gdevic/A-Z80/docs/Spectrum-VGA-timings.xlsx

Sheet: Graphical
 |  | Sinclair ZX Spectrum on FPGA
 |  | VGA timings
 |  |  | Display area in 8x8 characters: |  |  | 32 | 24
 |  |  | Effective screen resolution: |  |  | 256 | 192 | doubled
 |  | 96 | 48 | 640 |  |  | 16
 |  | 96 | 48 | 64 | 512 | 64 | 16
2 | 2 |  |  |  | V-SYNC |  |  | 0
33 | 33 |  |  |  | BACK PORCH |  |  | 2
480 | 48 |  |  |  | Spectrum border |  |  | 35
 | 384 | H-SYNC | BACK PORCH |  | Spectrum display area (256x192) |  | FRONT PORCH | 83
 | 48 |  |  |  |  |  |  | 467
10 | 10 |  |  |  | FRONT PORCH |  |  | 515
 |  | 0 | 96 | 144 | 208 | 720 | 784 |  | 525
 |  |  |  |  |  |  |  | 800
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
