gdevic/A-Z80/docs/png/z80-address_pins.png

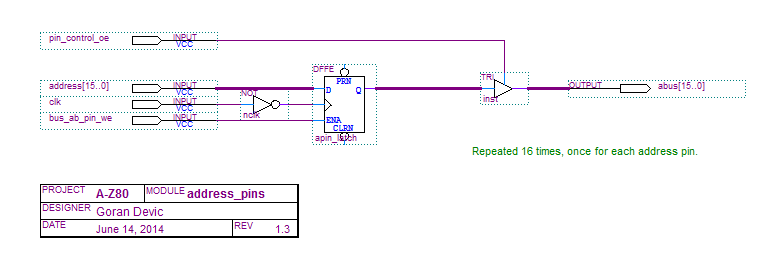
docs/png/z80-address_pins.png
