gdevic/A-Z80/docs/png/z80-alu.png

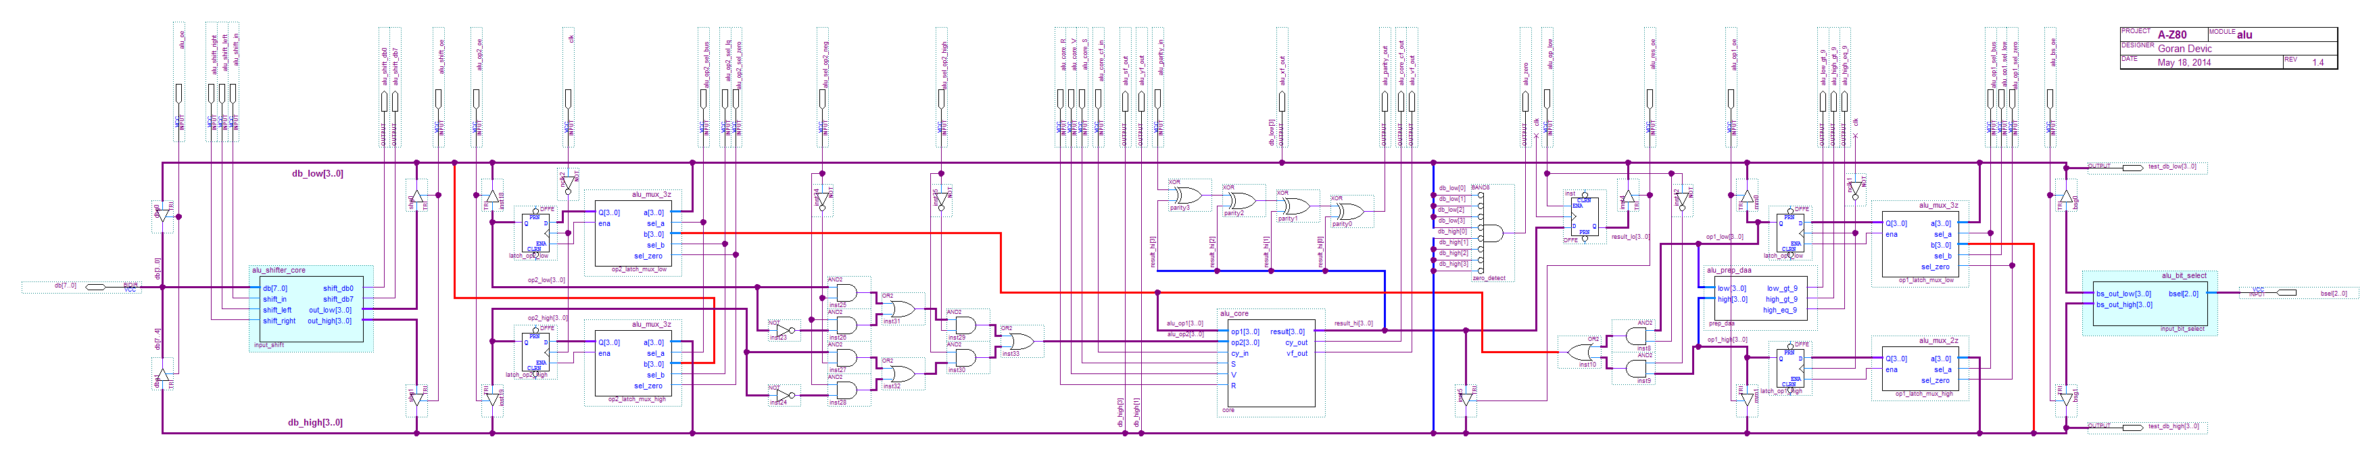
docs/png/z80-alu.png
