gdevic/A-Z80/docs/png/z80-alu_bit_select.png

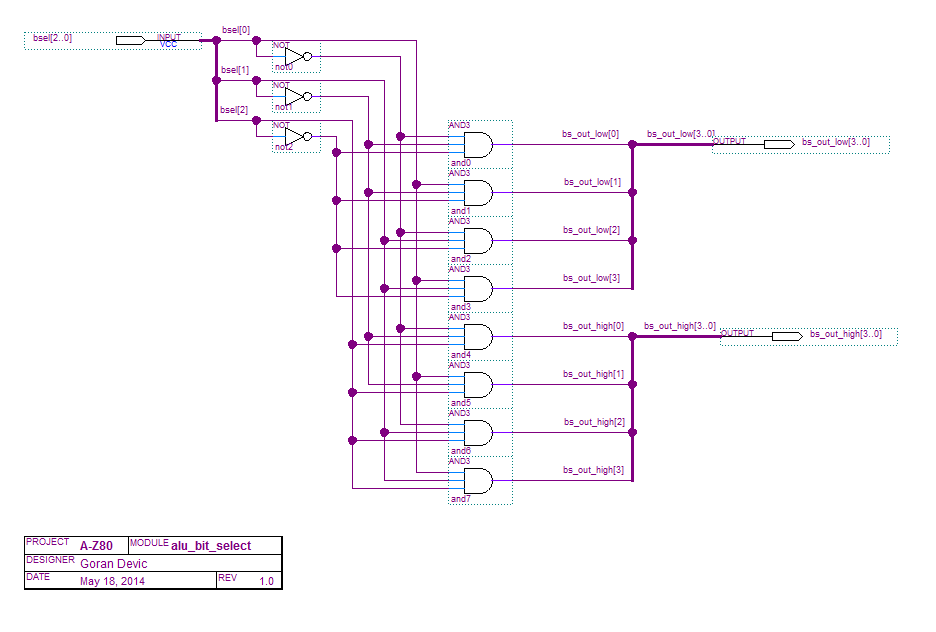
docs/png/z80-alu_bit_select.png
