gdevic/A-Z80/docs/png/z80-alu_control.png

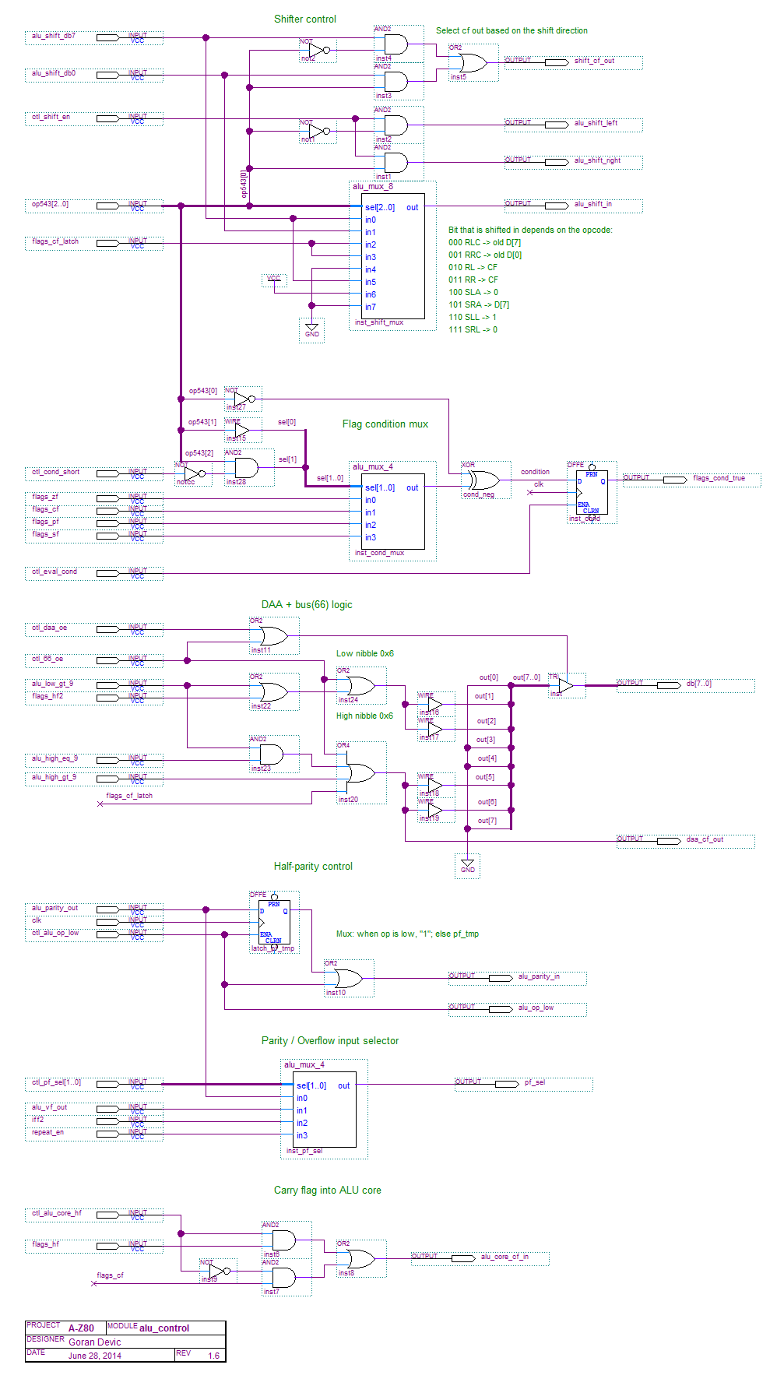
docs/png/z80-alu_control.png
