gdevic/A-Z80/docs/png/z80-alu_core.png

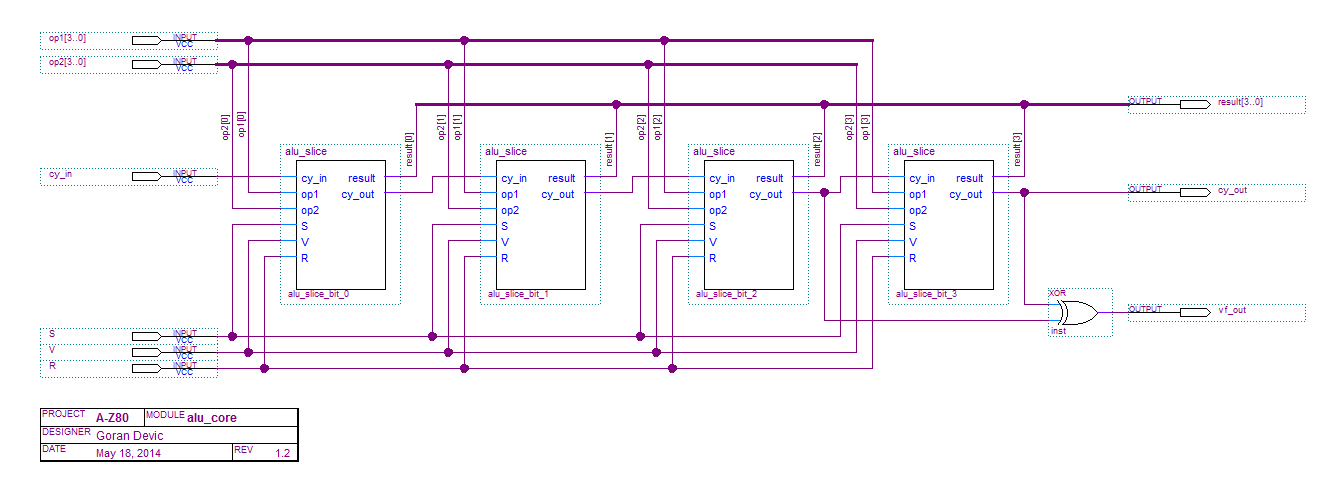
docs/png/z80-alu_core.png
