gdevic/A-Z80/docs/png/z80-alu_flags.png

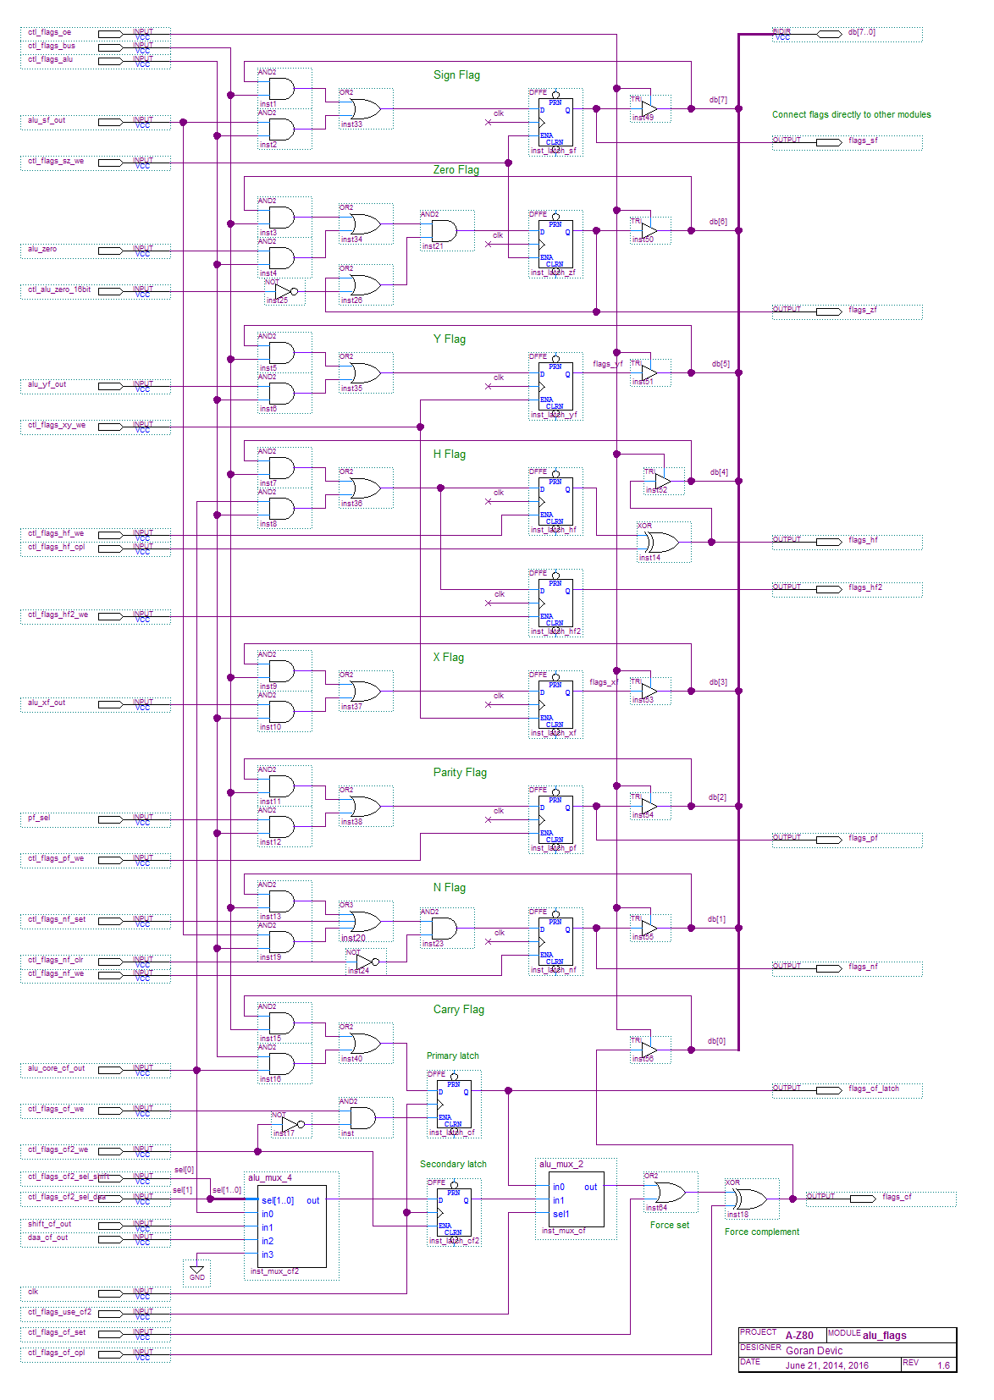
docs/png/z80-alu_flags.png
