gdevic/A-Z80/docs/png/z80-alu_mux_2z.png

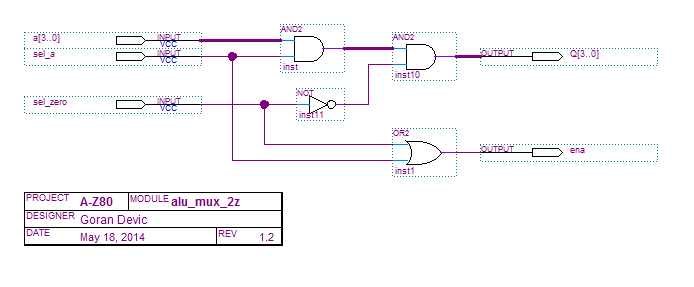
docs/png/z80-alu_mux_2z.png
