gdevic/A-Z80/docs/png/z80-alu_mux_3z.png

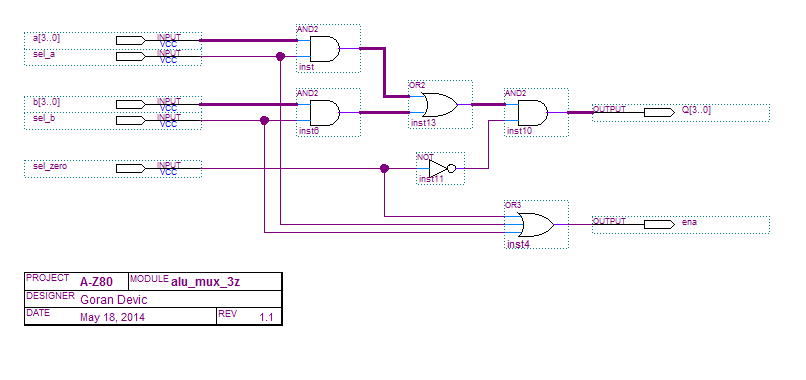
docs/png/z80-alu_mux_3z.png
