gdevic/A-Z80/docs/png/z80-alu_mux_8.png

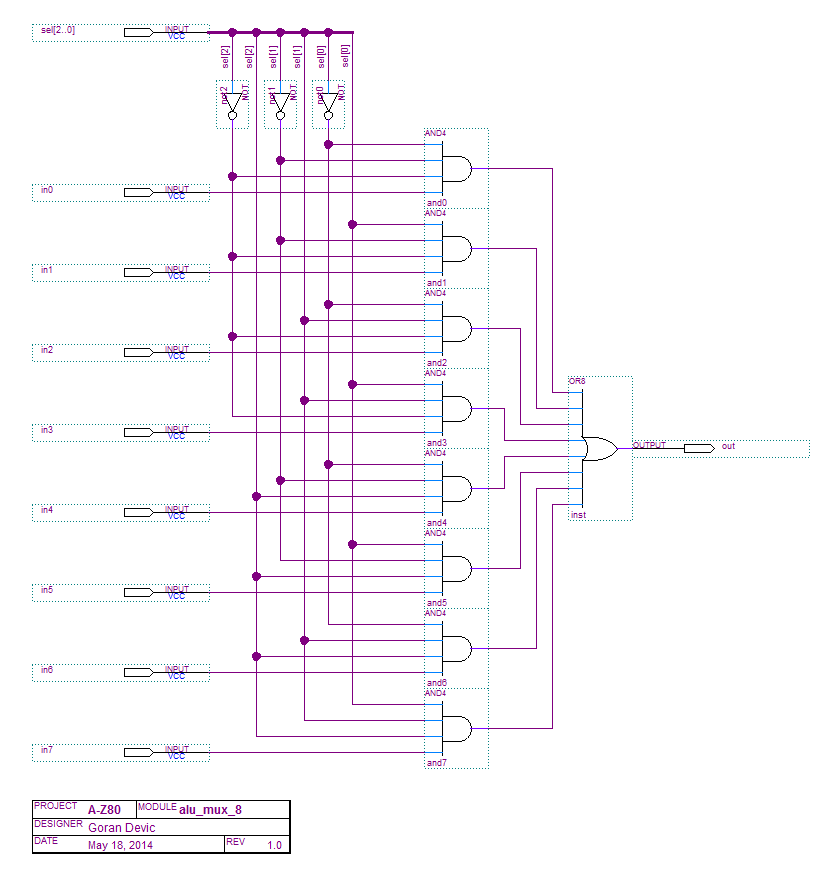
docs/png/z80-alu_mux_8.png
