gdevic/A-Z80/docs/png/z80-alu_prep_daa.png

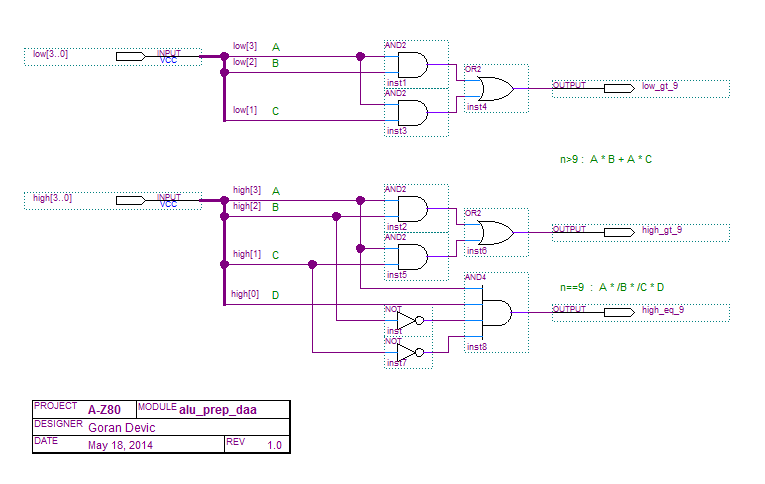
docs/png/z80-alu_prep_daa.png
