gdevic/A-Z80/docs/png/z80-alu_shifter_core.png

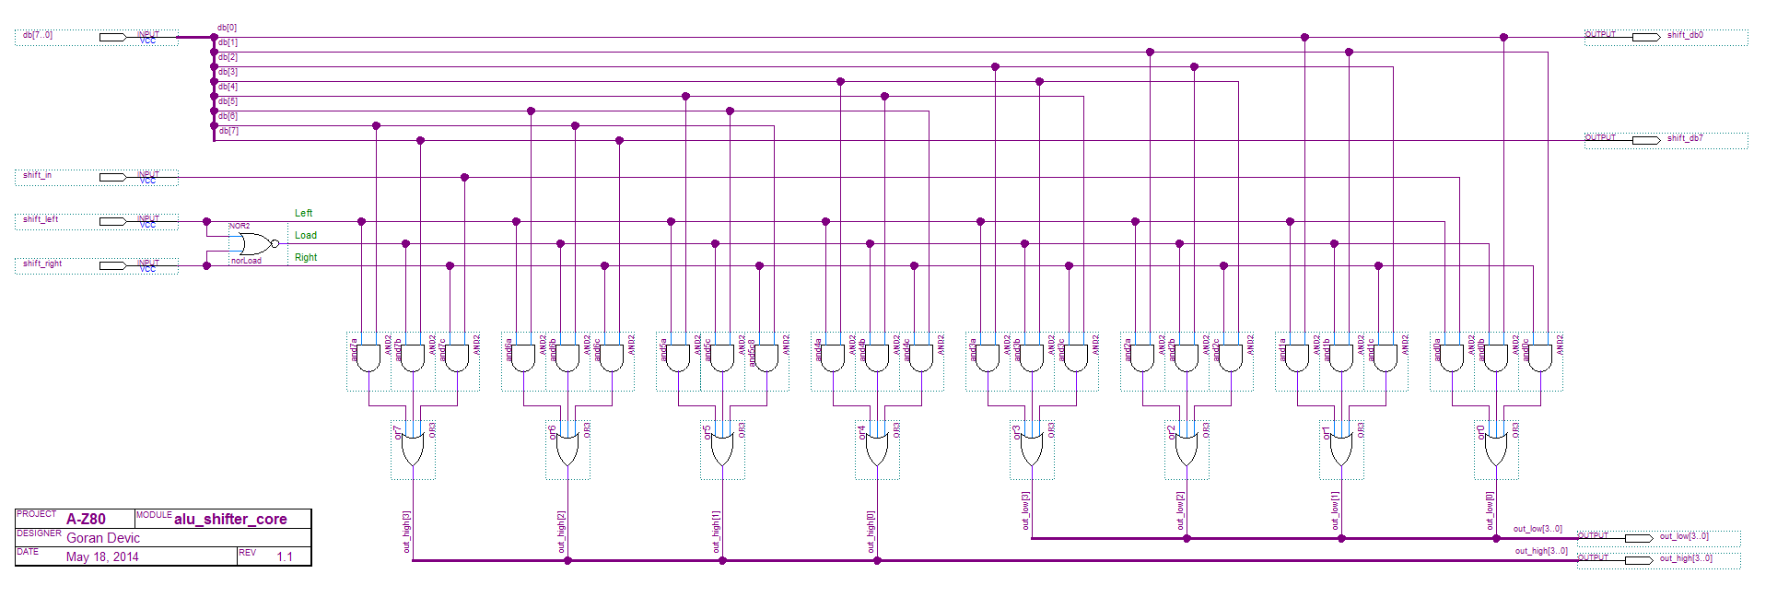
docs/png/z80-alu_shifter_core.png
