gdevic/A-Z80/docs/png/z80-alu_slice.png

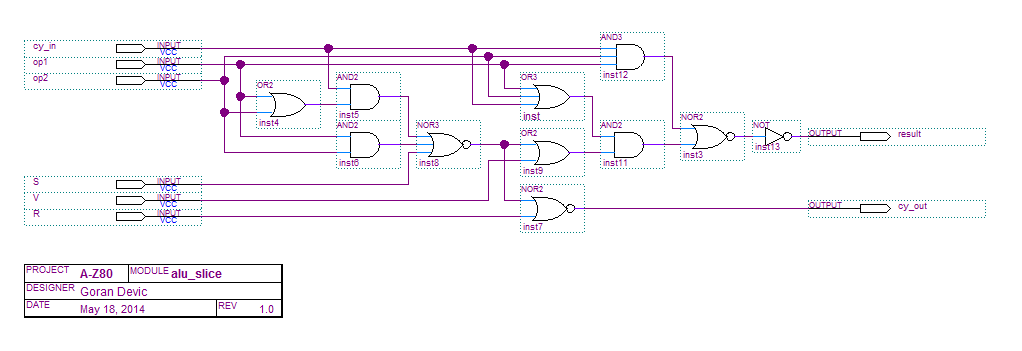
docs/png/z80-alu_slice.png
