gdevic/A-Z80/docs/png/z80-bus_control.png

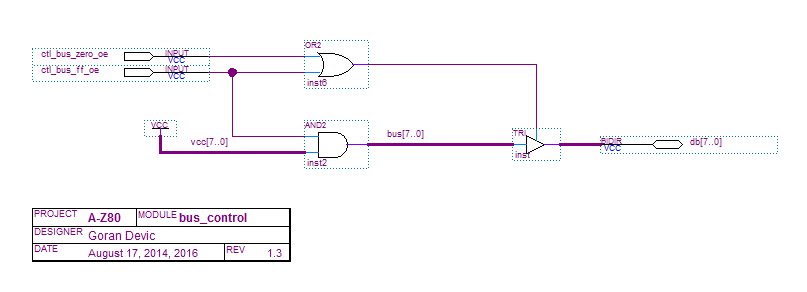
docs/png/z80-bus_control.png
