gdevic/A-Z80/docs/png/z80-clk_delay.png

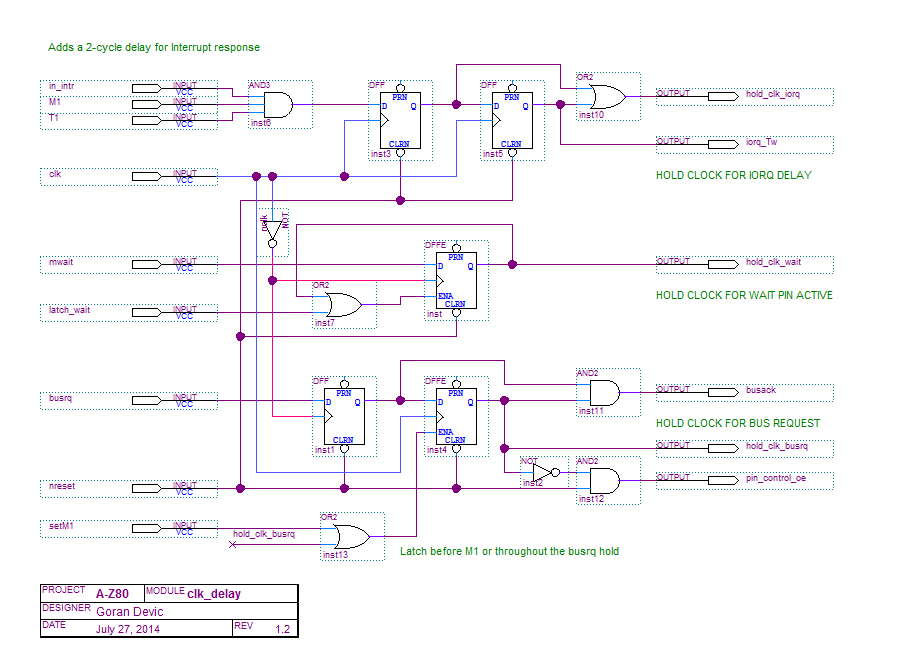
docs/png/z80-clk_delay.png
