gdevic/A-Z80/docs/png/z80-control_pins_n.png

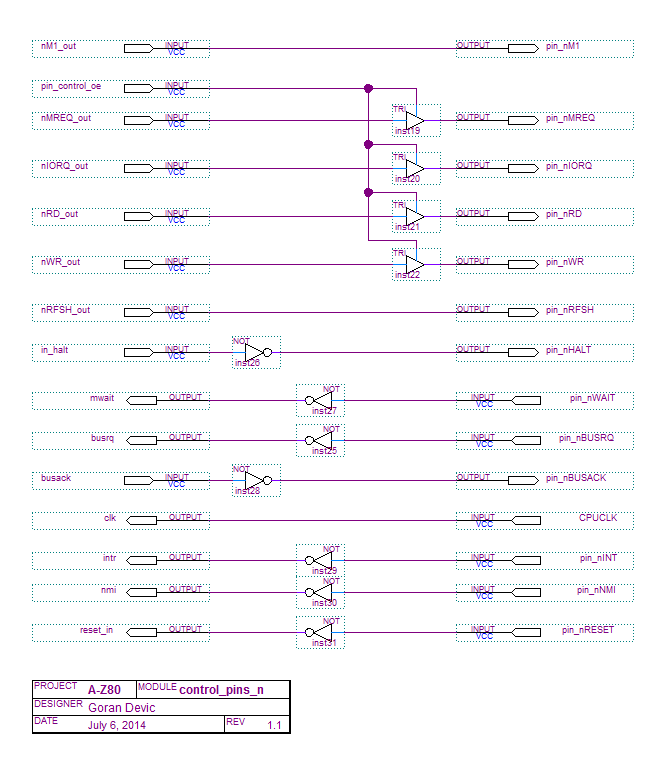
docs/png/z80-control_pins_n.png
