gdevic/A-Z80/docs/png/z80-data_pins.png

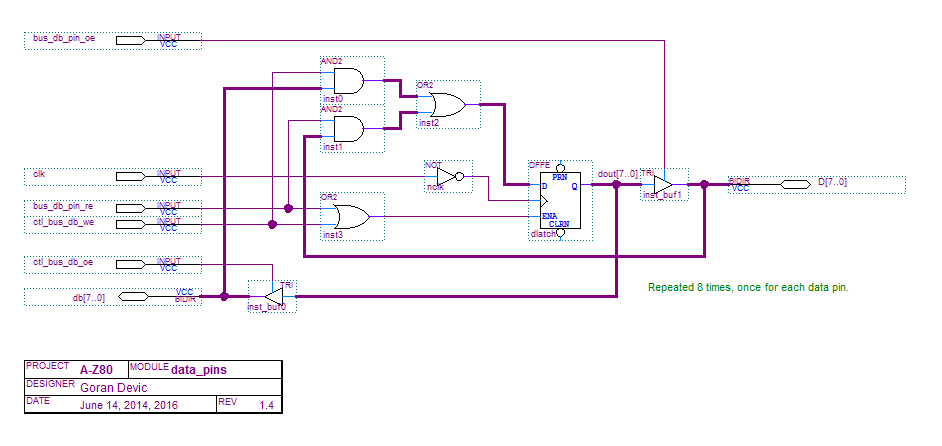
docs/png/z80-data_pins.png
