gdevic/A-Z80/docs/png/z80-data_switch.png

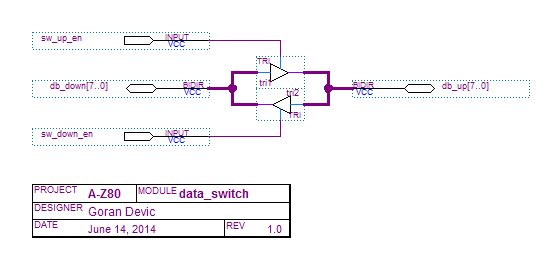
docs/png/z80-data_switch.png
