gdevic/A-Z80/docs/png/z80-data_switch_mask.png

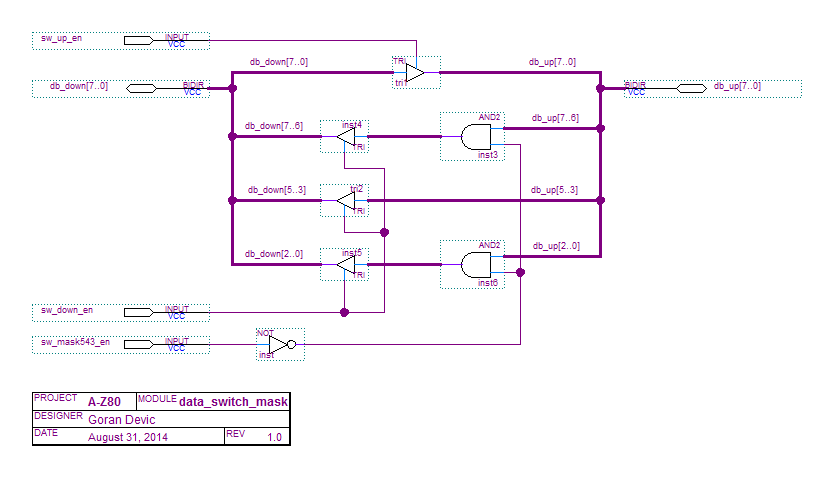
docs/png/z80-data_switch_mask.png
