gdevic/A-Z80/docs/png/z80-decode_state.png

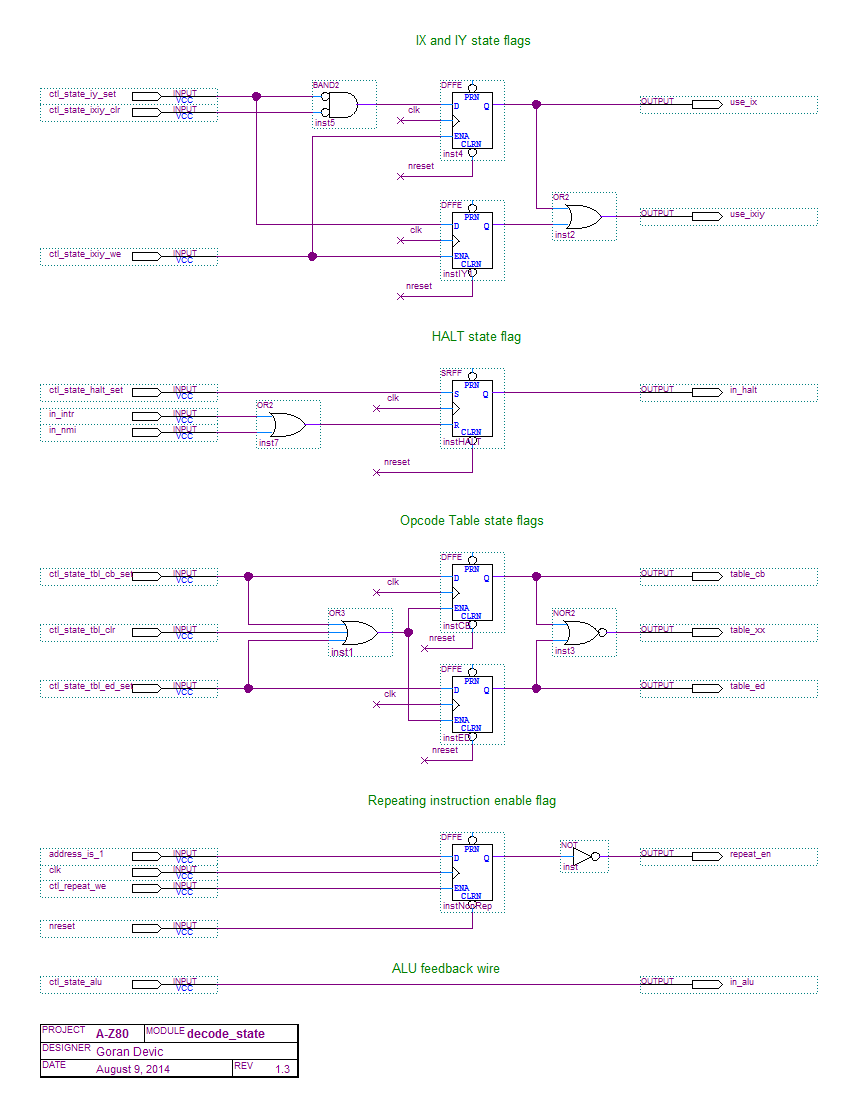
docs/png/z80-decode_state.png
