gdevic/A-Z80/docs/png/z80-inc_dec.png

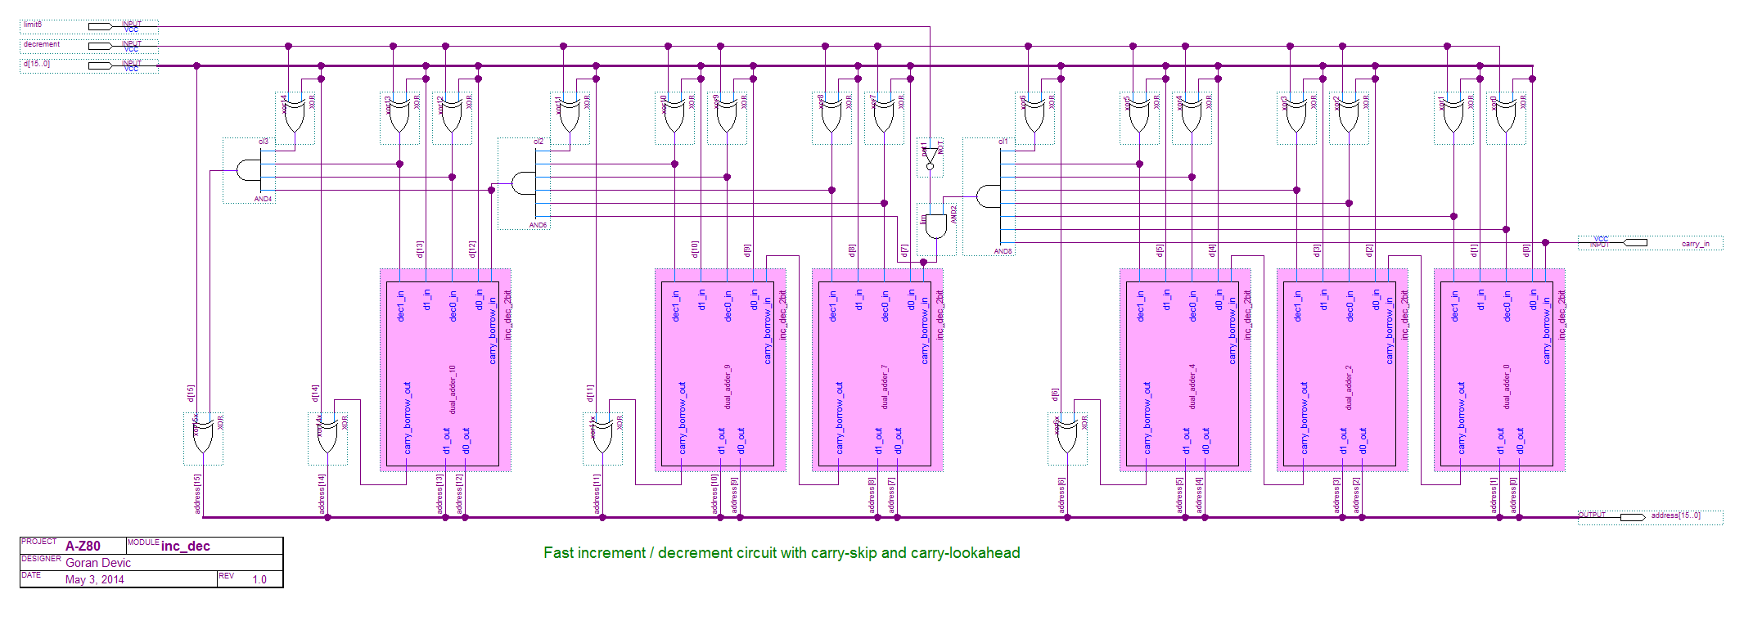
docs/png/z80-inc_dec.png
