gdevic/A-Z80/docs/png/z80-inc_dec_2bit.png

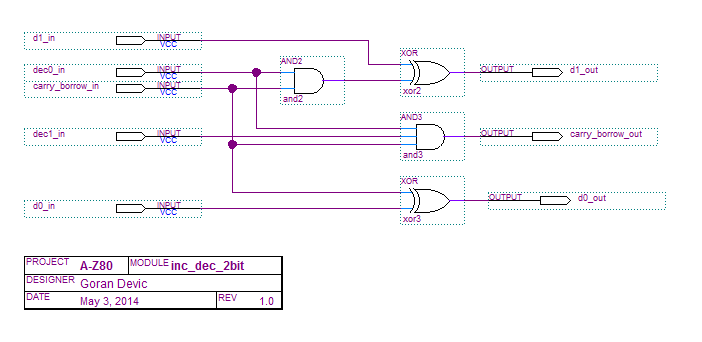
docs/png/z80-inc_dec_2bit.png
