gdevic/A-Z80/docs/png/z80-interrupts.png

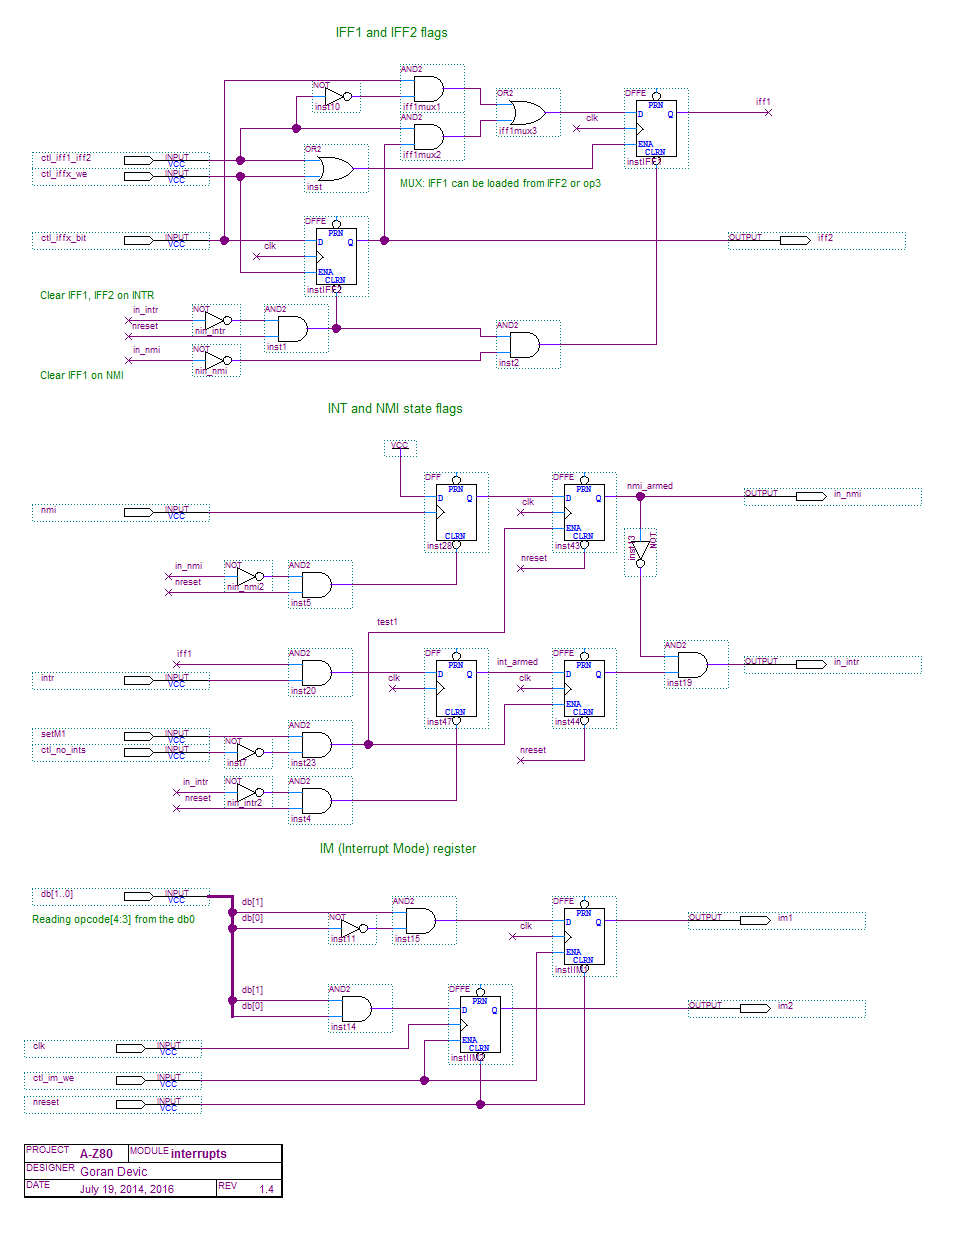
docs/png/z80-interrupts.png
