gdevic/A-Z80/docs/png/z80-ir.png

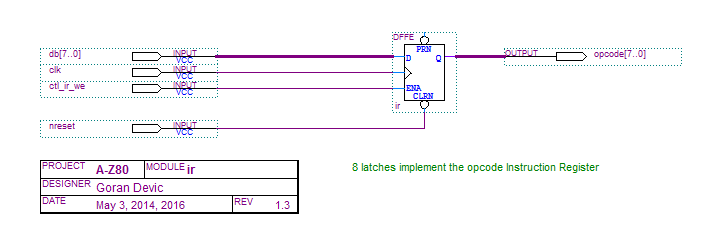
docs/png/z80-ir.png
