gdevic/A-Z80/docs/png/z80-memory_ifc.png

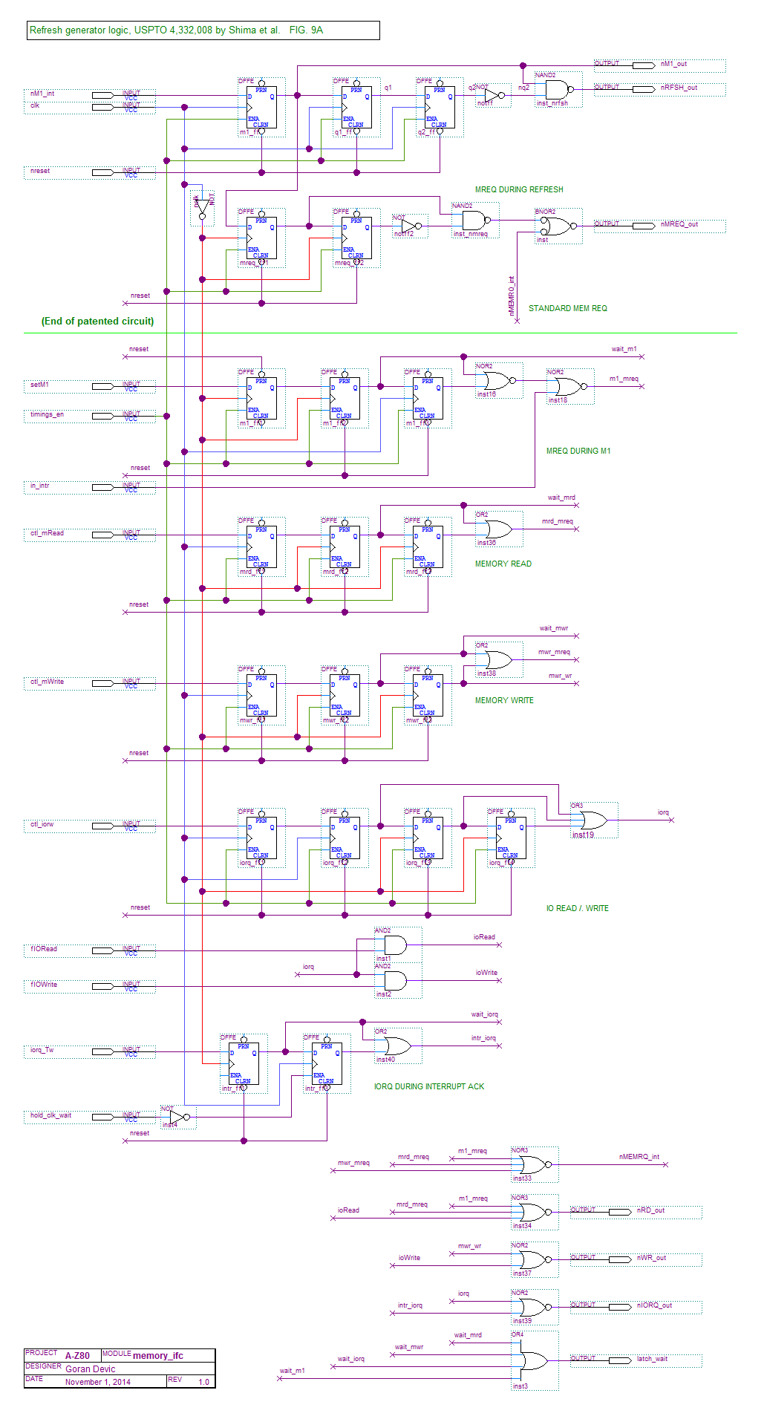
docs/png/z80-memory_ifc.png
