gdevic/A-Z80/docs/png/z80-pin_control.png

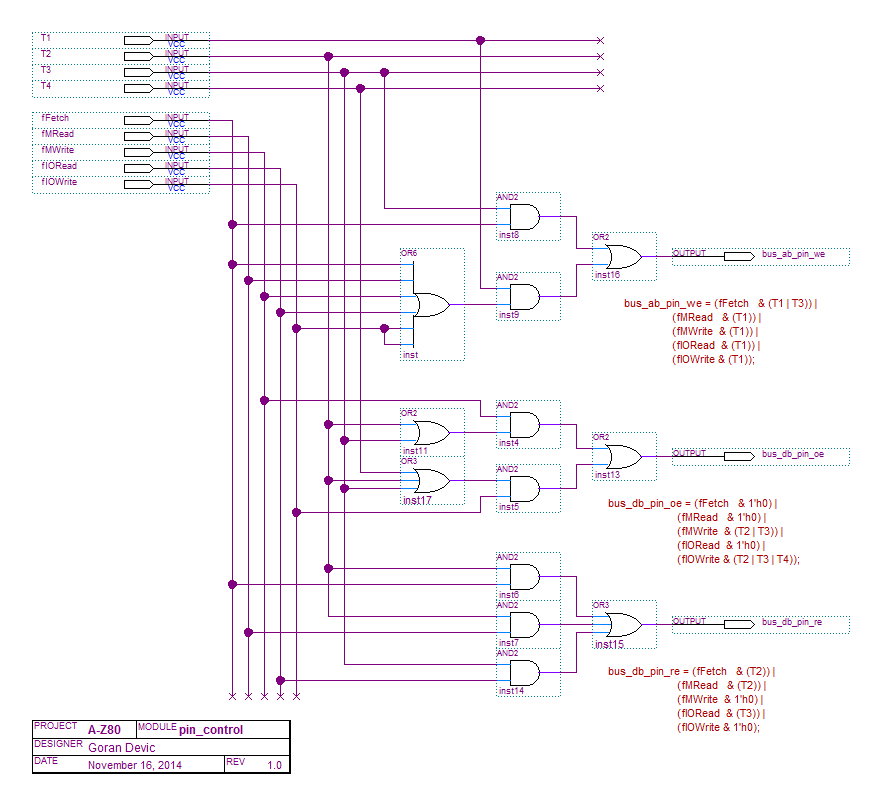
docs/png/z80-pin_control.png
