gdevic/A-Z80/docs/png/z80-reg_control.png

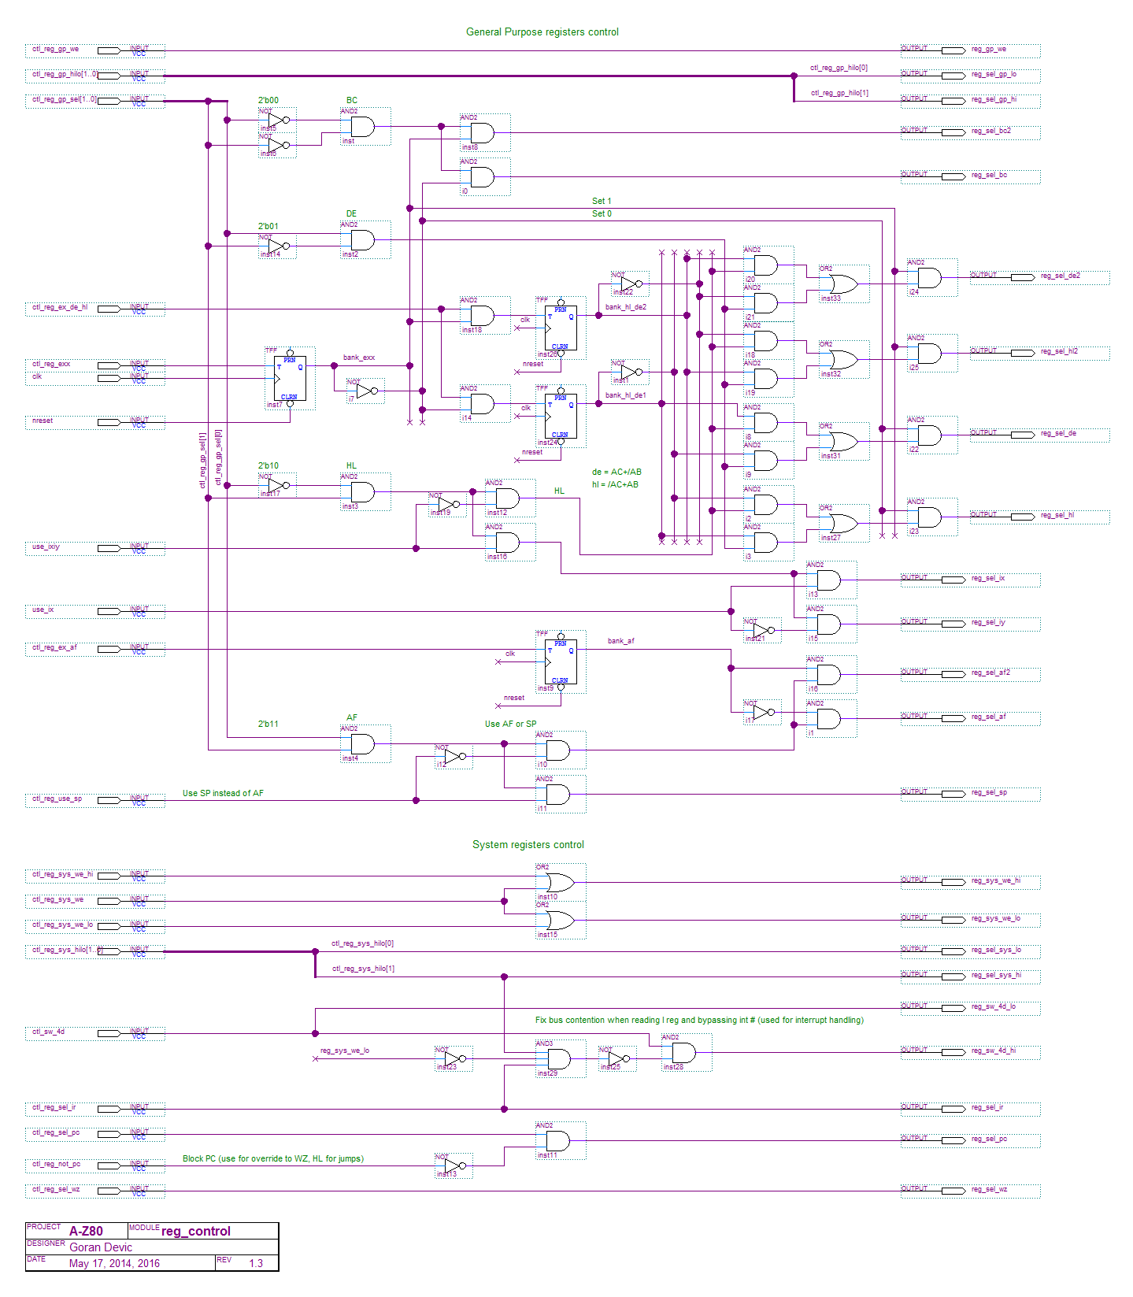
docs/png/z80-reg_control.png
