gdevic/A-Z80/docs/png/z80-reg_file.png

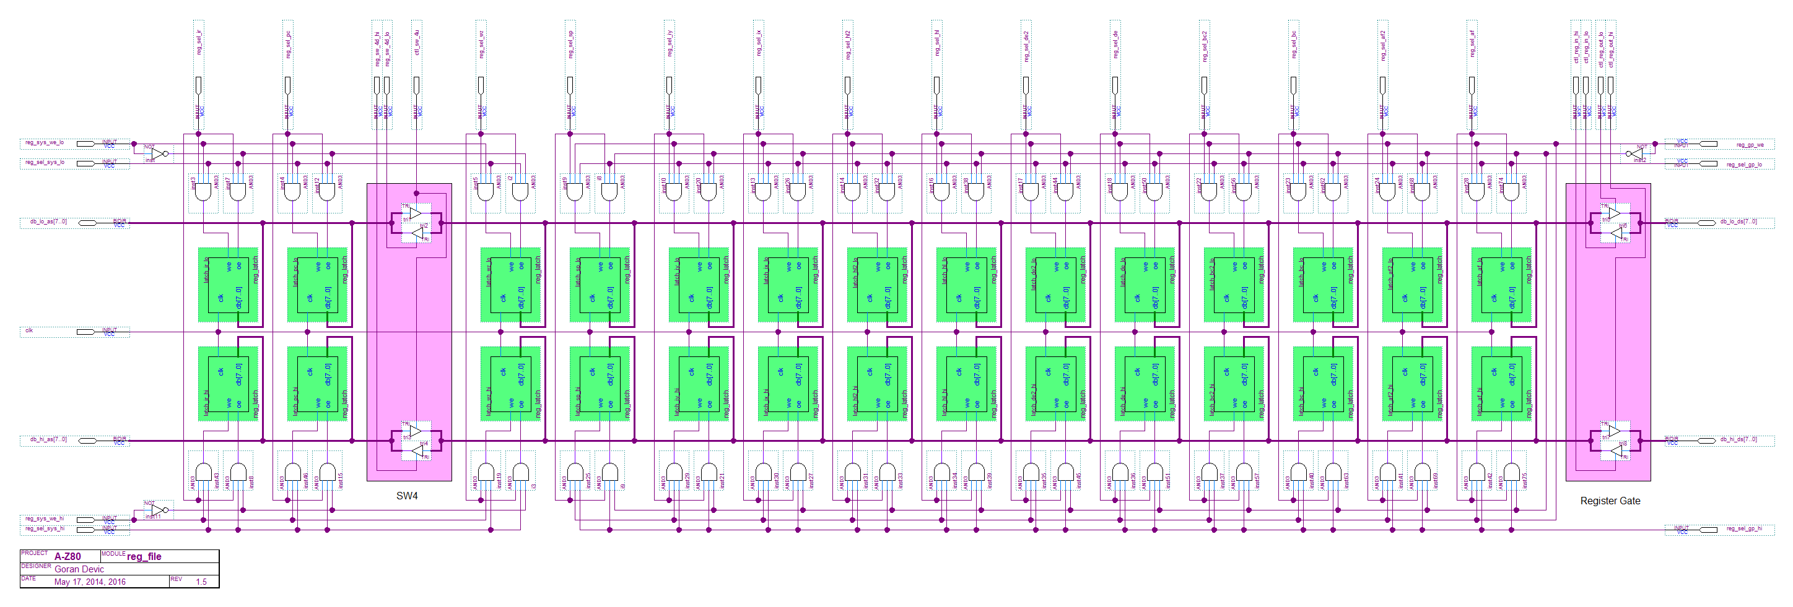
docs/png/z80-reg_file.png
