gdevic/A-Z80/docs/png/z80-reg_latch.png

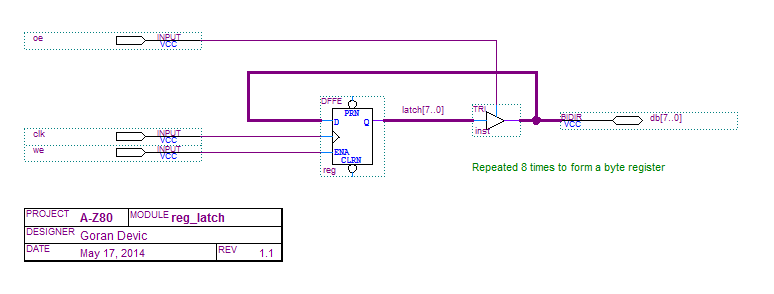
docs/png/z80-reg_latch.png
