gdevic/A-Z80/docs/png/z80-resets.png

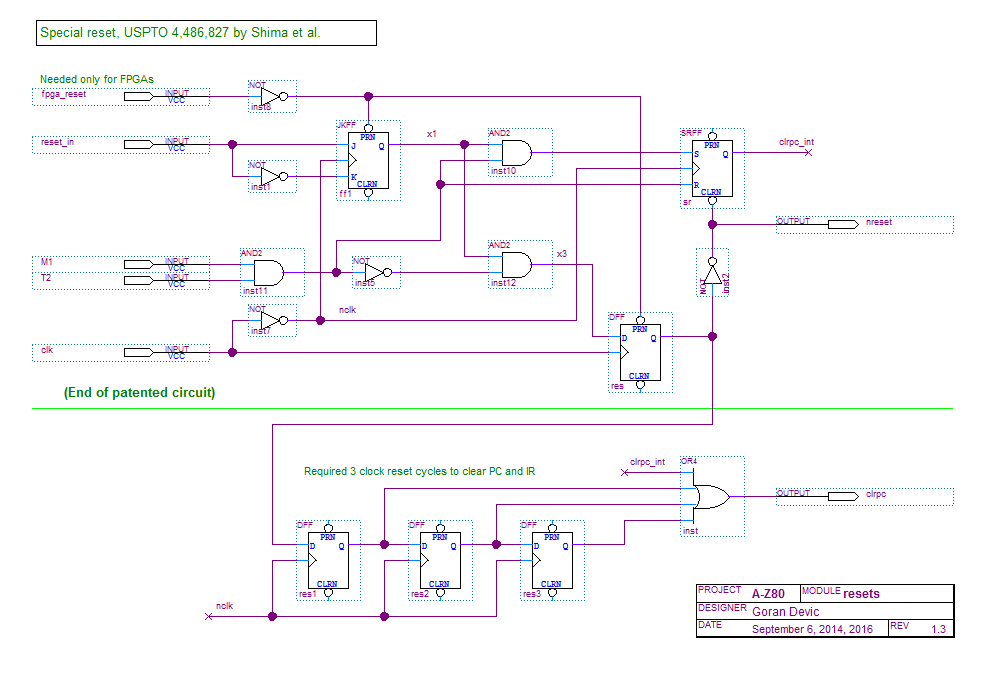
docs/png/z80-resets.png
