gdevic/A-Z80/docs/png/z80-sequencer.png

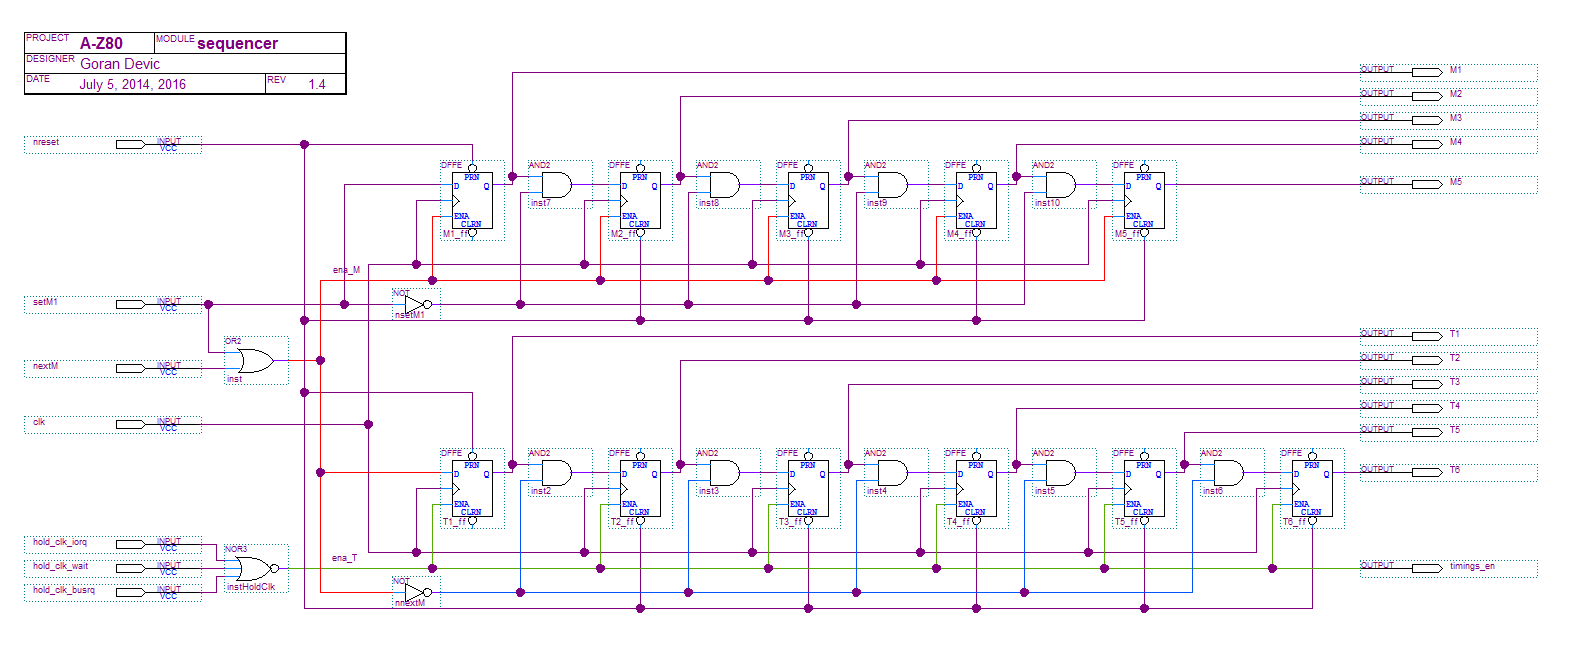
docs/png/z80-sequencer.png
