gdevic/A-Z80/(list of files, cad)

Other CAD files:
host/toplevel/logic_analyzer.stp
