gdevic/A-Z80/(threads)

Thread 1 (2018-03-28):

Some PDFs of the schematics are cropped

edevaldo, 2018-03-28:
The pdf of the schematic of the register file and at least another one are cropped. The pngs seems to be fine though.

edevaldo, 2018-03-29:
It was my mistake actually. For some reason my pdf viewer was not showing me the second page.

gdevic, 2018-03-29:
Some of the schematics (and the images that are checked in) are outdated!
Regards

      From: Edevaldo Pereira da Silva Junior <notifications@github.com>
 To: gdevic/A-Z80 <A-Z80@noreply.github.com>
Cc: Subscribed <subscribed@noreply.github.com>
 Sent: Thursday, March 29, 2018 9:45 AM
 Subject: Re: [gdevic/A-Z80] Some PDFs of the schematics are cropped (#1)

It was my mistake actually. For some reason my pdf viewer was not showing me the second page.—
You are receiving this because you are subscribed to this thread.
Reply to this email directly, view it on GitHub, or mute the thread.

Closed 2018-03-29.

Thread 2 (2022-01-21):

M1 asserted during bus acknowledge cycles

Noah1989, 2022-01-21:
It seems like the M1 signal is pulled low during bus acknowledge, which would break DMA to IO devices, since they could interpret the I/O request as an interrupt acknowledge. I have no original Z80 on hand right now, but I checked using Z80 explorer that M1 should indeed be high when BUSAK goes low.

Thread 3 (2023-10-03):

Data pin latching

kopavel, 2023-10-03:
By Z-80 specification Data pins are sampled (latch-ed) in the beginning of T3 for Op-Code fetching or in the middle of T3 for Memory/IO read.
By this project implementation it ALWAYS are fetched in the middle of T2.
It's way to early! In the middle of T2 WAIT bus are sampled, and if it's LOW - extra Tw are added between T2 and T3 until WAIT go HIGH.
That's why Data pins always sampled in T3 and never in T2.
Why that? It that is unspecified declination from specification in Z-80 chip or just error in that particular project?
