gdevic/A-Z80/docs/pdf/address_pins.pdf

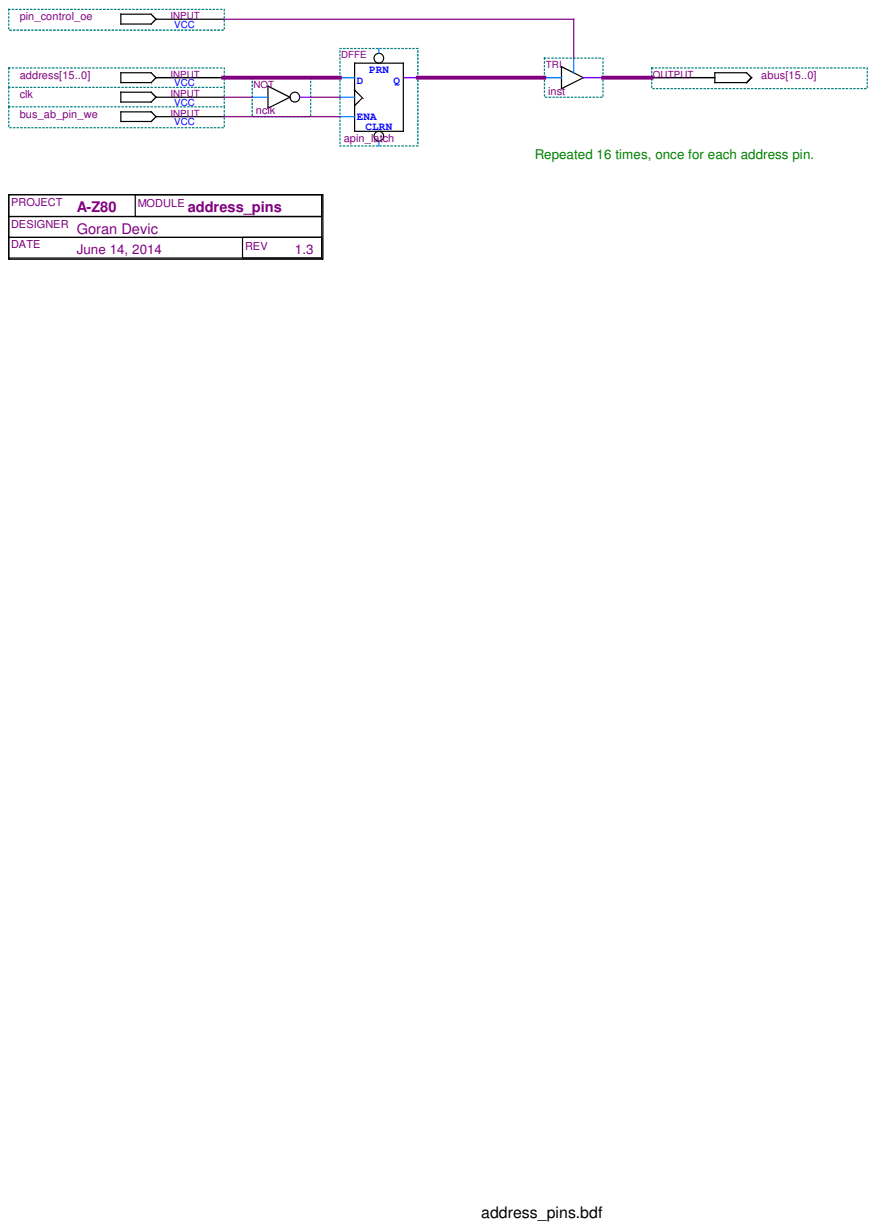
[picture p56: page 1]
address_pins.bdf; VCC; address[15..0]; INPUT; clk; VCC bus_ab_pin_we; pin_control_oe; OUTPUT; abus[15..0]; TRI; inst; PRN; CLRN; ENA; DFFE; apin_latch; NOT; nclk; PROJECT; MODULE address_pins; DATE; June 14, 2014; REV

Repeated 16 times, once for each address pin.

DESIGNER Goran Devic
