gdevic/A-Z80/docs/pdf/data_pins.pdf

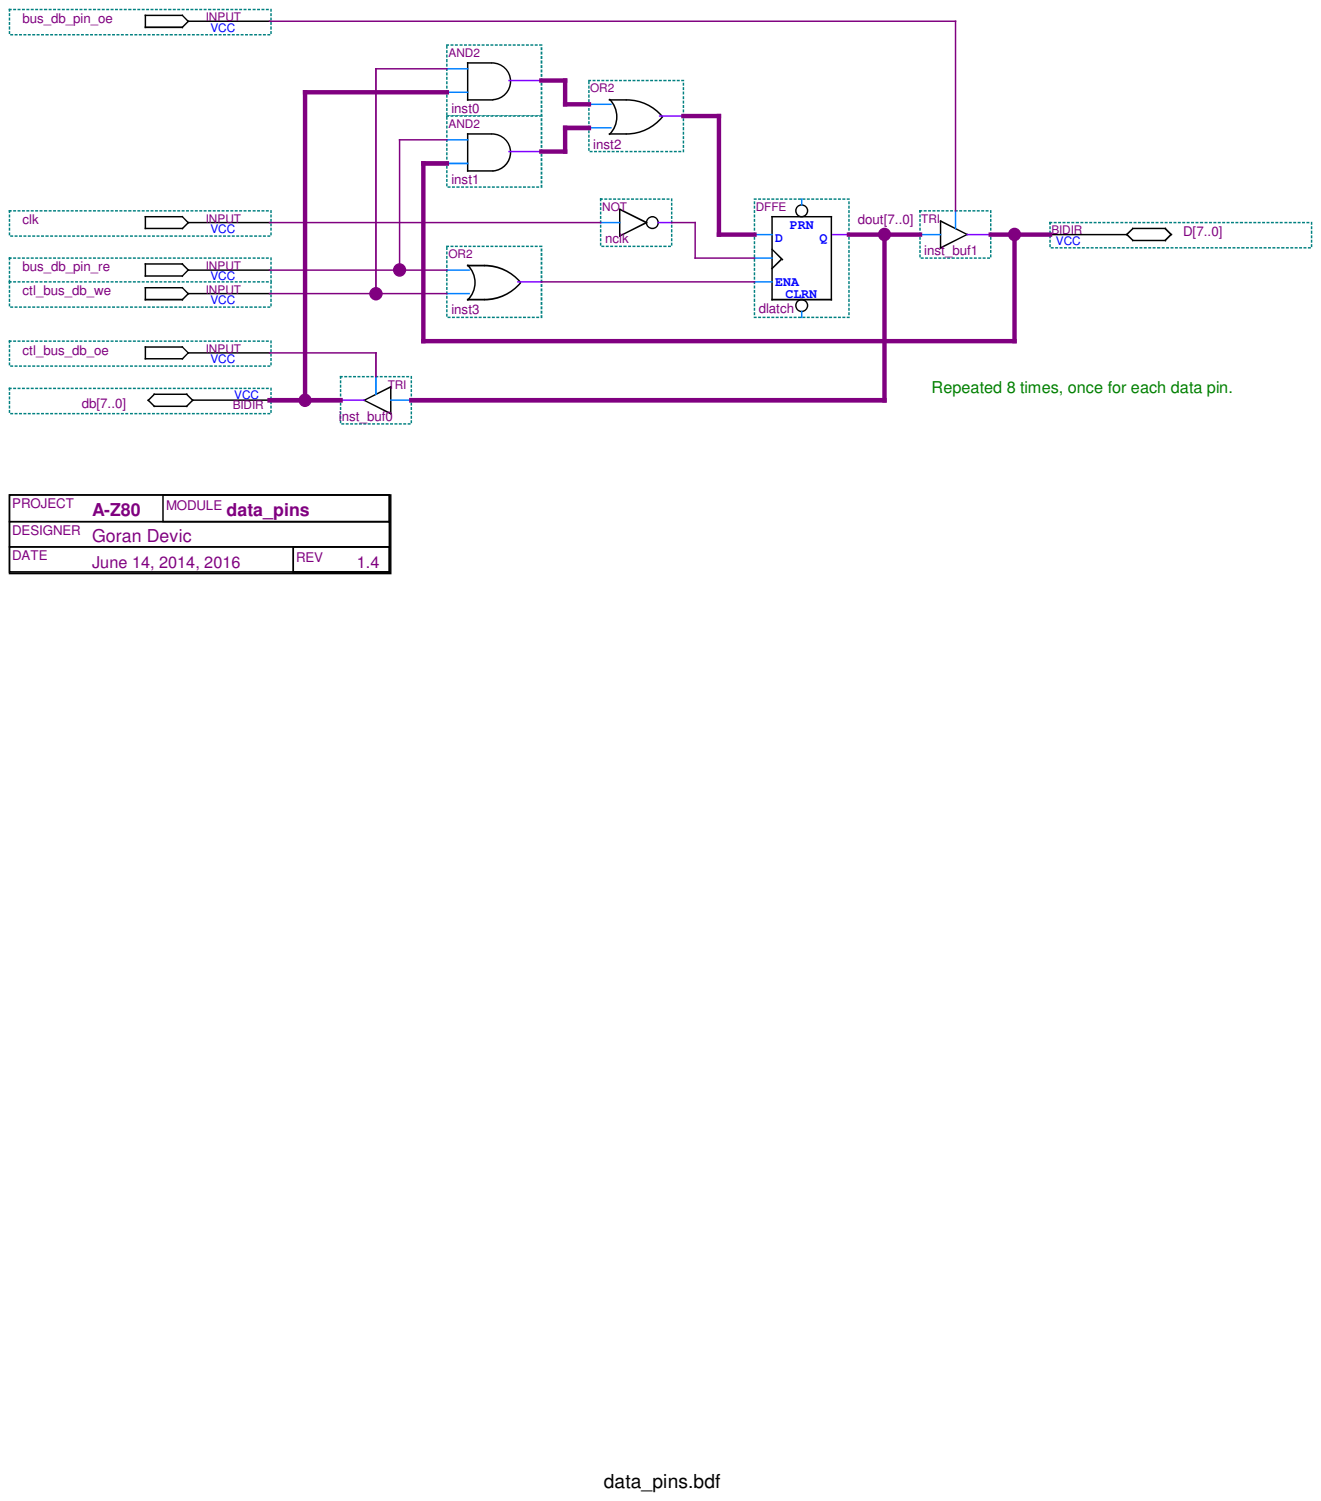
[picture p58: page 1]
data_pins.bdf; dout[7..0]; VCC; bus_db_pin_oe; INPUT; bus_db_pin_re; ctl_bus_db_we; clk; ctl_bus_db_oe; BIDIR; VCC db[7..0]; AND2; inst0 AND2; inst1; inst2; inst3; TRI; inst_buf0; inst_buf1; PRN; CLRN; ENA; DFFE; dlatch; NOT; nclk; DATE; June 14, 2014, 2016; MODULE data_pins PROJECT; REV

Repeated 8 times, once for each data pin.

DESIGNER Goran Devic
