gdevic/A-Z80/docs/pdf/a-z80-toplevel.pdf

## CONTROL UNIT

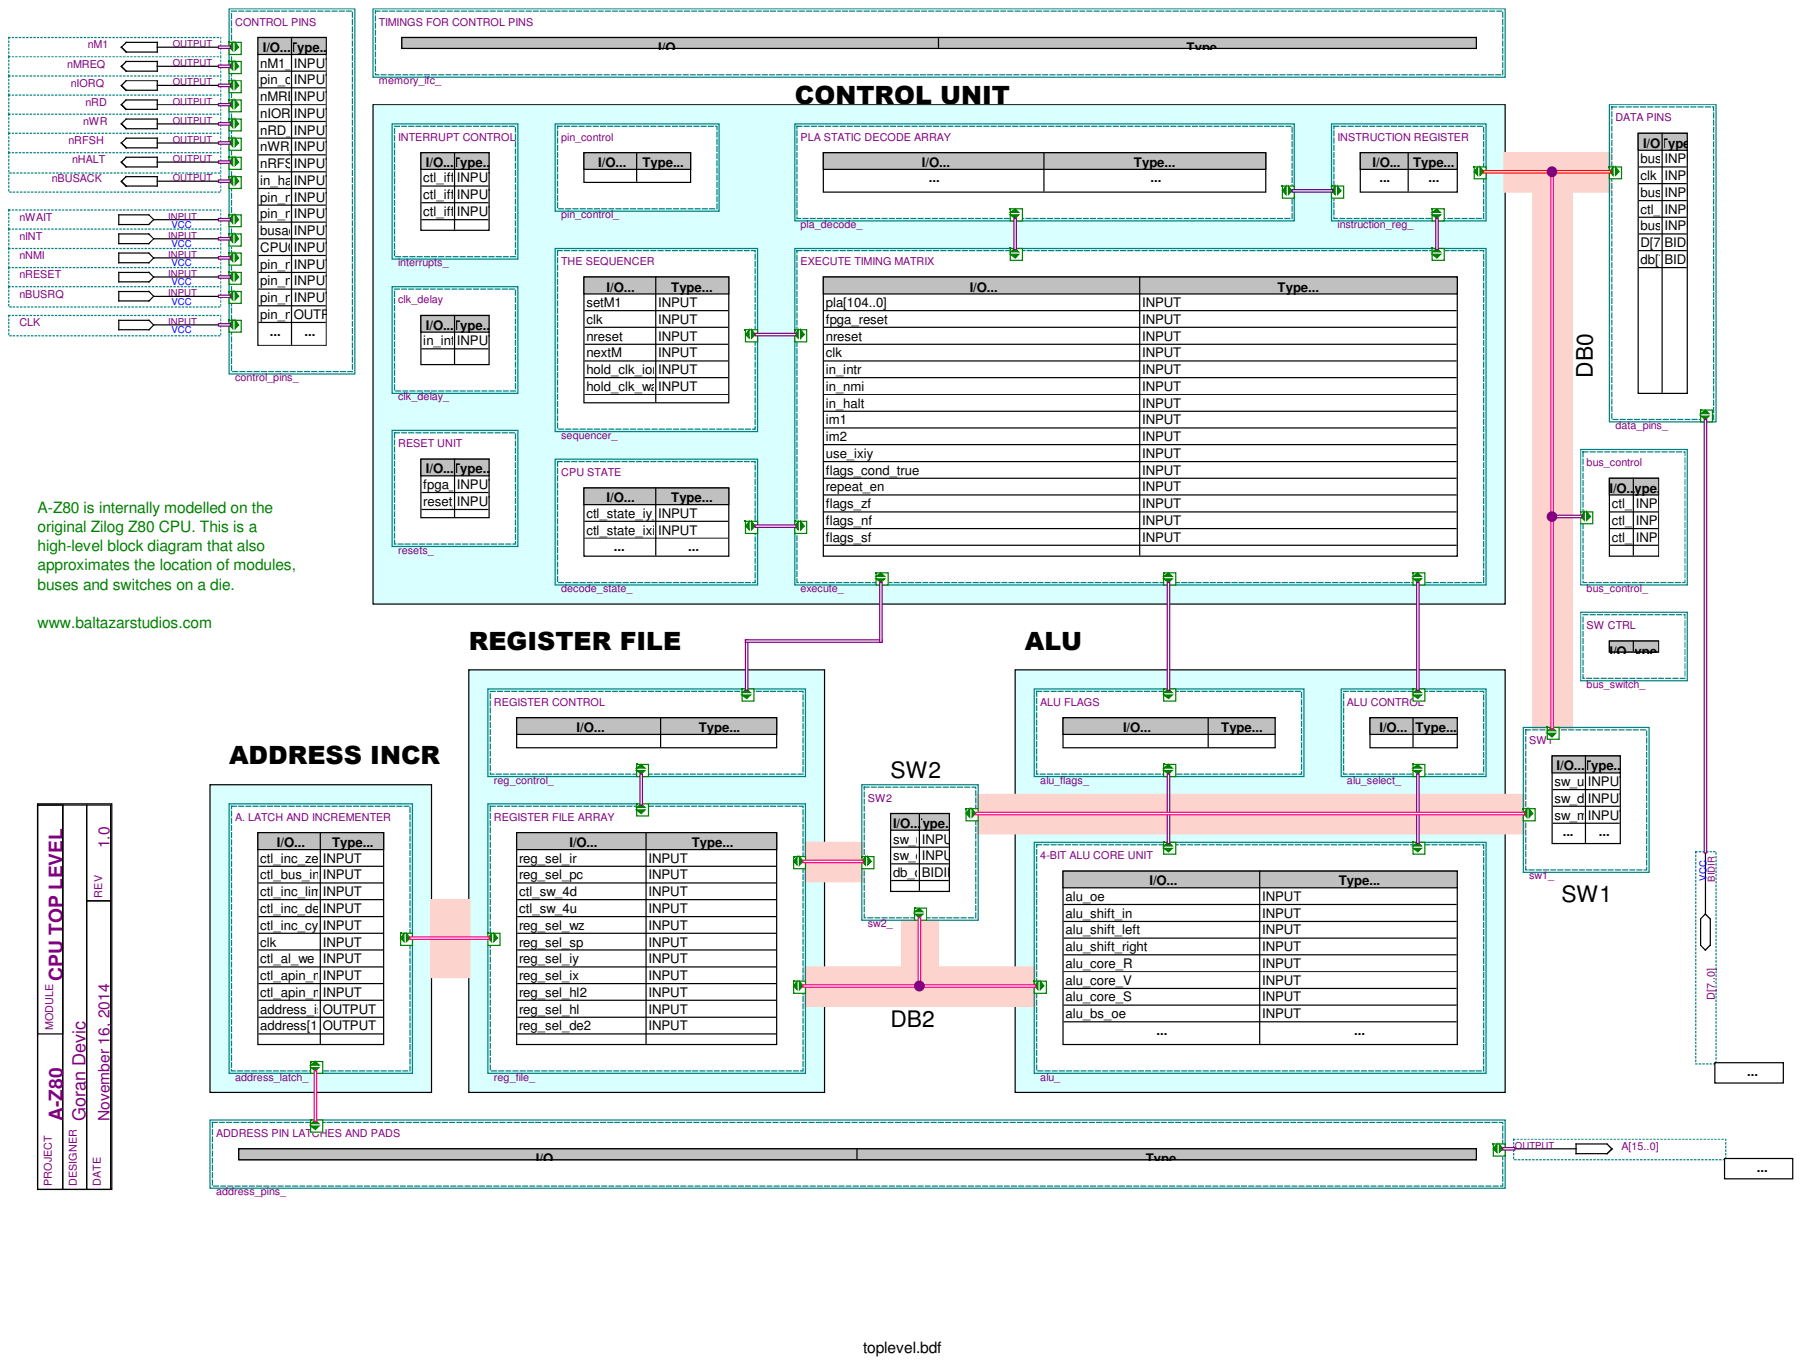
[picture p61: page 1]
toplevel.bdf; REGISTER FILE; ALU; ADDRESS INCR; VCC nWAIT; INPUT; VCC; nINT; nNMI; VCC nRESET; VCC nBUSRQ; VCC CLK; OUTPUT; nMREQ; nIORQ; nRD; nWR; nRFSH; nBUSACK; nHALT; pin_control; pin_control_; Type...; clk_delay; clk_delay_; in_intrINPUT; I/O...Type...; bus_control; bus_control_; ctl_bus_db_oe INPUT ctl_bus_zero_oe INPUT ctl_bus_ff_oe INPUT; I/O... Type...; sw_up_en INPUT sw_down_en INPUT sw_mask543_en INPUT; sw_up_en INPUT sw_down_en INPUT db_down[7..0] BIDIR; alu_; alu_oe; alu_shift_in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

TIMINGS FOR CONTROL PINS

I/O...Type...
nM1_out INPUT
pin_control_oe INPUT
nMREQ_out INPUT

PLA STATIC DECODE ARRAY

EXECUTE TIMING MATRIX

clk | INPUT
in_intr | INPUT
in_nmi | INPUT

A-Z80 is internally modelled on the
original Zilog Z80 CPU. This is a
high-level block diagram that also
approximates the location of modules,
buses and switches on a die.

www.baltazarstudios.com

A. LATCH AND INCREMENTER

REGISTER FILE ARRAY

MODULECPU TOP LEVEL

4-BIT ALU CORE UNIT

DESIGNER Goran Devic

ADDRESS PIN LATCHES AND PADS
