gdevic/A-Z80/docs/pdf/address_latch.pdf

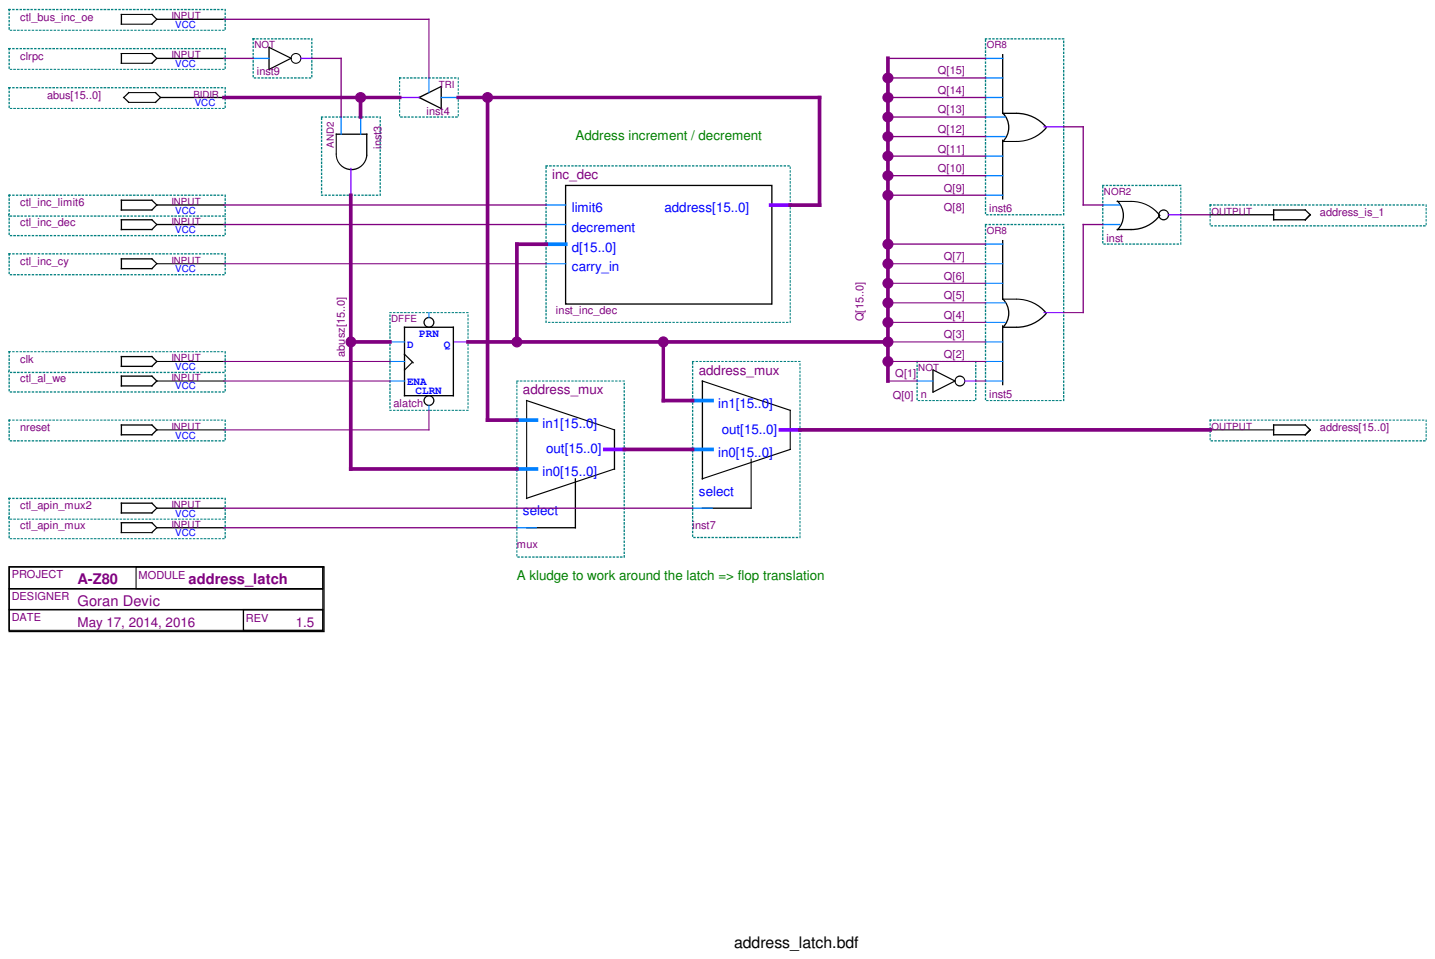
[picture p62: page 1]
address_latch.bdf; abusz[15..0]; VCC ctl_inc_cy; INPUT; VCC ctl_inc_dec; VCC ctl_al_we; VCC ctl_inc_limit6; VCC ctl_bus_inc_oe; VCC clk; VCC ctl_apin_mux; VCC ctl_apin_mux2; VCC clrpc; VCC nreset; OUTPUT; address[15..0]; address_is_1; VCC abus[15..0]; BIDIR; TRI; inst4; limit6 decrement d[15..0] carry_in; inc_dec; inst_inc_dec; PRN; CLRN; ENA; DFFE; alatch; inst5; inst6; NOT; NOR2; inst; select; out[15..0]; address_mux; mux; inst7; AND2; inst3; inst9; DATE; May 17, 2014, 2016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

Address increment / decrement

DESIGNER Goran Devic

A kludge to work around the latch => flop translation
