gdevic/A-Z80/docs/pdf/address_mux.pdf

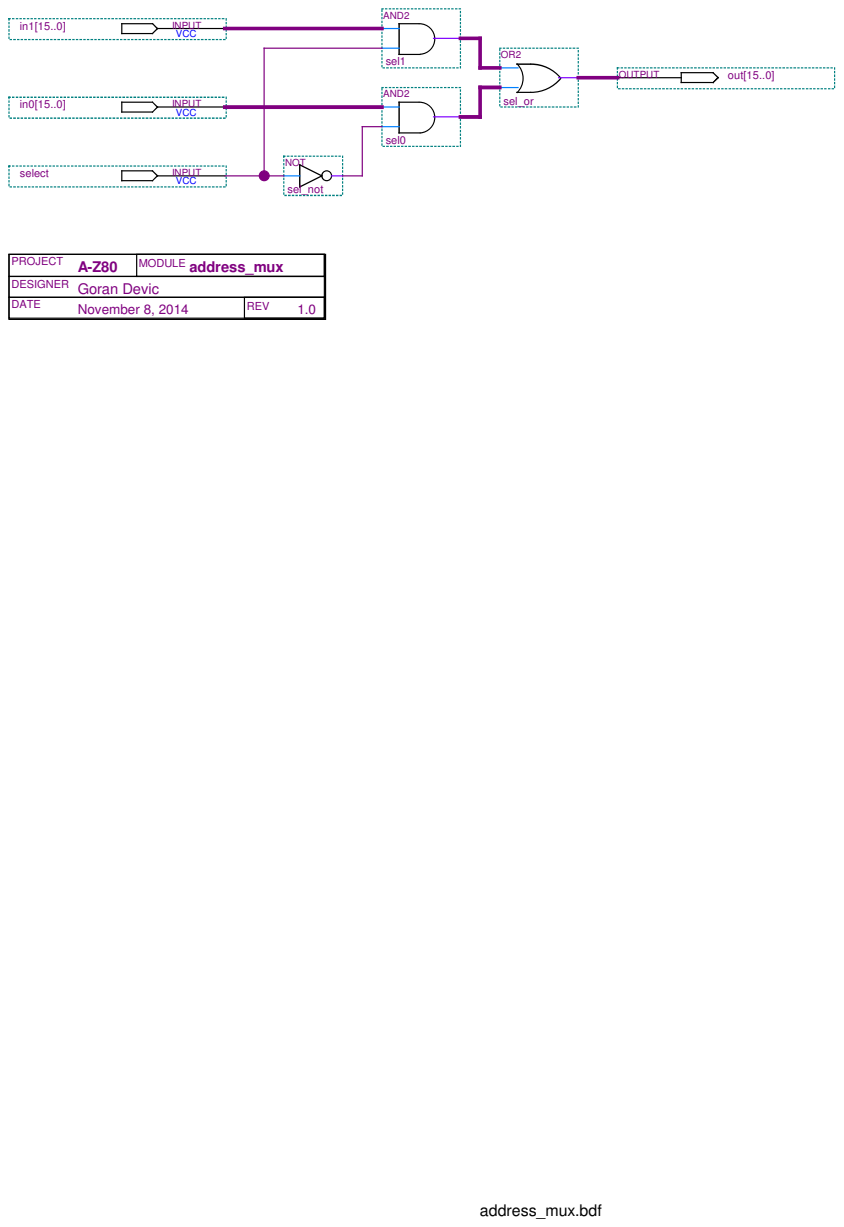
[picture p63: page 1]
address_mux.bdf; VCC; select; INPUT; OUTPUT; out[15..0]; AND2; sel1; sel0; sel_or; NOT; sel_not; PROJECT; MODULE address_mux; DATE; November 8, 2014; REV

DESIGNER Goran Devic
