gdevic/A-Z80/docs/pdf/alu.pdf

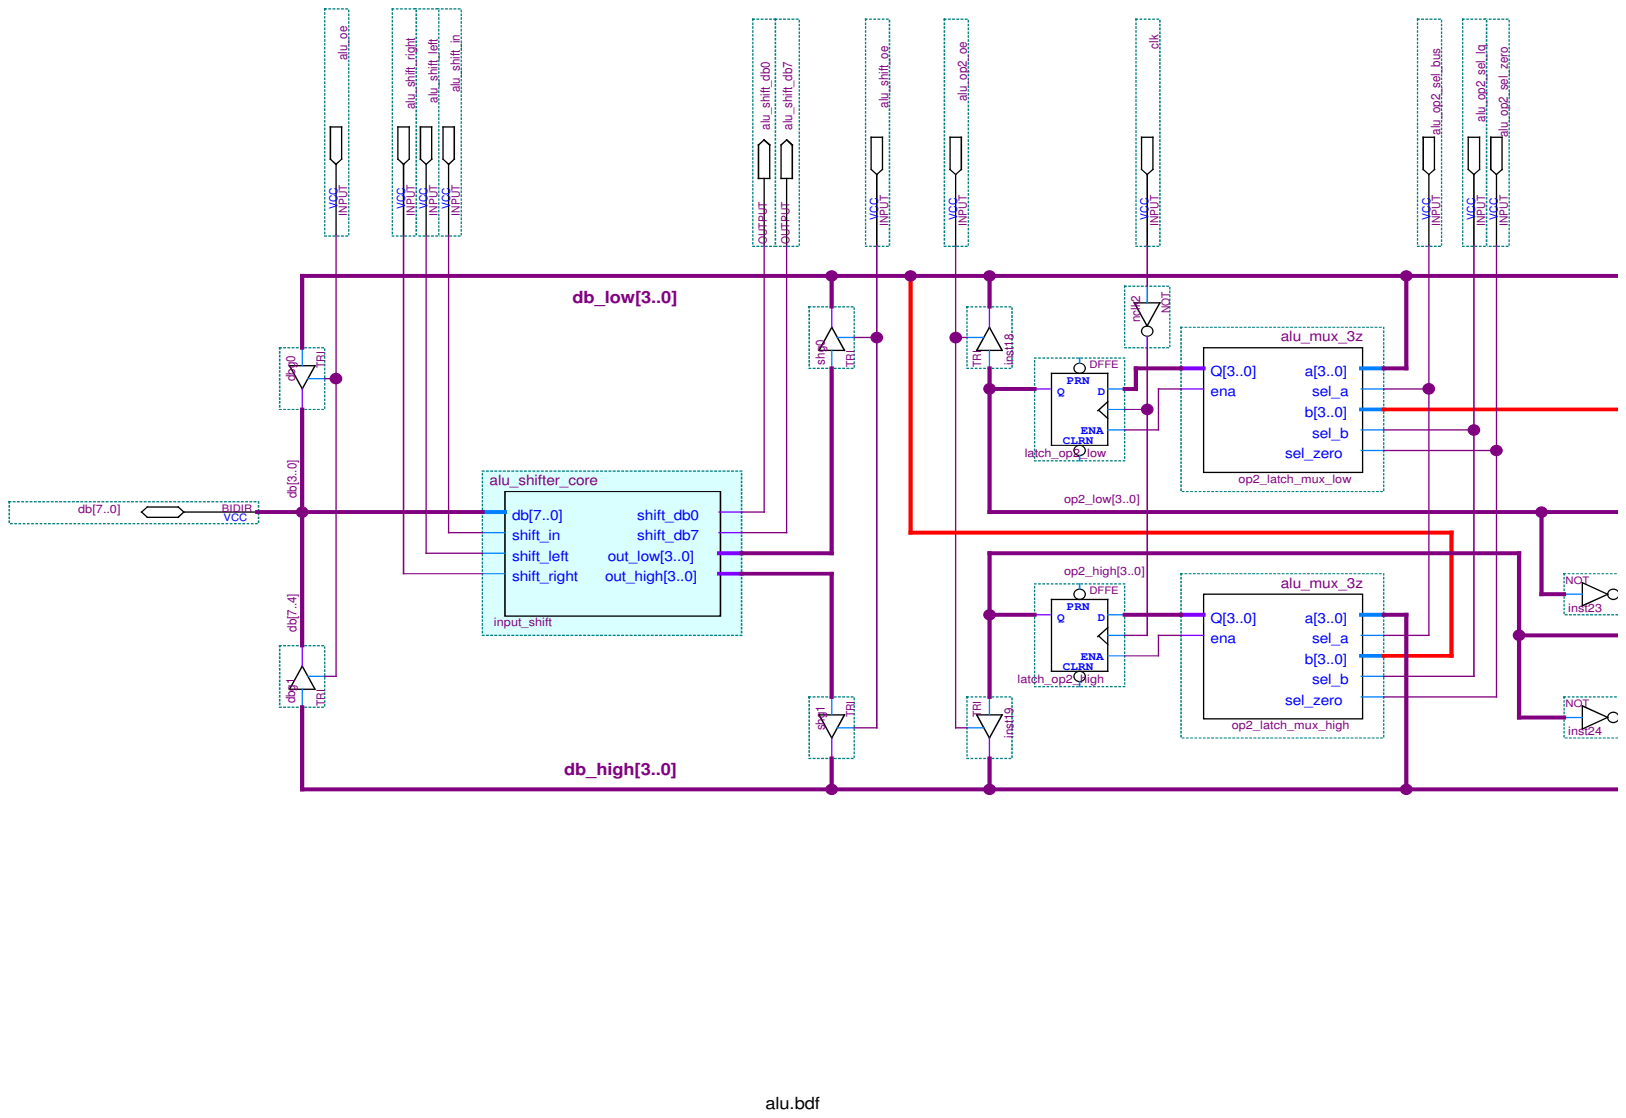
[picture p64: page 1]
alu.bdf; db_low[3..0]; db_high[3..0]; op2_high[3..0]; op2_low[3..0]; VCC; alu_oe INPUT; alu_shift_oe INPUT; alu_op2_oe INPUT; alu_op2_sel_zero INPUT; alu_op2_sel_bus INPUT; alu_op2_sel_lq INPUT; alu_shift_in INPUT; alu_shift_left INPUT; alu_shift_right INPUT; clk INPUT; alu_shift_db0 OUTPUT; alu_shift_db7 OUTPUT; VCC db[7..0]; BIDIR; NOT; inst23; inst24; TRI; inst18; inst19; shg0; TRI TRI; shg1; dbg0 dbg1; shift_in; shift_left; shift_right; shift_db0; shift_db7; out_low[3..0]; out_high[3..0]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

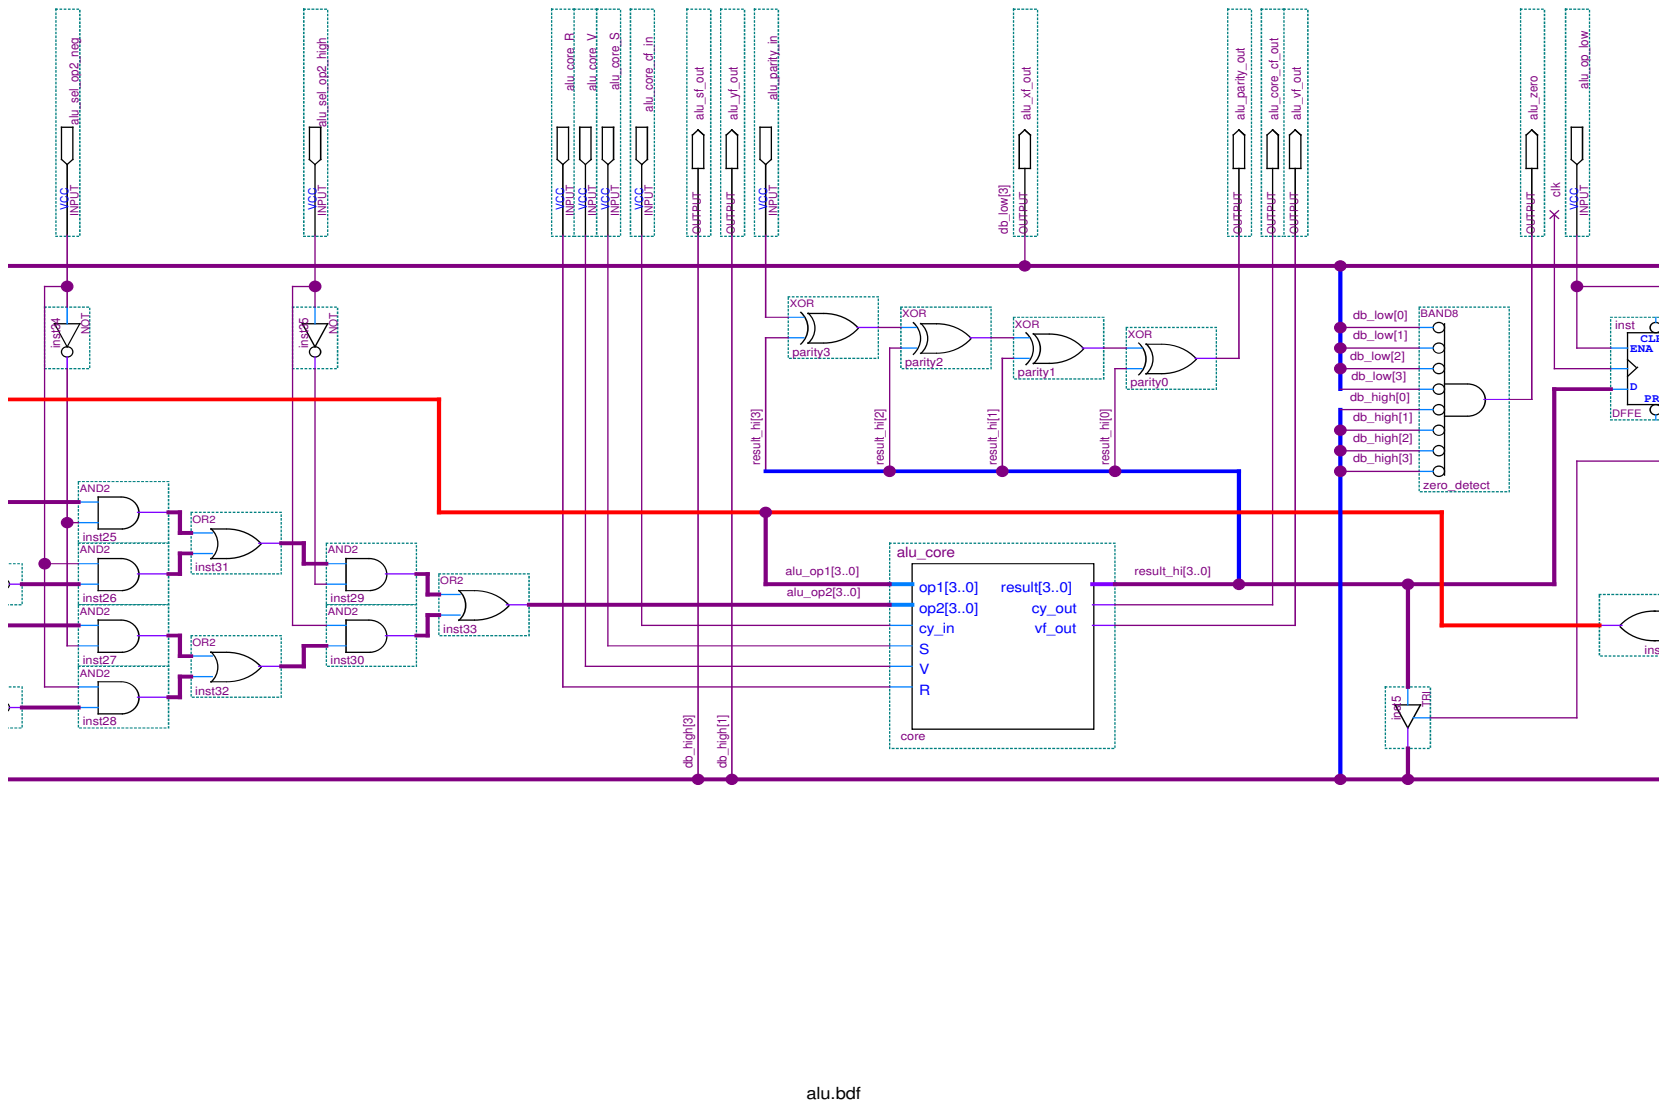
[picture p65: page 2]
db_high[3]; db_high[1]; result_hi[3]; result_hi[2]; result_hi[1]; result_hi[0]; db_low[3]; alu_op1[3..0]; result_hi[3..0]; alu_op2[3..0]; db_low[2]; db_low[1]; db_high[0]; db_high[2]; db_low[0]; clk; VCC; alu_core_R INPUT; alu_core_V INPUT; alu_core_S INPUT; alu_parity_in INPUT; alu_core_cf_in INPUT; alu_op_low INPUT; alu_sel_op2_neg INPUT; alu_sel_op2_high INPUT; alu_zero OUTPUT; alu_parity_out OUTPUT; alu_core_cf_out OUTPUT; alu_sf_out OUTPUT; alu_yf_out OUTPUT; alu_xf_out OUTPUT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

# DESIGNER Goran Devic

DATE | May 18, 2014 | REV | 1.4

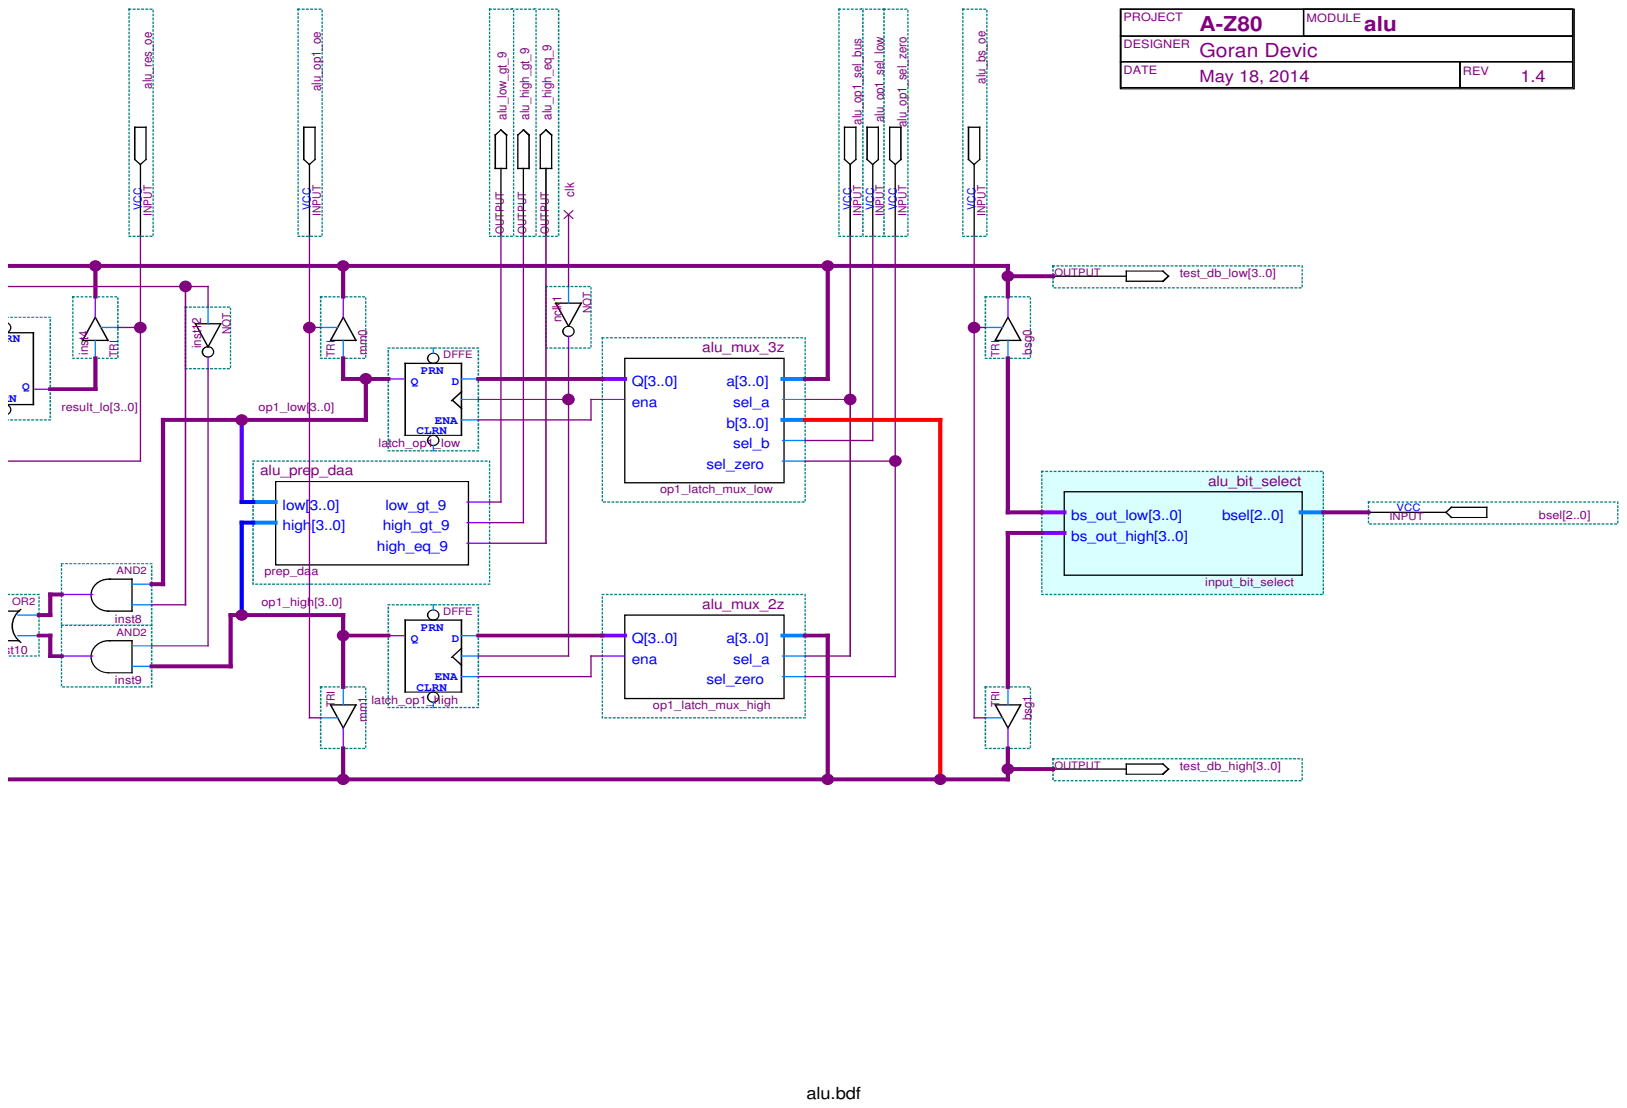
[picture p66: page 3]
clk; op1_low[3..0]; op1_high[3..0]; result_lo[3..0]; VCC; INPUT; bsel[2..0]; alu_bs_oe INPUT; alu_op1_oe INPUT; alu_res_oe INPUT; alu_op1_sel_low INPUT; alu_op1_sel_zero INPUT; alu_op1_sel_bus INPUT; alu_high_eq_9 OUTPUT; alu_high_gt_9 OUTPUT; alu_low_gt_9 OUTPUT; OUTPUT; test_db_low[3..0]; test_db_high[3..0]; AND2; inst8 AND2; inst9; NOT; inst12; TRI; bsg0; bsg1; low[3..0]; high[3..0]; low_gt_9; high_gt_9; high_eq_9; alu_prep_daa; prep_daa; inst4; bs_out_low[3..0]; bs_out_high[3..0]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
