gdevic/A-Z80/docs/pdf/alu_bit_select.pdf

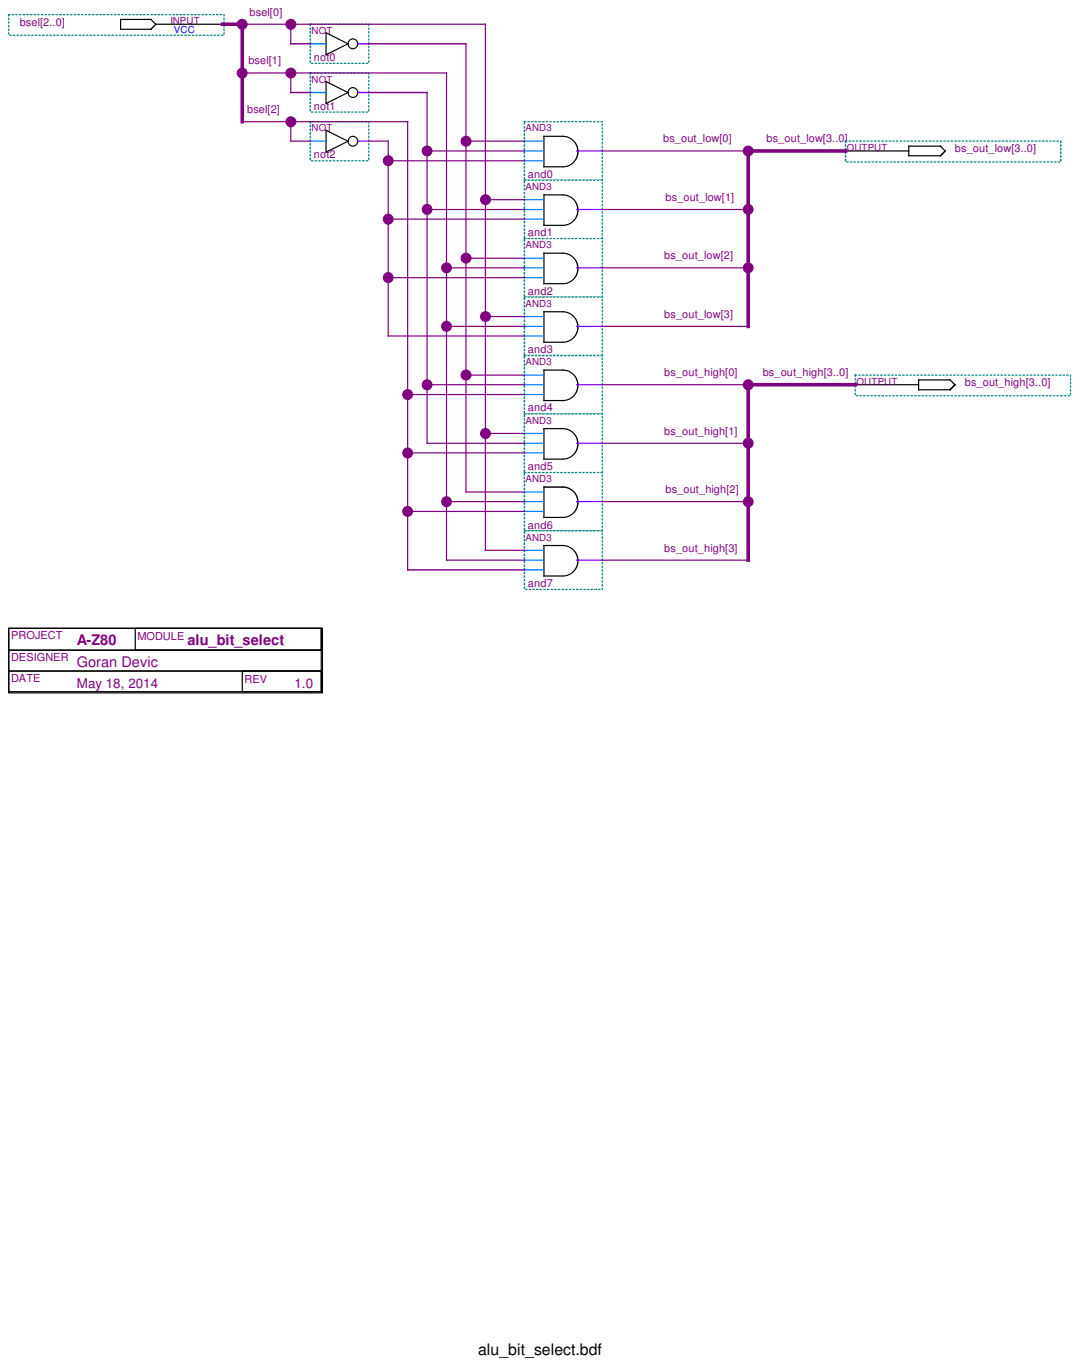
[picture p67: page 1]
alu_bit_select.bdf; bs_out_low[3..0]; bs_out_high[3..0]; bs_out_low[0]; bs_out_low[1]; bs_out_low[2]; bs_out_low[3]; bs_out_high[0]; bs_out_high[1]; bs_out_high[2]; bs_out_high[3]; bsel[0]; bsel[1]; bsel[2]; VCC bsel[2..0]; INPUT; OUTPUT; AND3; and0 AND3; and1 AND3; and2 AND3; and3 AND3; and4 AND3; and5 AND3; and6 AND3; and7; NOT; not0; not1; not2; PROJECT; MODULE alu_bit_select; DATE; May 18, 2014; REV

DESIGNER Goran Devic
