gdevic/A-Z80/docs/pdf/alu_control.pdf

### Bit that is shifted in depends on the opcode: 000 RLC -> old D[7]

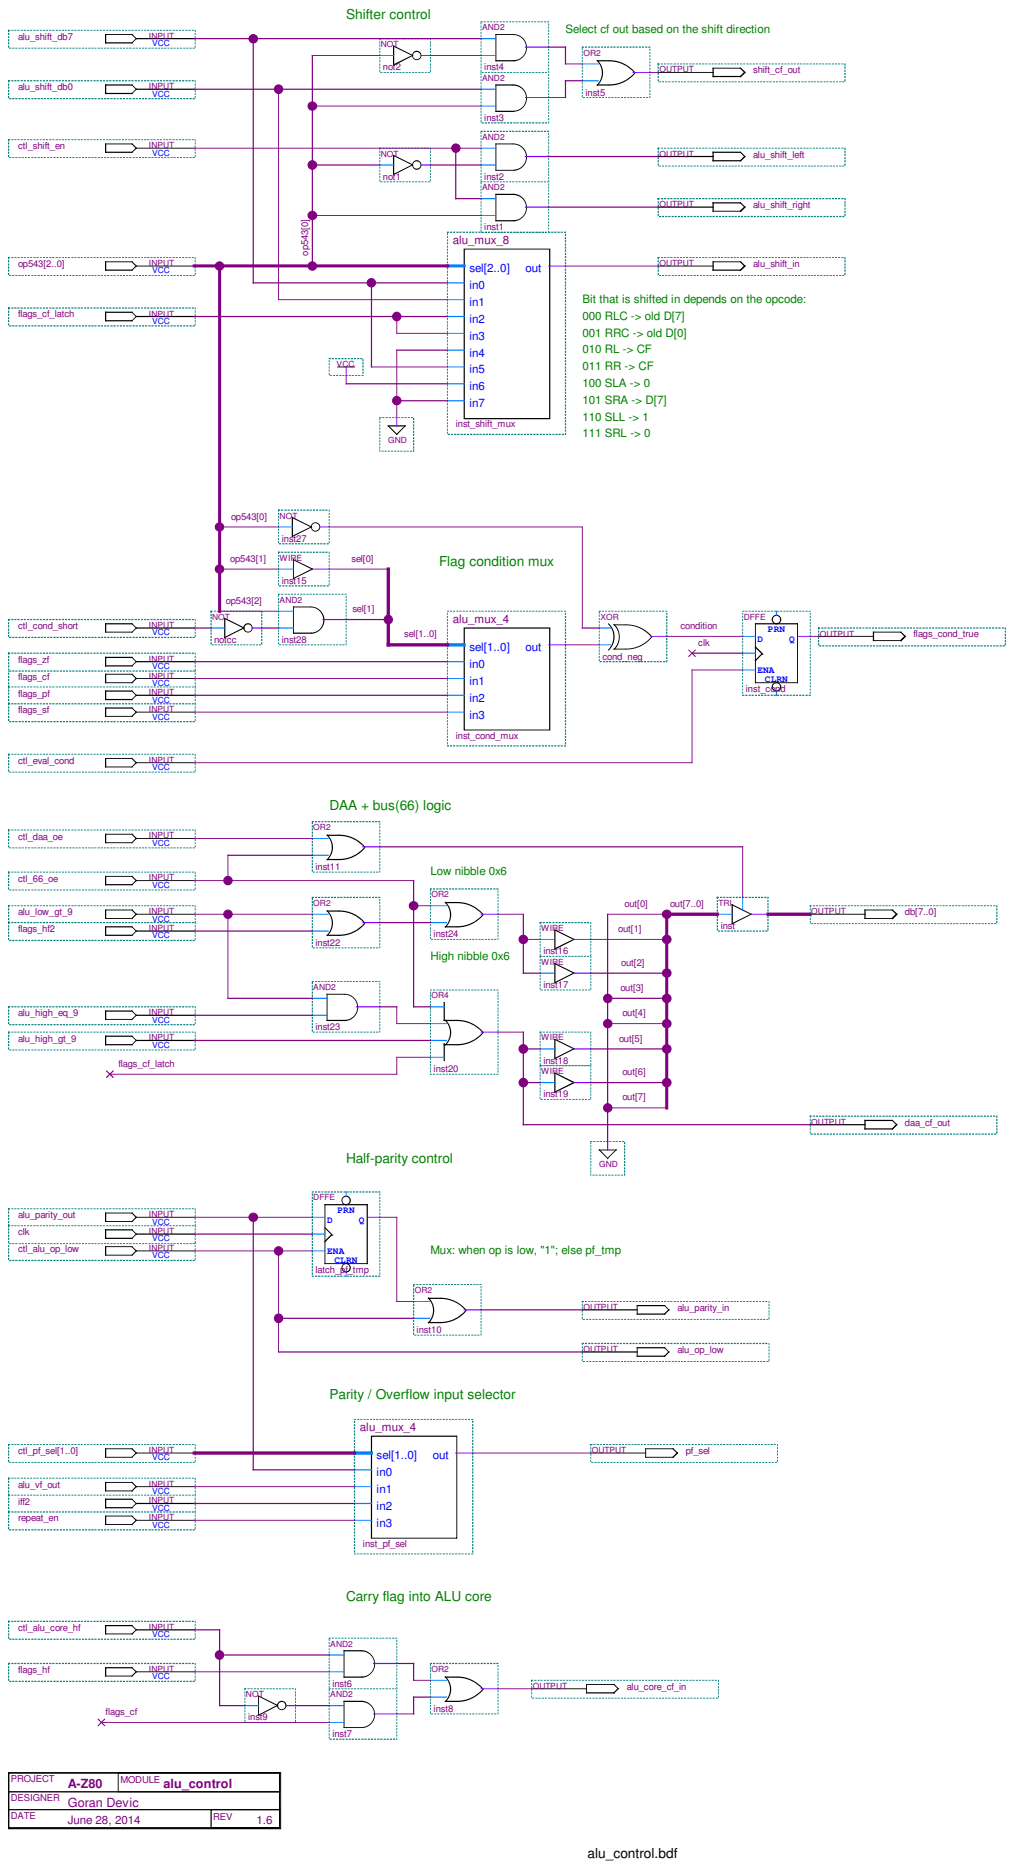
[picture p68: page 1]
alu_control.bdf; out[3]; out[7]; out[0]; out[7..0]; out[4]; out[1]; out[2]; out[5]; out[6]; flags_cf; flags_cf_latch; sel[0]; sel[1]; sel[1..0]; condition; clk; 001 RRC -> old D[0] 010 RL -> CF 011 RR -> CF 100 SLA -> 0 101 SRA -> D[7] 110 SLL -> 1 111 SRL -> 0; Low nibble 0x6; High nibble 0x6; Shifter control; VCC; INPUT; alu_shift_db0; alu_shift_db7; ctl_shift_en; alu_low_gt_9; VCC alu_high_gt_9; alu_high_eq_9; ctl_daa_oe; ctl_alu_op_low; alu_parity_out; flags_zf; VCC flags_pf; flags_sf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

Select cf out based on the shift direction

Flag condition mux

DAA + bus(66) logic

Half-parity control

Mux: when op is low, "1"; else pf_tmp

Parity / Overflow input selector

Carry flag into ALU core

DESIGNER Goran Devic
