gdevic/A-Z80/docs/pdf/alu_core.pdf

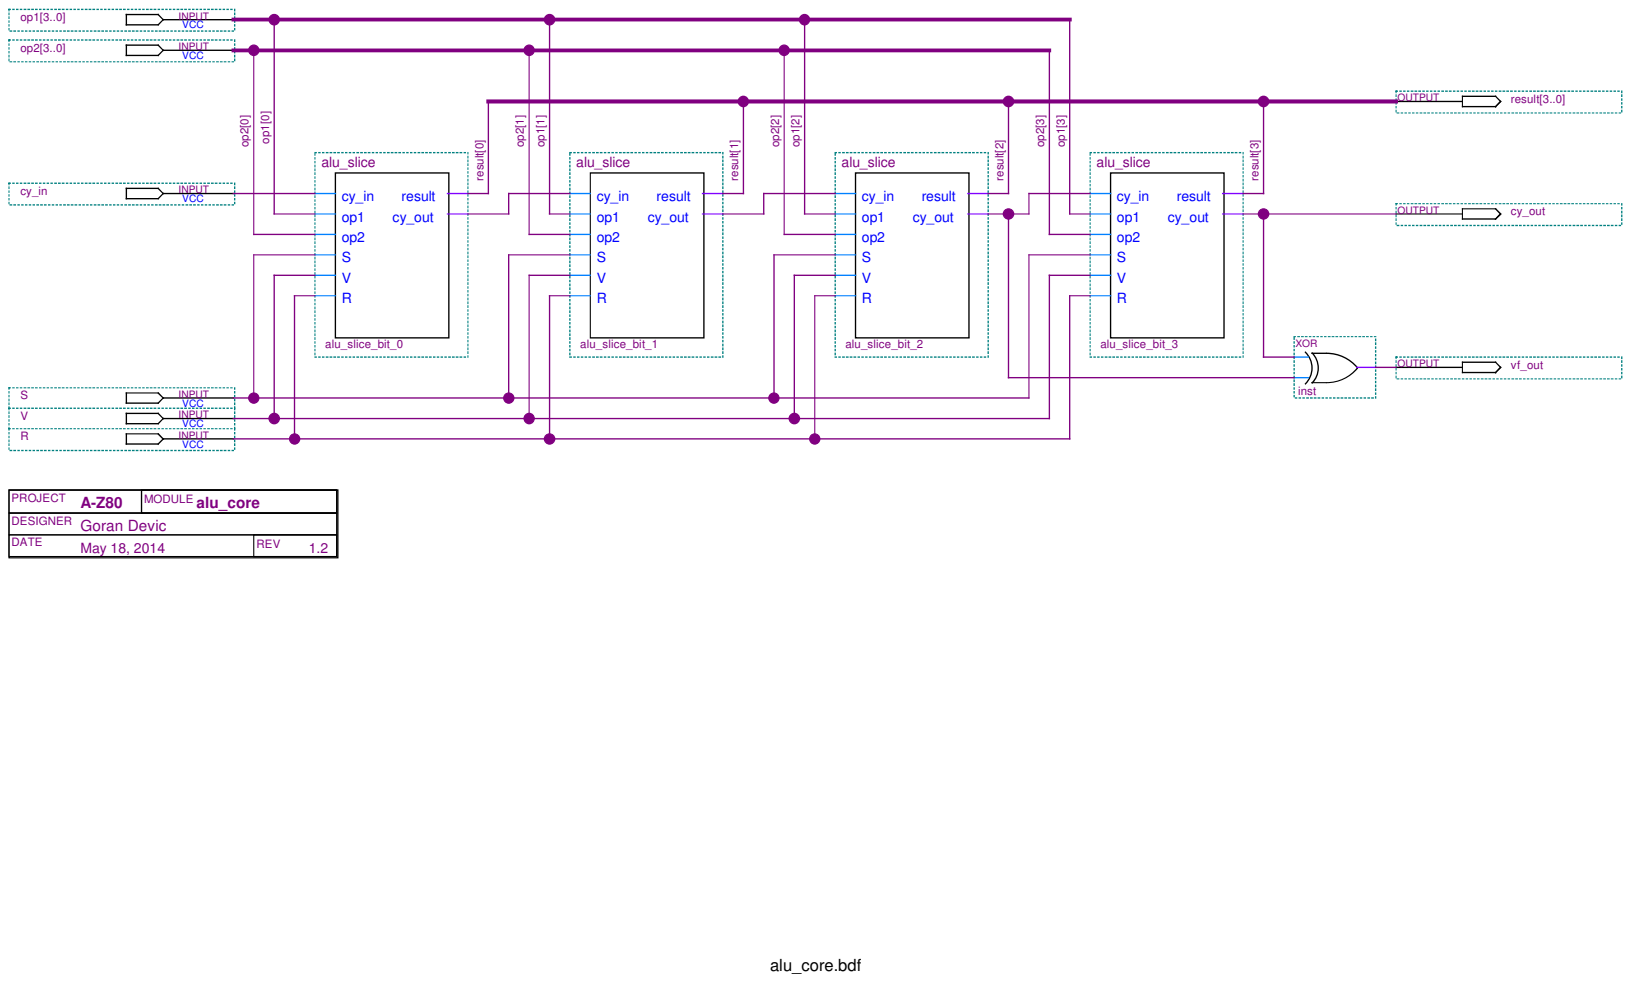
[picture p69: page 1]
alu_core.bdf; result[0]; result[1]; result[2]; result[3]; VCC cy_in; INPUT; VCC op1[3..0]; VCC op2[3..0]; VCC S; VCC; OUTPUT; cy_out; result[3..0]; vf_out; result cy_out; alu_slice; alu_slice_bit_3; alu_slice_bit_2; alu_slice_bit_1; alu_slice_bit_0; XOR; inst; PROJECT; MODULE alu_core; DATE; May 18, 2014; REV

DESIGNER Goran Devic
