gdevic/A-Z80/docs/pdf/alu_mux_2.pdf

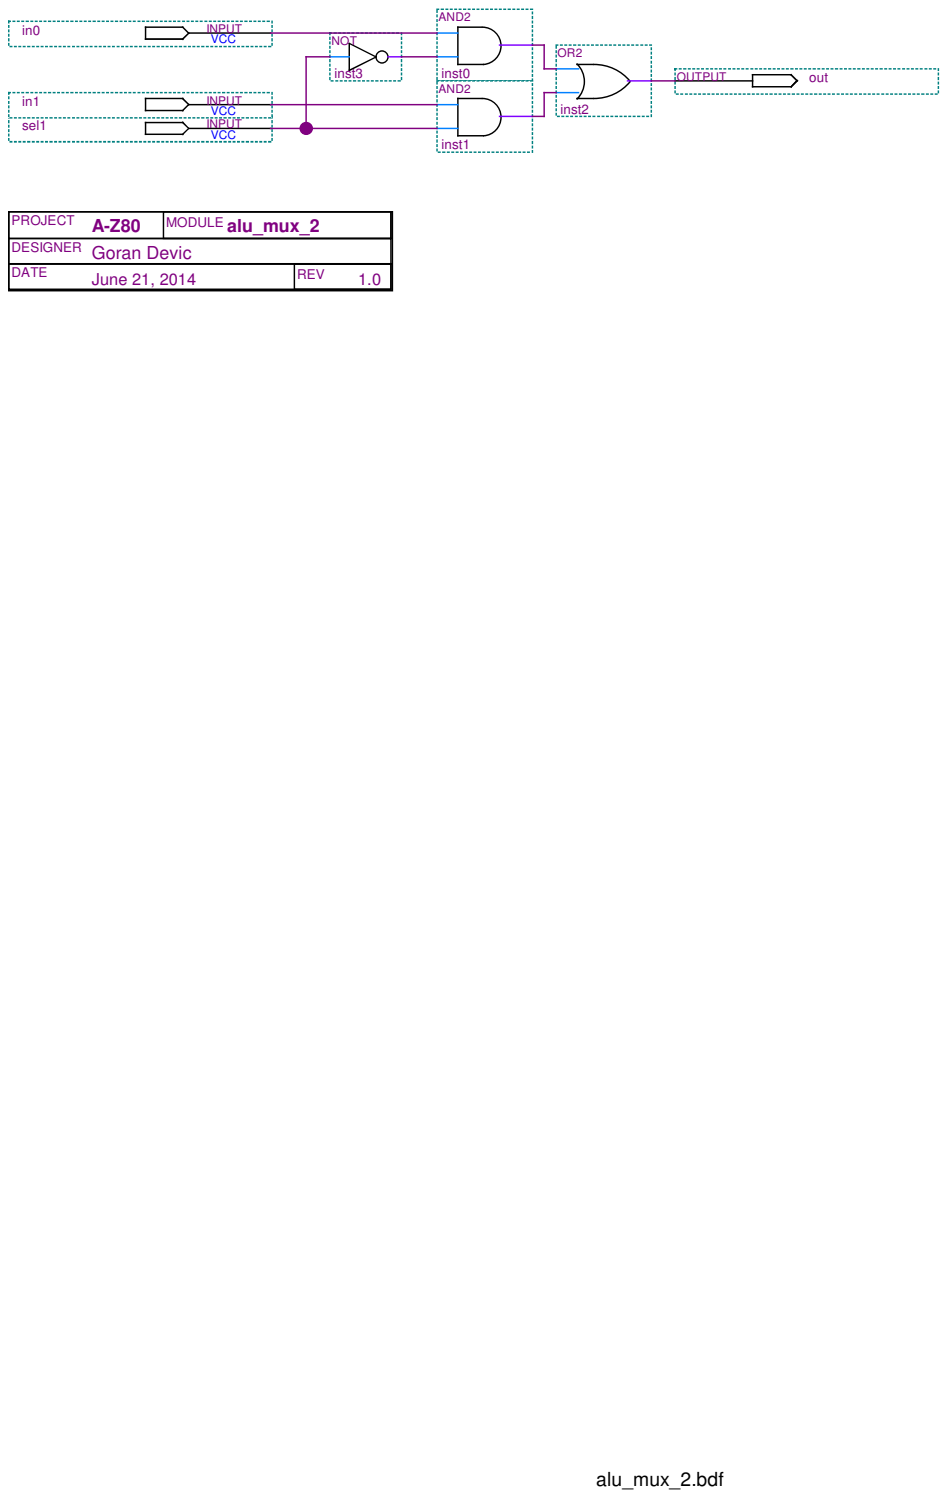
[picture p71: page 1]
alu_mux_2.bdf; VCC; sel1; INPUT; VCC in0; OUTPUT; out; NOT; inst3; AND2; inst0 AND2; inst1; inst2; DATE; June 21, 2014; MODULE alu_mux_2 PROJECT; REV

DESIGNER Goran Devic
