gdevic/A-Z80/docs/pdf/alu_mux_2z.pdf

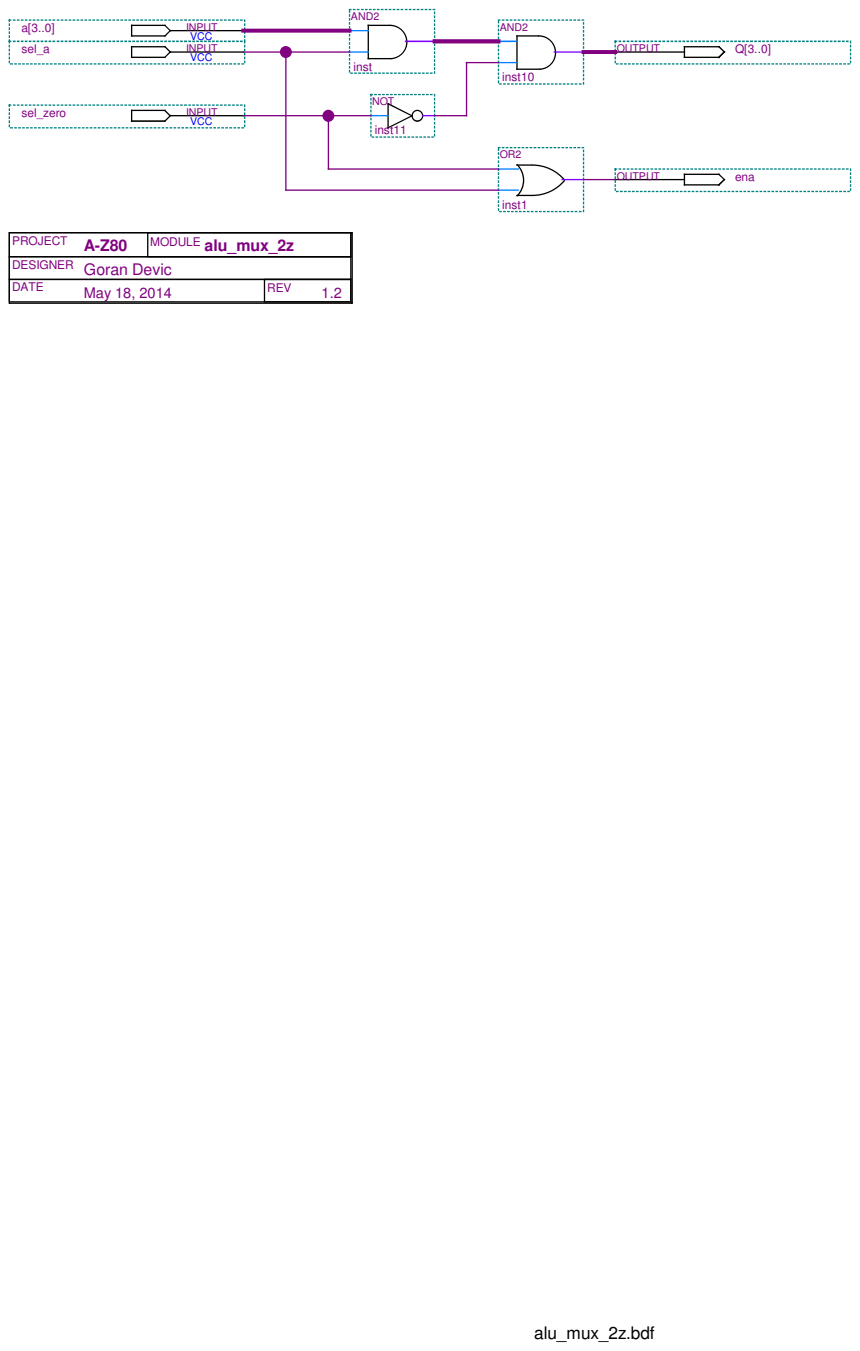
[picture p72: page 1]
alu_mux_2z.bdf; VCC; INPUT; sel_a; sel_zero; OUTPUT; ena; AND2; inst; inst10; NOT; inst11; inst1; PROJECT; MODULE alu_mux_2z; DATE; May 18, 2014; REV

DESIGNER Goran Devic
