gdevic/A-Z80/docs/pdf/alu_mux_3z.pdf

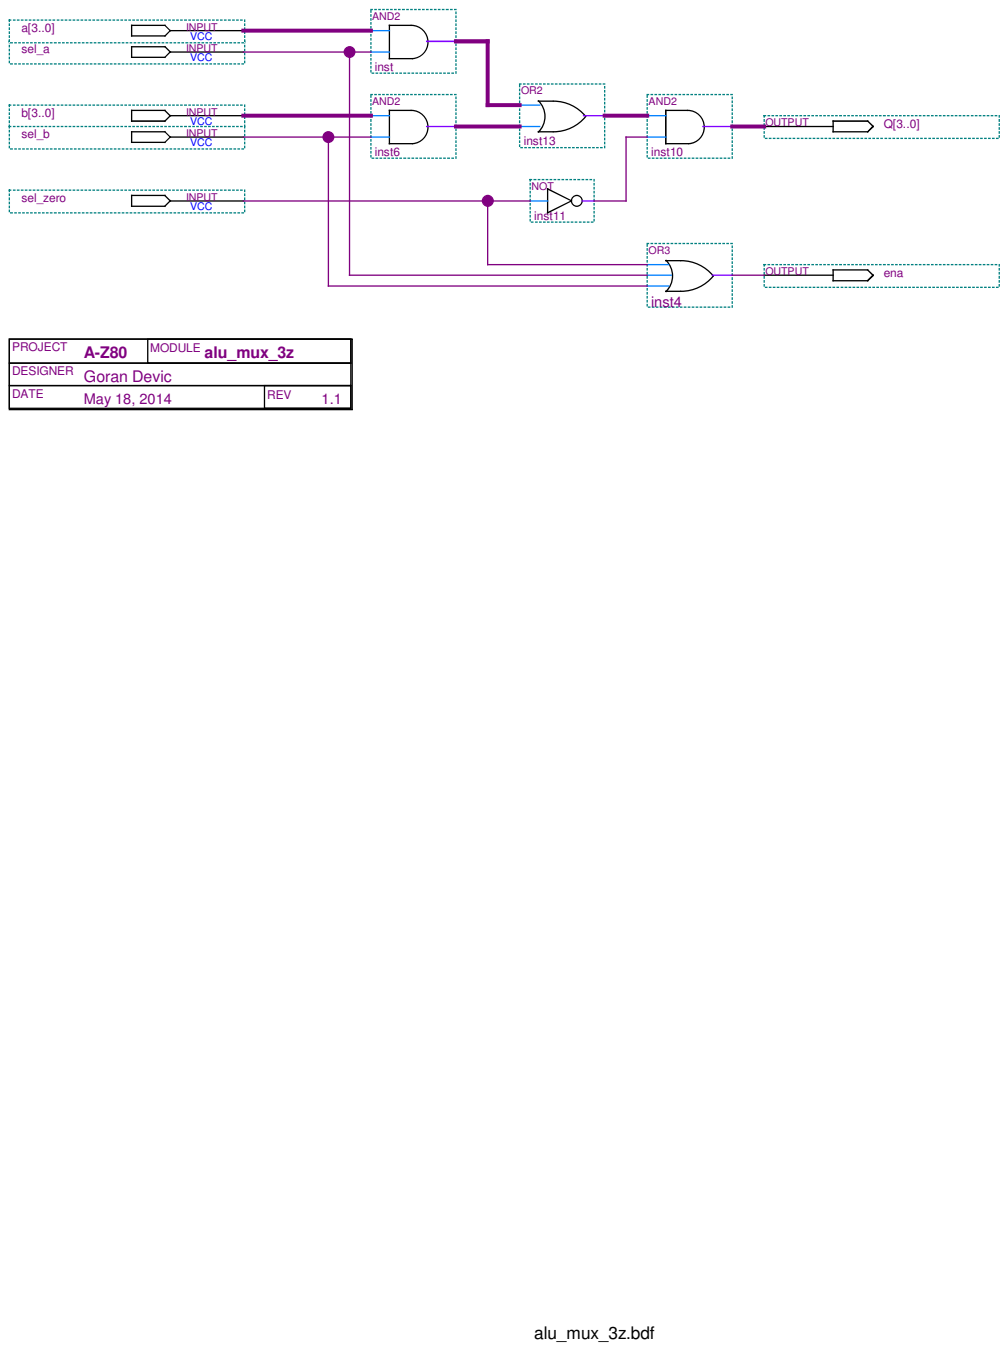
[picture p73: page 1]
alu_mux_3z.bdf; VCC; sel_zero; INPUT; sel_a; sel_b; OUTPUT; ena; AND2; inst; inst6; inst10; inst13; NOT; inst11; inst4; PROJECT; MODULE alu_mux_3z; DATE; May 18, 2014; REV

DESIGNER Goran Devic
