gdevic/A-Z80/docs/pdf/alu_mux_4.pdf

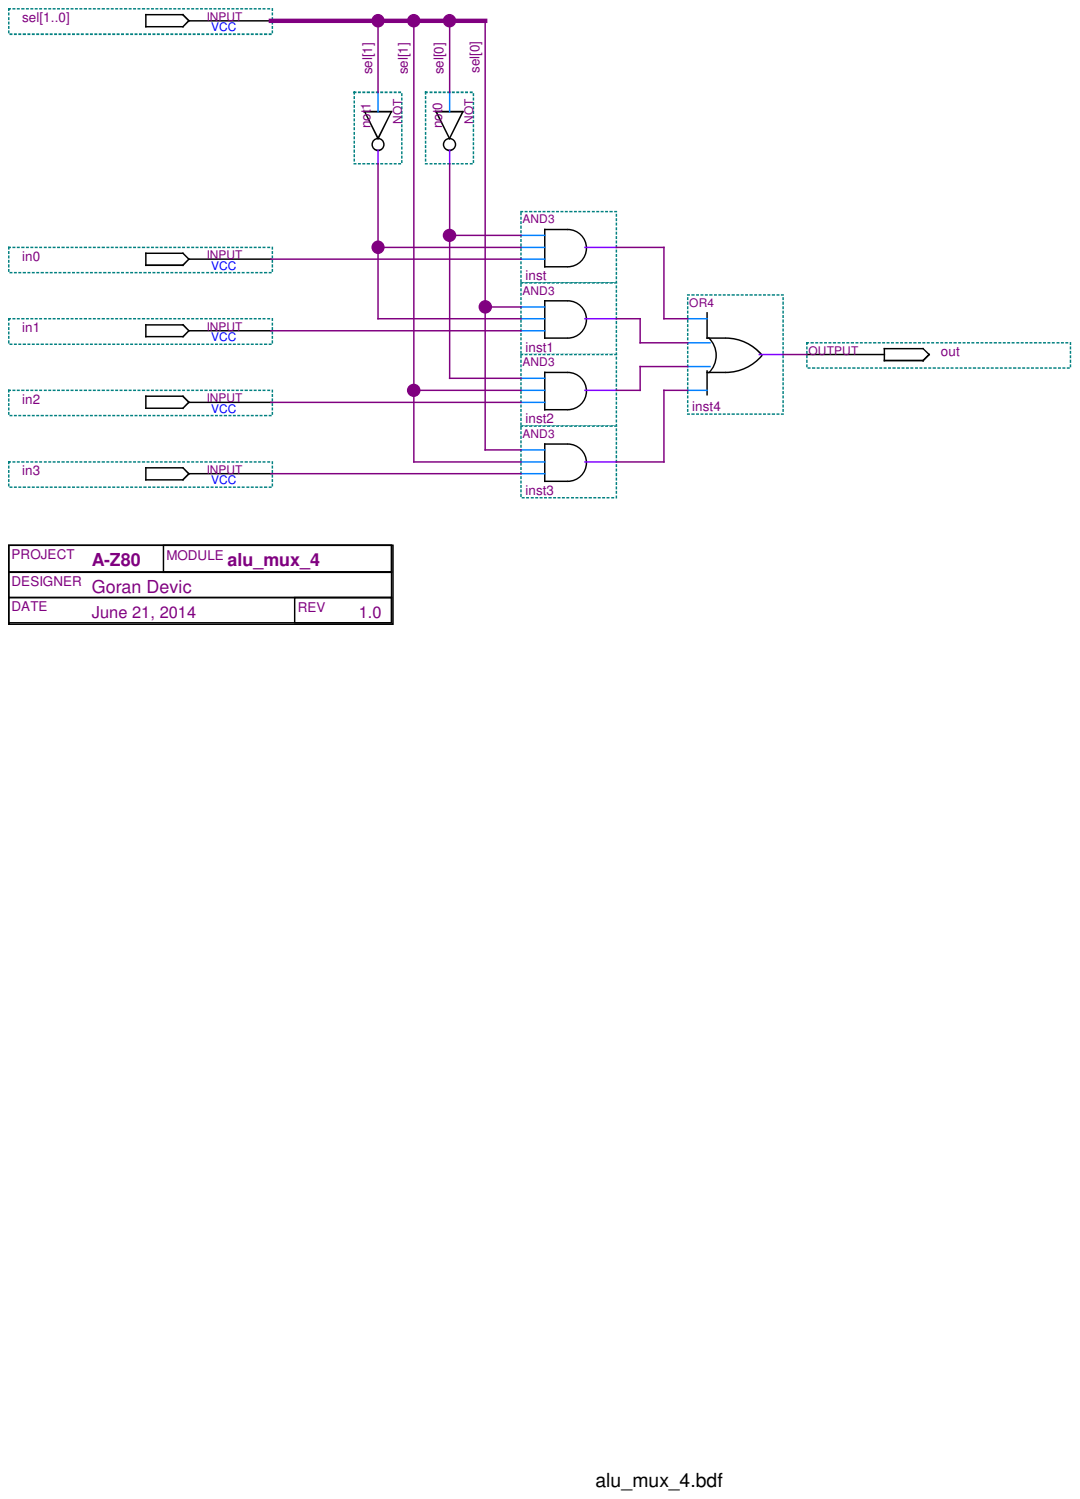
[picture p74: page 1]
alu_mux_4.bdf; sel[1]; sel[0]; VCC in0; INPUT; VCC in1; VCC; VCC in3; sel[1..0]; OUTPUT; out; NOT; not1; not0; AND3; inst AND3; inst1 AND3; inst2 AND3; inst3; inst4; DATE; June 21, 2014; MODULE alu_mux_4 PROJECT; REV

DESIGNER Goran Devic
