gdevic/A-Z80/docs/pdf/alu_mux_8.pdf

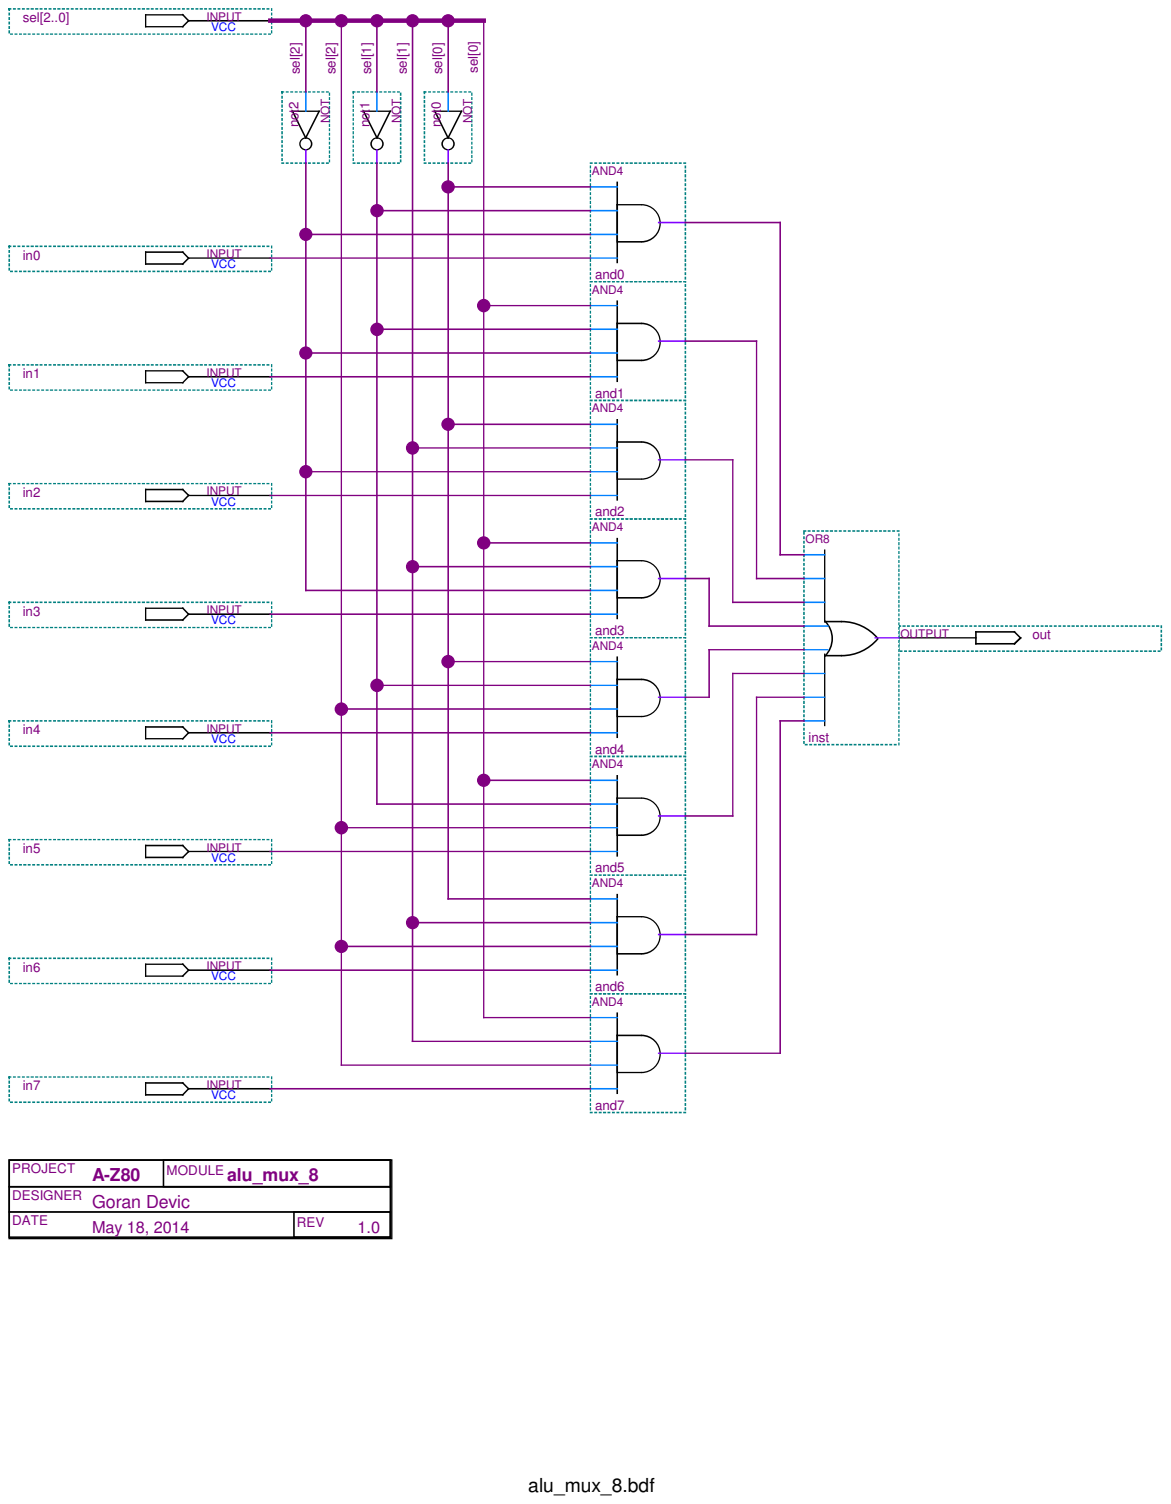
[picture p75: page 1]
alu_mux_8.bdf; sel[2]; sel[1]; sel[0]; VCC sel[2..0]; INPUT; VCC; VCC in1; VCC in6; OUTPUT; out; AND4; and0 AND4; and1 AND4; and2 AND4; and3 AND4; and4 AND4; and5 AND4; and6 AND4; and7; NOT; not2; not1; not0; inst; DATE; May 18, 2014; MODULE alu_mux_8 PROJECT; REV

DESIGNER Goran Devic
