gdevic/A-Z80/docs/pdf/alu_prep_daa.pdf

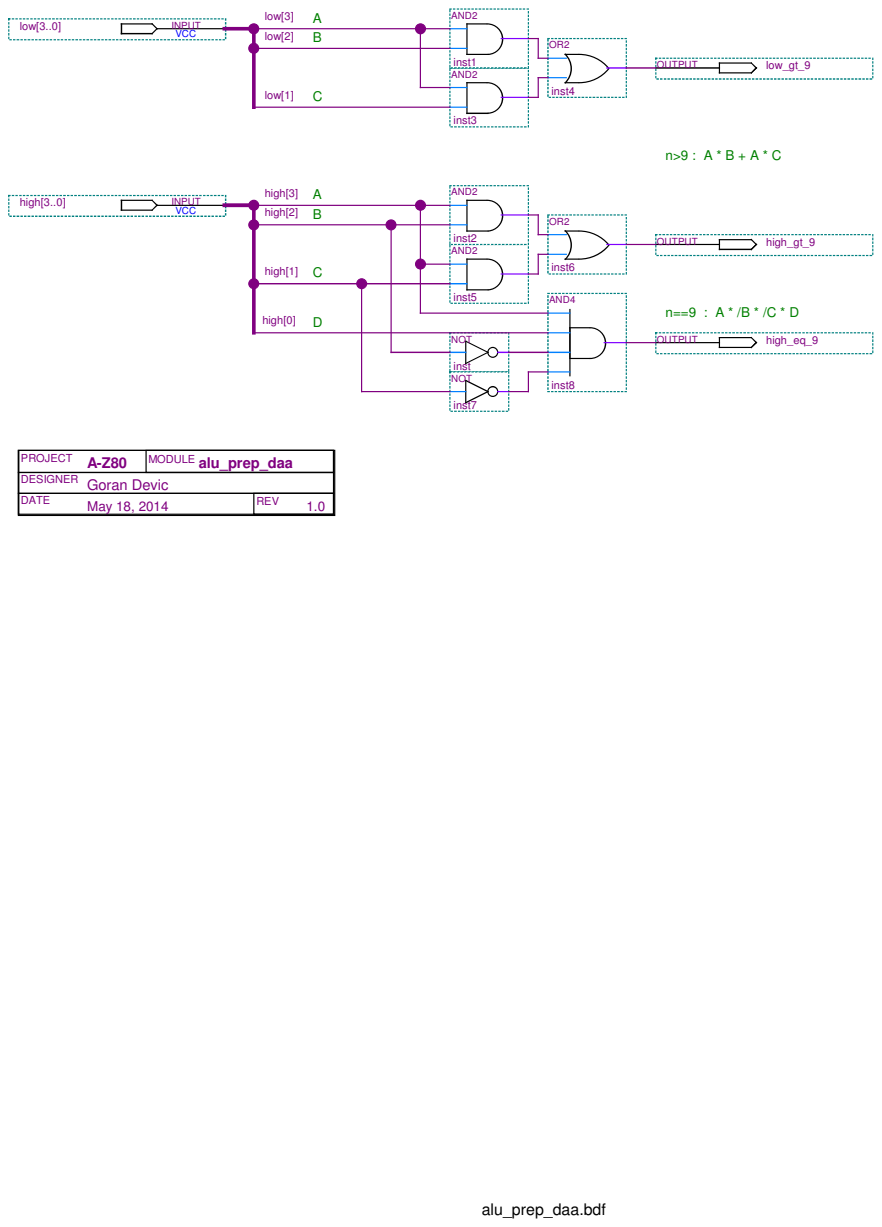
[picture p76: page 1]
alu_prep_daa.bdf; low[2]; low[1]; low[3]; high[3]; VCC low[3..0]; INPUT; VCC; high[3..0]; OUTPUT; low_gt_9; high_eq_9; high_gt_9; AND2; inst3; inst4; inst1; inst5; inst6; inst2; inst NOT; inst7; AND4; inst8; DATE; May 18, 2014; MODULE alu_prep_daa PROJECT; REV

high[2] B

high[1] C

high[0] D

NOT

DESIGNER Goran Devic
