gdevic/A-Z80/docs/pdf/alu_slice.pdf

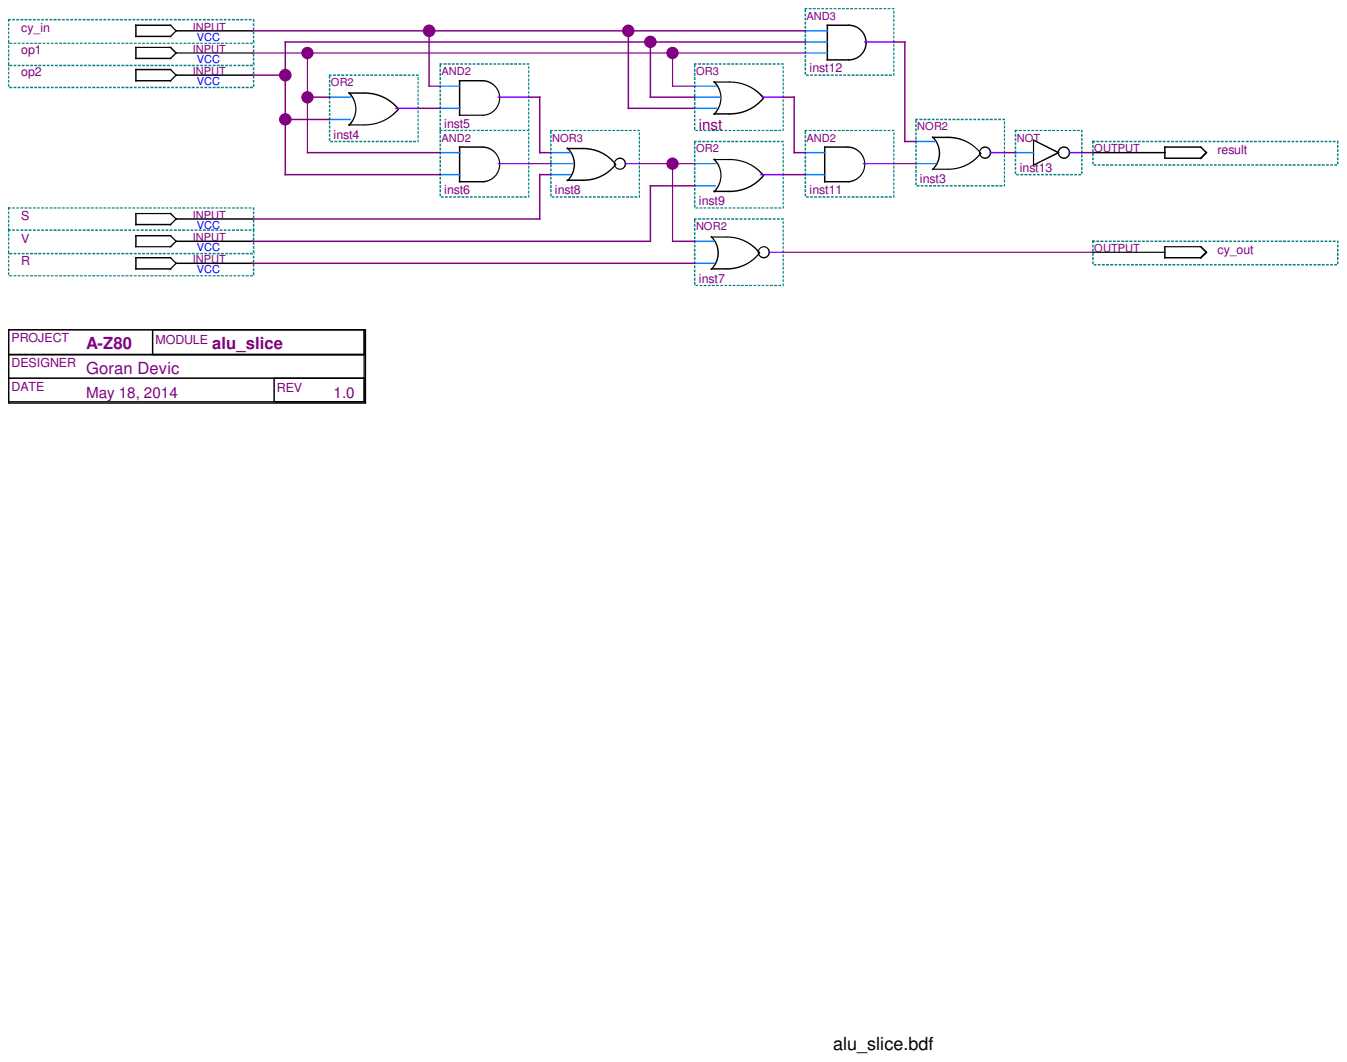
[picture p79: page 1]
alu_slice.bdf; VCC op2; INPUT; VCC op1; VCC cy_in; VCC; OUTPUT; cy_out; result; NOR2; inst3; inst4; AND2; inst5 AND2; inst6; inst7; NOR3; inst8; inst9; inst11; AND3; inst12; NOT; inst13; inst; PROJECT; MODULE alu_slice; DATE; May 18, 2014; REV

DESIGNER Goran Devic
