gdevic/A-Z80/docs/pdf/bus_control.pdf

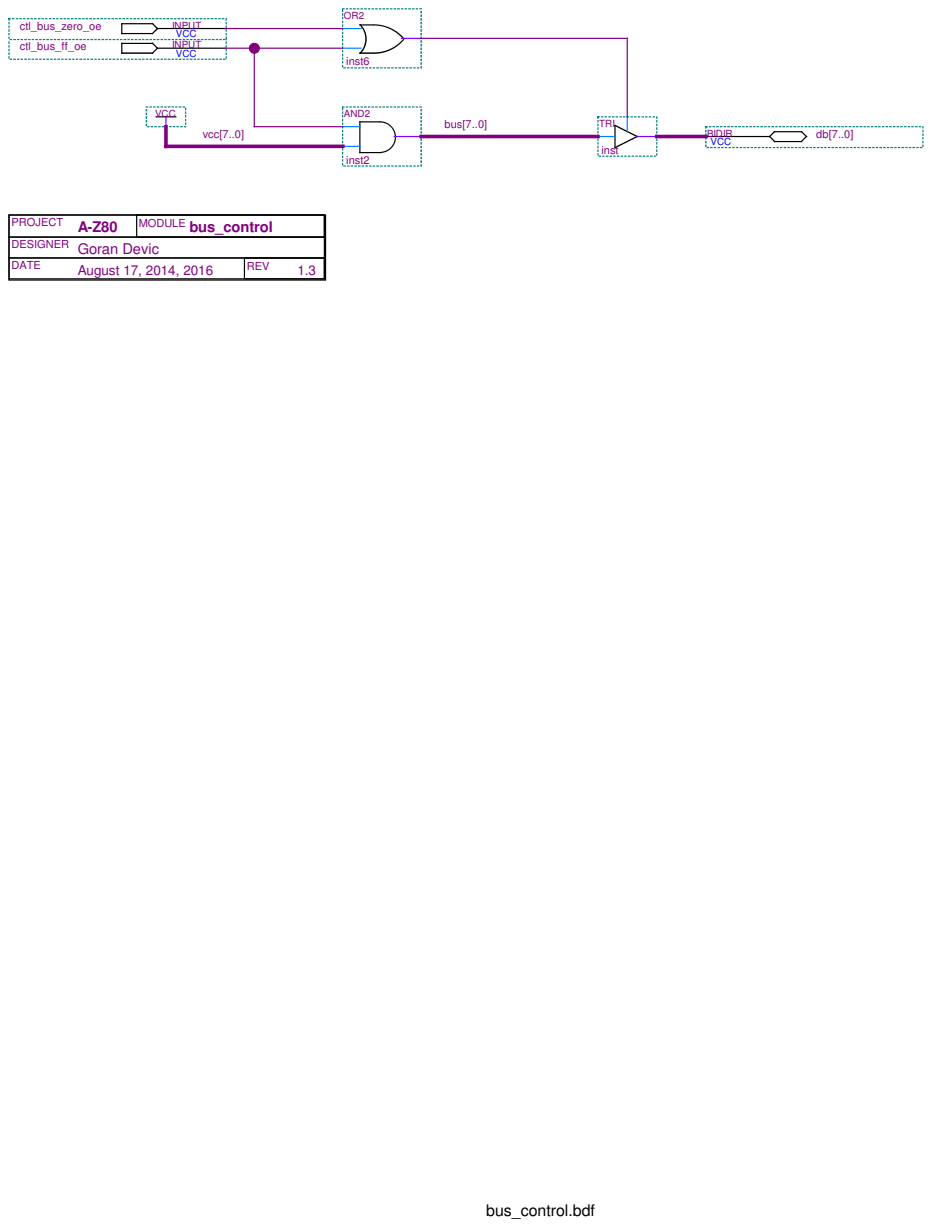
[picture p80: page 1]
bus_control.bdf; bus[7..0]; vcc[7..0]; VCC ctl_bus_ff_oe; INPUT; VCC; ctl_bus_zero_oe; BIDIR; TRI; inst; AND2; inst2; inst6; DATE; August 17, 2014, 2016; MODULE bus_control PROJECT; REV

DESIGNER Goran Devic
