gdevic/A-Z80/docs/pdf/data_switch.pdf

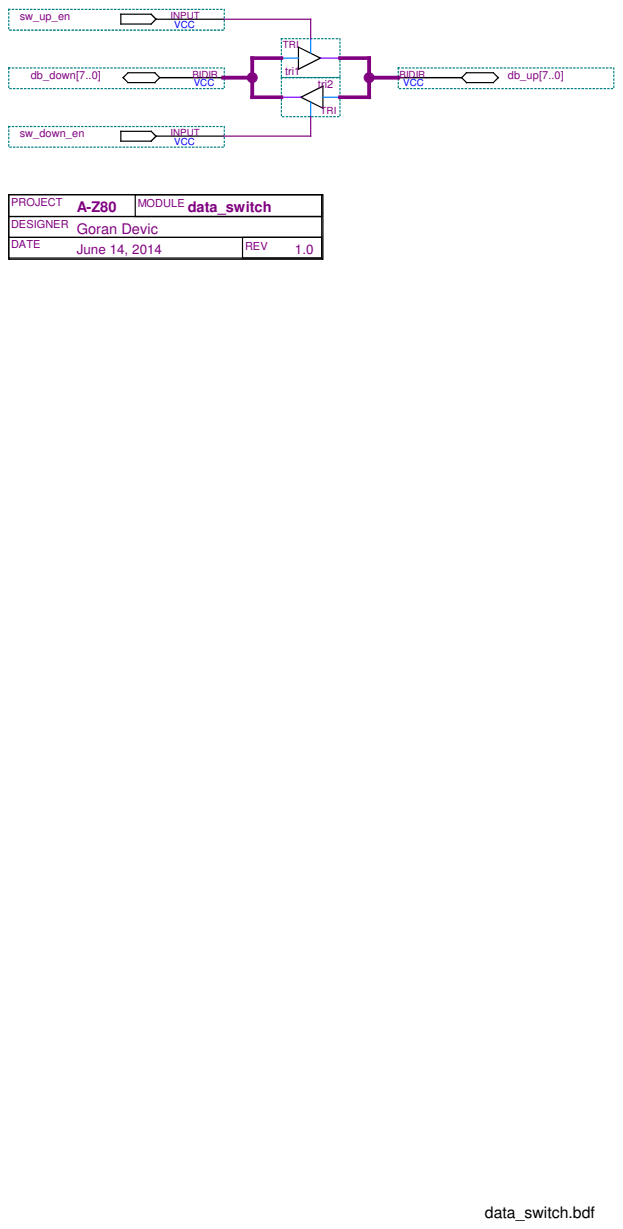
[picture p82: page 1]
data_switch.bdf; VCC; INPUT; VCC sw_down_en; db_down[7..0]; BIDIR; TRI; tri1; tri2; DATE; June 14, 2014; MODULE data_switch PROJECT; REV

DESIGNER Goran Devic
