gdevic/A-Z80/docs/pdf/data_switch_mask.pdf

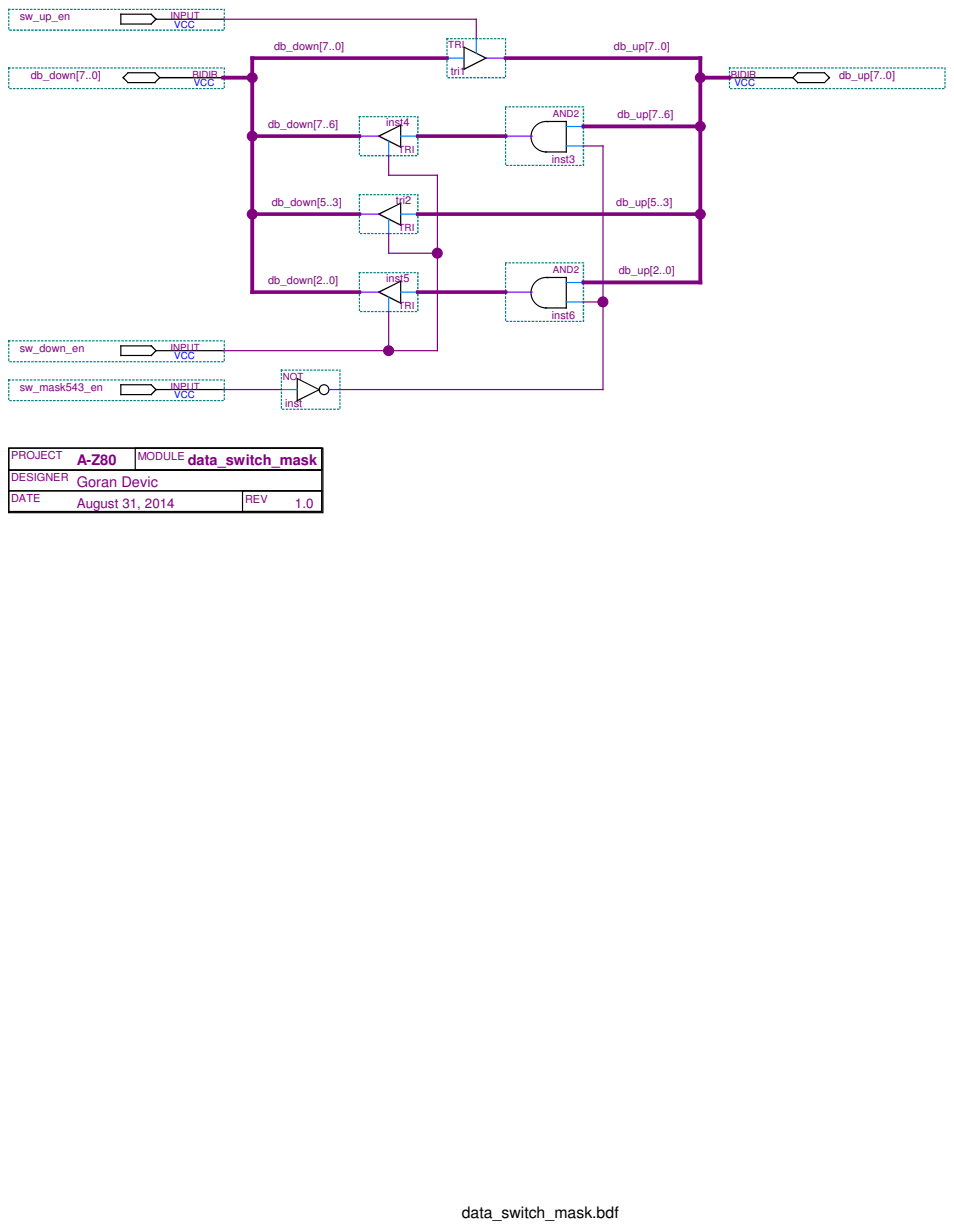
[picture p83: page 1]
data_switch_mask.bdf; db_down[7..6]; db_down[5..3]; db_down[2..0]; db_down[7..0]; VCC; INPUT; VCC sw_down_en; VCC sw_mask543_en; BIDIR; TRI; tri1; tri2; NOT; inst; AND2; inst3; inst4; inst5; inst6; PROJECT; MODULE data_switch_mask; DATE; August 31, 2014; REV

DESIGNER Goran Devic
