gdevic/A-Z80/docs/pdf/inc_dec_2bit.pdf

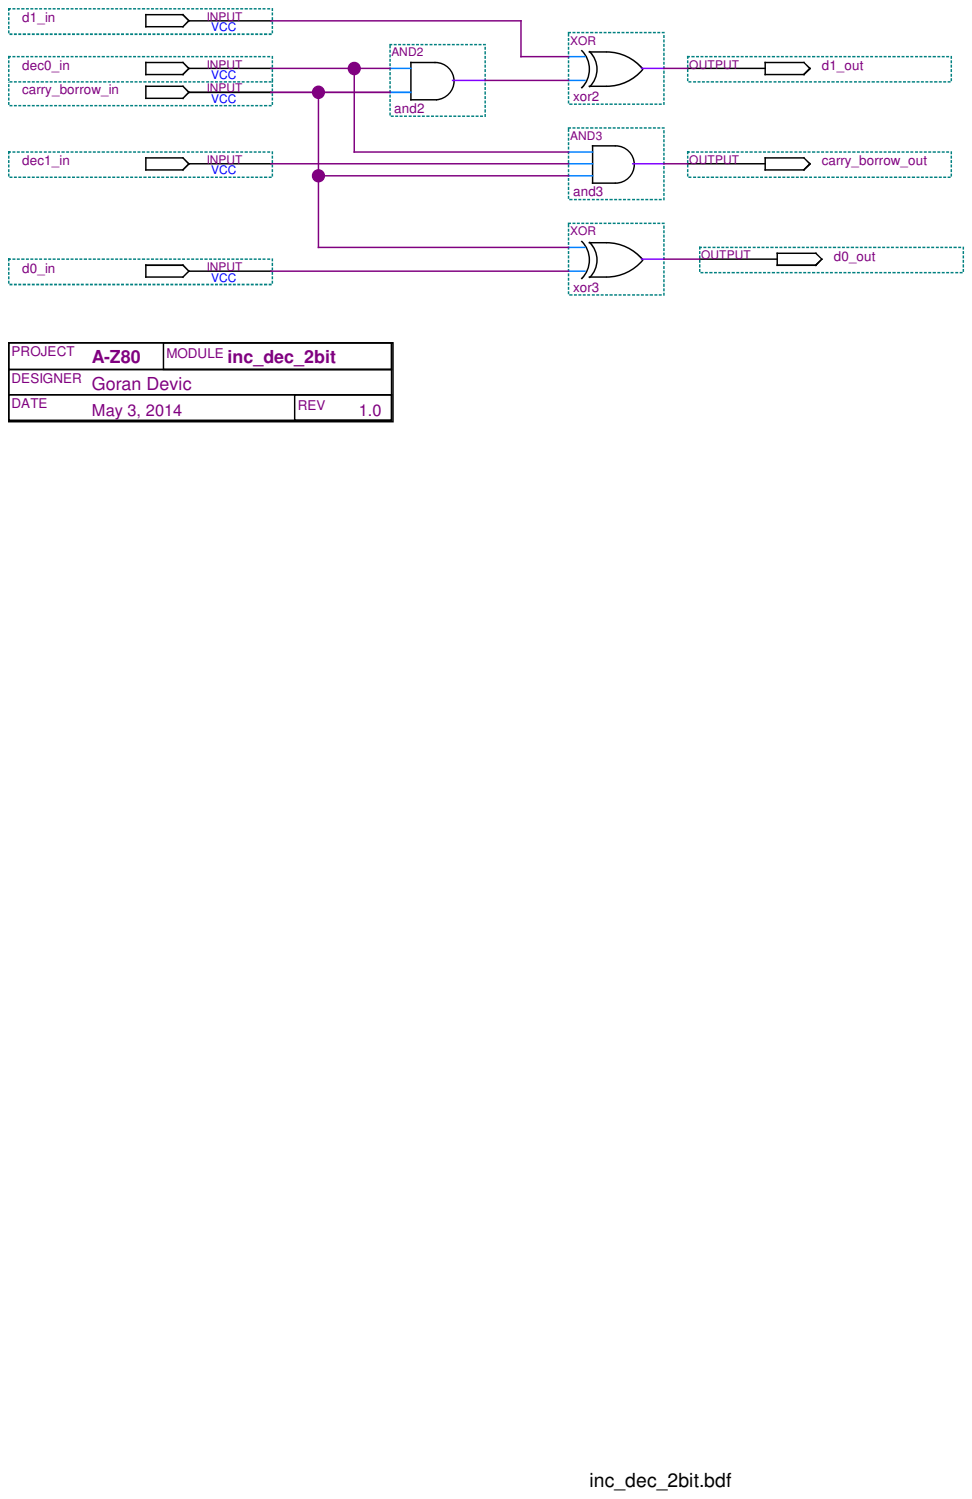
[picture p87: page 1]
inc_dec_2bit.bdf; VCC; carry_borrow_in; INPUT; VCC dec1_in; VCC dec0_in; OUTPUT; carry_borrow_out; d1_out; d0_out; XOR; xor2; xor3; AND3; and3; AND2; and2; DATE; May 3, 2014; MODULE inc_dec_2bit PROJECT; REV

DESIGNER Goran Devic
