gdevic/A-Z80/docs/pdf/ir.pdf

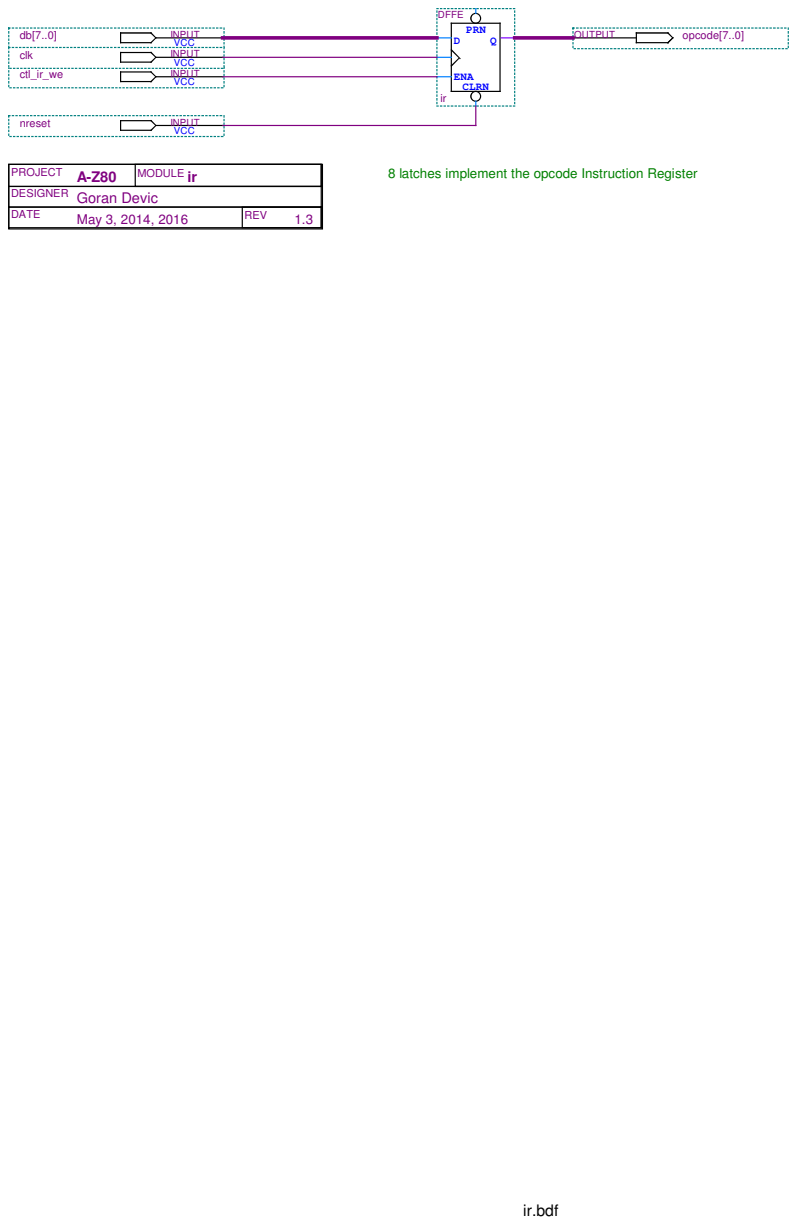
[picture p88: page 1]
ir.bdf; VCC ctl_ir_we; INPUT; VCC; VCC clk; VCC nreset; OUTPUT; opcode[7..0] PRN; CLRN; ENA; DFFE; DATE; May 3, 2014, 2016; MODULE ir PROJECT; REV

DESIGNER Goran Devic

8 latches implement the opcode Instruction Register
