gdevic/A-Z80/docs/pdf/reg_latch.pdf

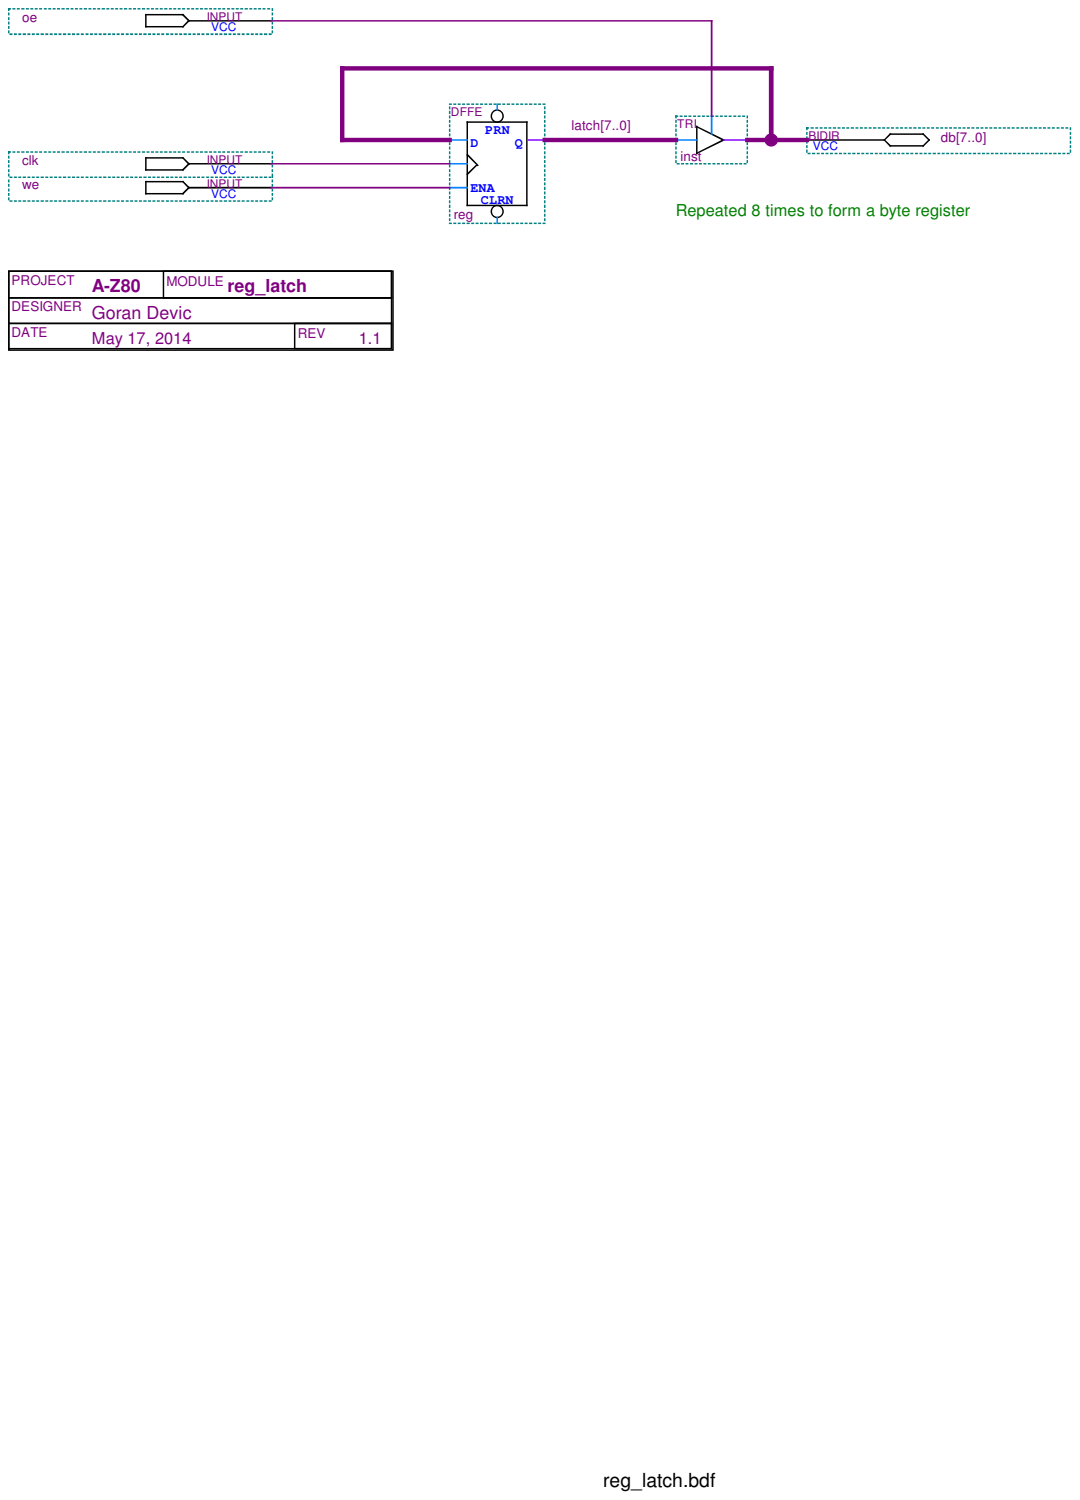
[picture p93: page 1]
reg_latch.bdf; latch[7..0]; VCC; INPUT; VCC clk; BIDIR; TRI; inst; PRN; CLRN; ENA; DFFE; reg; PROJECT; MODULE reg_latch; DATE; May 17, 2014; REV

Repeated 8 times to form a byte register

DESIGNER Goran Devic
