gdevic/A-Z80/docs/pdf/resets.pdf

Special reset, USPTO 4,486,827 by Shima et al.

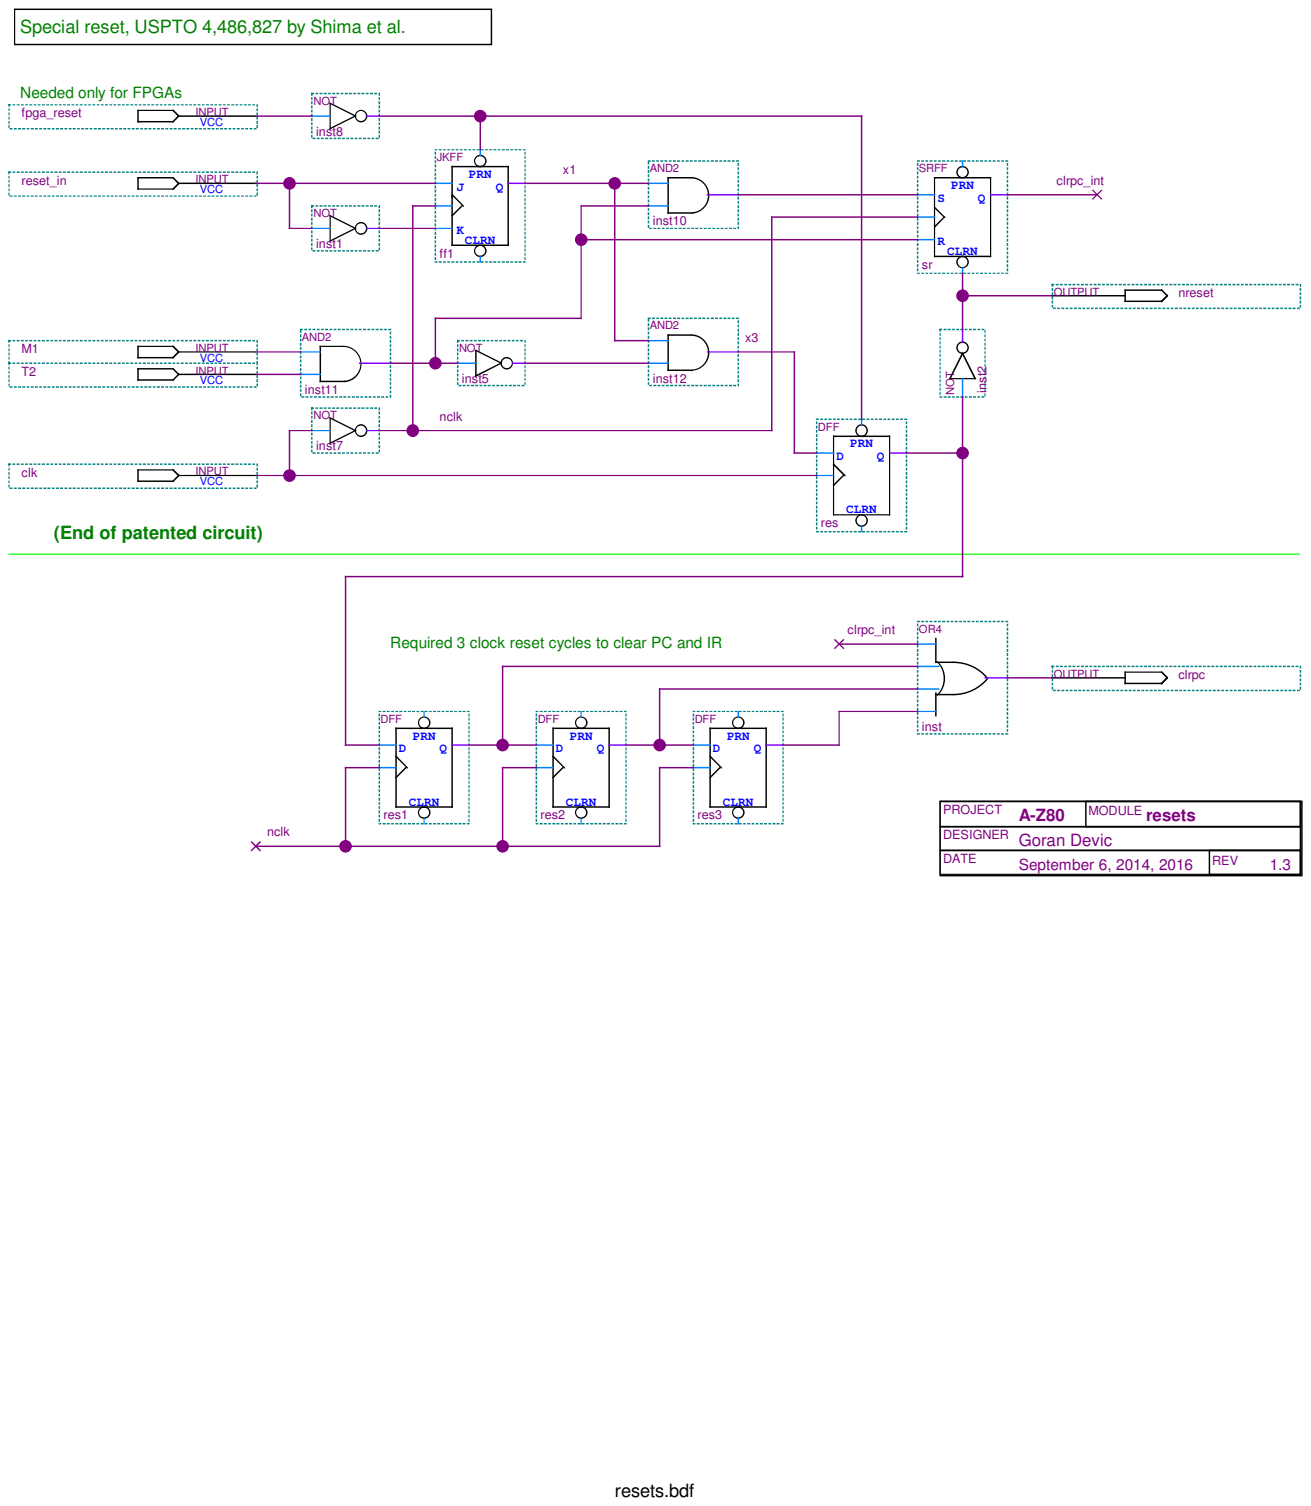
[picture p94: page 1]
resets.bdf; nclk; clrpc_int; VCC reset_in; INPUT; VCC; clk; fpga_reset; OUTPUT; clrpc; nreset; NOT; inst1; AND2; inst10; inst12; inst5; inst11; PRN; CLRN; SRFF; inst7; JKFF; inst8; DFF; res; inst2; res1; res2; res3; inst; DATE; September 6, 2014, 2016; MODULE resets PROJECT; REV

Needed only for FPGAs

(End of patented circuit)

Required 3 clock reset cycles to clear PC and IR

DESIGNER Goran Devic
