gdevic/A-Z80/docs/pdf/sequencer.pdf

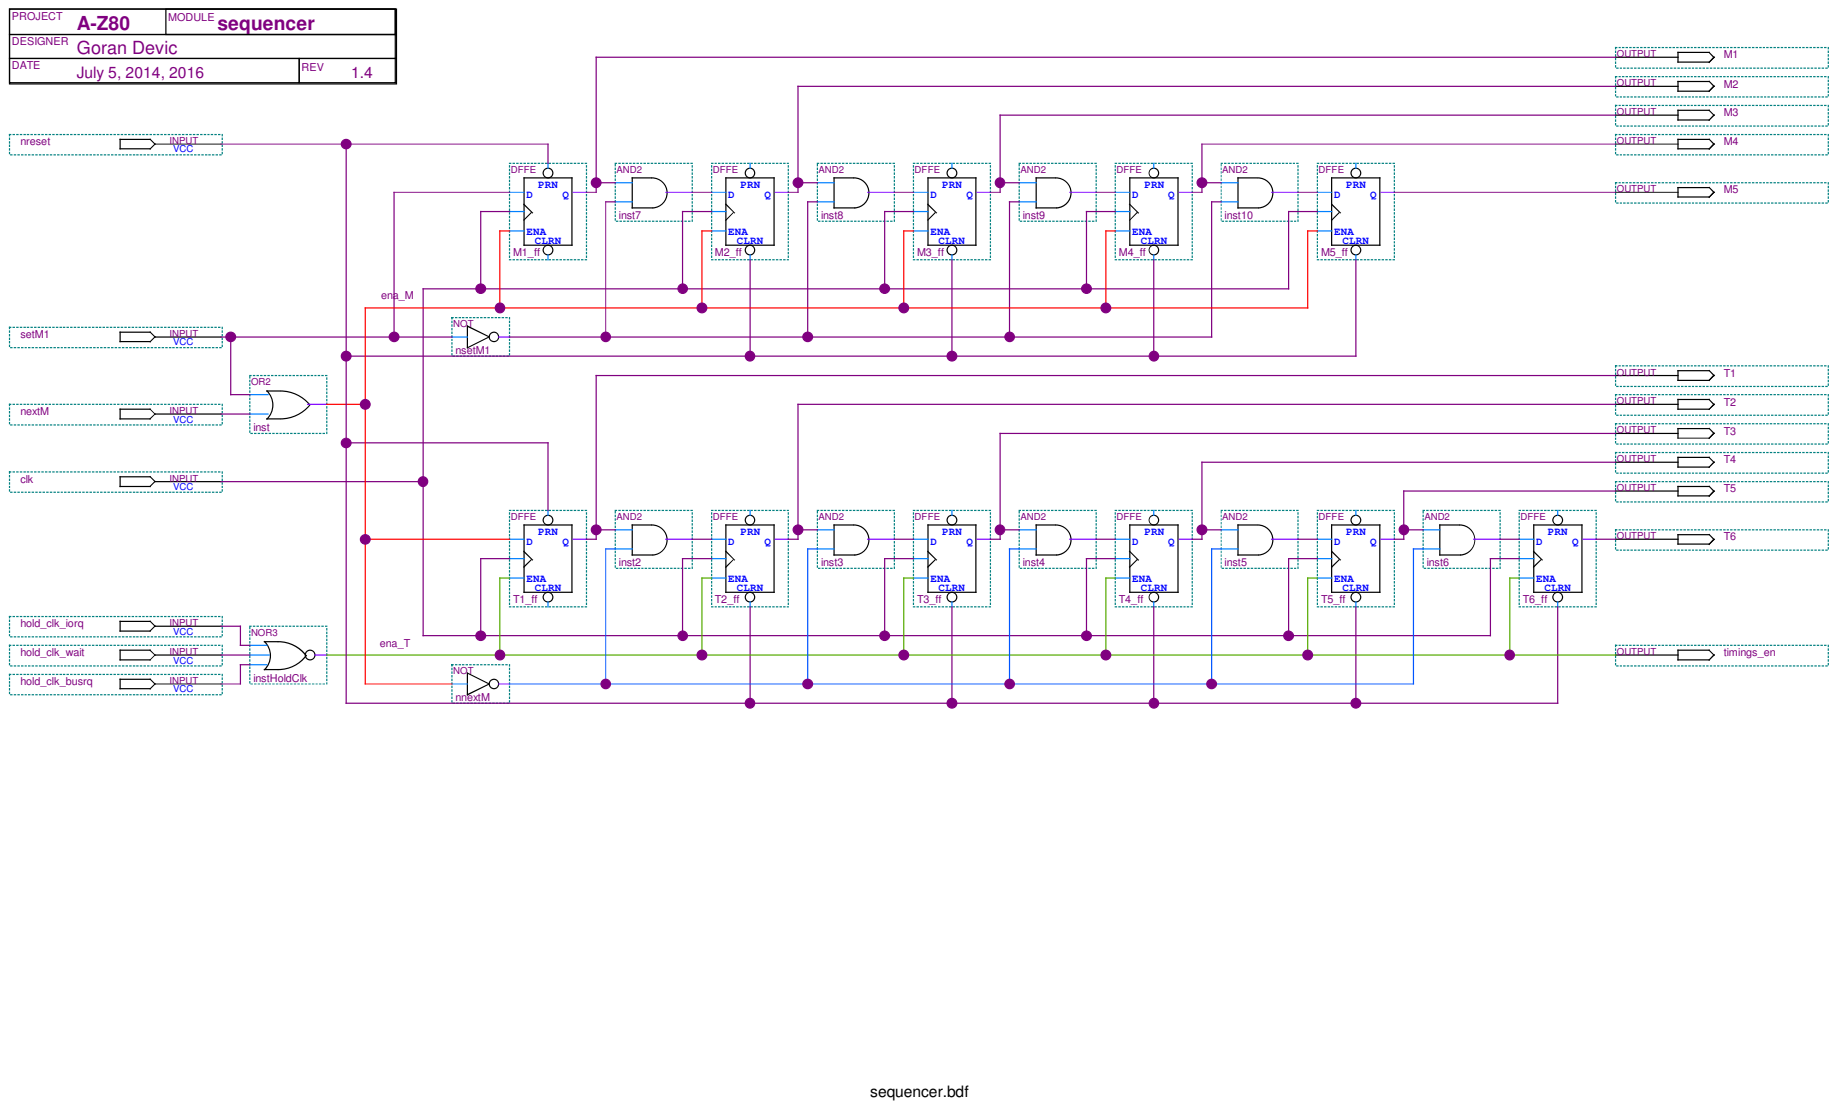
[picture p95: page 1]
sequencer.bdf; ena_T; ena_M; VCC clk; INPUT; VCC nextM; VCC setM1; VCC nreset; VCC hold_clk_iorq; VCC hold_clk_wait; VCC hold_clk_busrq; OUTPUT; timings_en; PRN; CLRN; ENA; DFFE; AND2; inst2; inst3; inst4; inst5; NOT; nnextM; inst6; inst7; inst8; inst9; inst10; nsetM1; NOR3; instHoldClk; inst; DATE; July 5, 2014, 2016; MODULE sequencer PROJECT; REV

DESIGNER Goran Devic
