gdevic/A-Z80/host/basic_nexys3/ipcore_dir/ila.v

///////////////////////////////////////////////////////////////////////////////
// Copyright (c) 2016 Xilinx, Inc.
// All Rights Reserved
///////////////////////////////////////////////////////////////////////////////
//   ____  ____
//  /   /\/   /
// /___/  \  /    Vendor     : Xilinx
// \   \   \/     Version    : 14.7
//  \   \         Application: Xilinx CORE Generator
//  /   /         Filename   : ila.v
// /___/   /\     Timestamp  : Tue Feb 23 19:15:38 Central Standard Time 2016
// \   \  /  \
//  \___\/\___\
//
// Design Name: Verilog Synthesis Wrapper
///////////////////////////////////////////////////////////////////////////////
// This wrapper is used to integrate with Project Navigator and PlanAhead

`timescale 1ns/1ps

module ila(
    CONTROL,
    CLK,
    DATA,
    TRIG0) /* synthesis syn_black_box syn_noprune=1 */;


inout [35 : 0] CONTROL;
input CLK;
input [7 : 0] DATA;
input [7 : 0] TRIG0;

endmodule
