gdevic/A-Z80/(commit log)

2014-05-07 z80: Update Verilog test file
    Reset IR to NOP within the loop to cause PLA to trigger every time
    [test_decode.sv]
2014-05-20 z80: Moving bus driver out of the bit selector
2014-05-20 z80: More ALU refinements
    - Added prep-DAA block to compute >9 and ==9
    - Split input shifter to be only the input; separate output bus drivers
2014-05-20 z80: Added special case of SRA to ALU shifter core
2014-05-22 z80: New format of a SystemVerilog test
    Changed few ALU control pins
    Rewrote test to use more SystemVerilog enhancements
    Corrected all bus contention
    [test_alu.sv]
2014-06-13 z80: Register file: colored a switch
2014-06-13 z80: Adding a data switch block
    This is a simple switch ("SW") on the data bus
2014-06-17 z80: Changed alu shifter core
    Now with simpler control wires for shift left/right
    Load is derived from the absence of left/right shift signal
2014-06-29 z80: Adding alu_control and test for it
    - Currently the shifter and DAA control in it
2014-07-06 z80: Adjusted bus module
    - Fixed up names of several blocks, schematic realignment etc.
    [address_latch.v, control_pins.v, data_pins.v, test_pins.sv]
2014-07-06 z80: Adjusted register module
    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
    [reg_control.v, reg_file.v]
2014-07-07 z80: Chnaged control int pin name to intr
2014-07-07 z80: Update pin control
2014-07-08 z80: Adding initial test framework for top
2014-07-08 z80: Update gitignore with Modelsim stack trace file
2014-07-11 z80: Changed pin name db to abus in address latch
2014-07-12 z80: Correcting ctl variables
    [z80_top.sv]
2014-07-12 z80: Correcting ctl variables and other top work
    [z80_top.sv]
2014-07-23 z80: Add a 2-cycle delay for the interrupt function
    - New delay block acting on modified sequencer
    - Added test for function cycles
2014-07-23 z80: Adding the control interrupts block
    - Contains IFF2/IFF2 flags
    - Contains IM[2] register
2014-07-23 z80: New script to parse for control wires
    - Updated genexec.py to only generate execution matrix
    - New script, genref.py to parse .v and .sv files for ctl_ wires
2014-07-23 z80: Adding genglobals.py script
    - Generate a list of global wires to be included in the top-level
2014-07-26 z80: Moving schematic diagrams to be able to export them..
    - Quartus chops the diagrams if it is not in some virtual center (?)
2014-07-28 z80: Correcting some signal names for top-level
    - Control signals that do not originate at the execution unit should
    not start with "ctl_"
    [data_pins.v, genglobals.py]
2014-07-29 z80: Fixing global db connection
    - Using 'wire' instead of 'logic' in the globals since
    'logic' can't deal with bidirectional buses
    [genglobals.py]
2014-08-08 z80: Routed control wires for data bus switches
2014-08-08 tools: Start to add a new PLA flow
    - Adding a script to process pristine PLA table
    - Start changing the pla checker tool to work with a new PLA table
2014-08-09 z80: Adding module decode_state
    - Contains flip flops for IX/IY, HALT and opcode tables (CB, ED)
    [decode_state.v]
2014-08-09 z80: Connecting the decode prefix[]
    - Also tying up some other loose ends
    [decode_state.v, reg_control.v, z80_top.sv]
2014-08-09 z80: Connecting interrupts and adding more exec logic
2014-08-09 z80: Adding the master timings spreadsheet
    [Timings.csv, Timings.xlsm]
2014-08-10 z80: Wiping clean existing timing matrix to start from scratch
    [Timings.csv, Timings.xlsm]
2014-08-10 z80: Corrections to the interface
    - And one logic fix in interrupts
    [interrupts.v, z80_top.sv]
2014-08-10 z80: Made the sequencer self-starting after a reset
    [sequencer.v]
2014-08-10 z80: Adding tb RAM interface
    - Also correcting control pins n-variation and using it as default
    - More control for T1/T2
    [tb_ram.sv, test_top.sv, z80_top.sv]
2014-08-10 z80: Fixing the top-level address latch+incrementer
    [address_latch.v]
2014-08-10 z80: Improving schematic for inc_dec_2bit
2014-08-12 z80: Updated testing
    [Timings.csv, Timings.xlsm]
2014-08-13 z80: add write control wire to the data bus pads module
2014-08-15 z80: New timing spreadsheet and script to process it
    [Timings.csv, Timings.xlsm]
2014-08-15 dongle: Fixed action counter check
    [Z80_dongle.ino]
2014-08-16 z80: Add reset block; updated timings and top level
    [Timings.csv, Timings.xlsm]
2014-08-16 z80: Improved exec matrix generator script
    - Stash and print errors, handle spaces in the section names
    [genmatrix.py]
2014-08-17 z80: Adding the (global) FPGA reset
    - Needed by ModelSim to start the reset sequence with known values
    at the schematic level
    [reset.v, test_reset.sv, z80_top.sv]
2014-08-19 z80: Improvements to the genmatrix script
    - Replace // style comments with /* ... */
    - Better handling of multiline macros
    - Adjusted output format
    [genmatrix.py]
2014-08-19 z80: Updated timings and execution engine
    [Timings.csv, Timings.xlsm]
2014-08-19 z80: Using fpga_reset in initial block and for blocking PC/IR init
    Specific to Modelsim, some modules in the schematics need to be pre-initialized
    to avoid starting simulations with unknown values in selected flip flops.
    When synthesized, the CPU RESET input signal will do the work.
    [z80_top.sv]
2014-08-19 z80: Corrected internal register latch name
    [reg_file.v]
2014-08-19 z80: Updating RAM module to print some messages
2014-08-19 z80: Adding Fuse tests
    - Fuse is a Z80 simulator. It contains some instruction test vectors
    - Adding those test vectors and a script that creates SV test out of
    these test vectors
2014-08-20 z80: Added total clock limit for Fuse testing
2014-08-20 z80: Implement pla[7]
    [Timings.csv, Timings.xlsm]
2014-08-21 z80: Fixing read T3 cycle
    [genfuse.py, tb_ram.sv]
2014-08-21 z80: Adding ALU exec macros; conditions
    [Timings.csv, Timings.xlsm]
2014-08-21 z80: Adding ALU operation PLA entries
    [Timings.csv, Timings.xlsm]
2014-08-21 z80: optionally print multi-ctl_ on separate lines
2014-08-21 z80: Moved the default M1 cycle engine to table/script
    [Timings.csv, Timings.xlsm]
2014-08-21 z80: Changed reg latch wire name from oen to oe
2014-08-22 z80: Updating execution matrix, timings
    [Timings.csv, Timings.xlsm]
2014-08-22 z80: Improved fuse tests
    - Prevent initial reset to update PC and IR
    - Prevent initial 2T overlap instruction execution
    - Correctly read/write all test registers
    [genfuse.py, test_fuse.sv]
2014-08-22 z80: Adding a simple fuse test so the ModelSim has it
    - This test is generated by a script
2014-08-23 z80: Corrected few regfile submodule instance names
    [reg_file.v]
2014-08-23 z80: Corrected fuse test gen; updated execution engine
    [Timings.csv, Timings.xlsm]
2014-08-23 z80: Adding more debug wire names to ALU
2014-08-23 z80: ALU work
    [Timings.csv, Timings.xlsm]
2014-08-24 z80: Implemented RRD and RLD instructions
    [Timings.csv, Timings.xlsm]
2014-08-24 z80: Corrected flag logic; impl. RLCA-family
    [Timings.csv, Timings.xlsm]
2014-08-25 z80: Adding regression testing to fuse tests
2014-08-25 z80: Add "Comments" column to the matrix; ignore it
    [Timings.csv, Timings.xlsm]
2014-08-25 z80: Removed obsolete lda wire
    [Timings.csv, Timings.xlsm]
2014-08-25 z80: Adding alu operation, nibble as separate columns
    [Timings.csv, Timings.xlsm]
2014-08-25 z80: Corrected prefix decode
    [Timings.csv, Timings.xlsm]
2014-08-25 z80: Corrected ALU control unit; impl. bit/set/res
    [Timings.csv, Timings.xlsm]
2014-08-26 z80: Correctly connect IX/IY control to register select
    [reg_control.v]
2014-08-26 z80: Adding timings for ld (ix+d)
    [Timings.csv, Timings.xlsm]
2014-08-27 z80: Fixed up CF/HF control in flags/control
    [alu_flags.v]
2014-08-27 z80: Moved NF to individual ALU pla entries
    [Timings.csv, Timings.xlsm]
2014-08-27 tools: Add script to connotate fuse tests
    - Adds Z80 mnemonics to all fuse test files
2014-08-27 z80: Fixed the behavior of NF flag in schematic
    [alu_flags.v]
2014-08-27 z80: Fixed NF; added cpl to HF
    - Completes all instructions from the general ALU block
    [Timings.csv, Timings.xlsm]
2014-08-27 z80: Fixed one PLA entry
    [Timings.csv, Timings.xlsm]
2014-08-27 z80: Fixed 16-bit inc/dec
    [Timings.csv, Timings.xlsm]
2014-08-27 z80: Fixed few cb-instruction blocks
    [Timings.csv, Timings.xlsm]
2014-08-28 z80: Started work on cb+(ix+d) fetch
    - Swapped H/L and ALU columns in the timing table: when we have
    if() we need to define a wire first (H/L)
    [Timings.csv, Timings.xlsm]
2014-08-28 z80: Adding state machine to compute WZ=IX+d
    [Timings.csv, Timings.xlsm]
2014-08-28 z80: Improvement to mem_cell and fixed IX/IY latch
    [decode_state.v, mem_cell.v]
2014-08-29 z80: Added (ix+d) computation; fixed basic ld to use ix
    [Timings.csv, Timings.xlsm]
2014-08-29 z80: Impl. ld (hl),n and its ix sibling
    [Timings.csv, Timings.xlsm]
2014-08-29 z80: Fixed XOR; Impl. add/sub/.. with (ix+d)
    [Timings.csv, Timings.xlsm]
2014-08-29 z80: Impl. 8-bit inc/dec and their ix family
    [Timings.csv, Timings.xlsm]
2014-08-29 z80: Made (ix+d) use CF2 instead of CF
    [Timings.csv, Timings.xlsm]
2014-08-30 z80: Comment out reset of PC/IR (when running Fuse tests)
    - Need to find a cleaner way to condition these out!
2014-08-30 z80: Impl. load to and from I, R
    [Timings.csv, Timings.xlsm]
2014-08-30 z80: Impl. 16-bit add/sub/sbc
    [Timings.csv, Timings.xlsm]
2014-08-30 z80: Fixed Fuse test to correctly test PC register
    [genfuse.py, test_fuse.sv]
2014-08-30 z80: Fuse script to clear IR register before each instruction
    - NOP is needed so that a new instruction does not execute its M1:T1/T2
2014-08-30 z80: Impl. several condition based instructions
    [Timings.csv, Timings.xlsm]
2014-08-31 z80: Impl. djnz
    [Timings.csv, Timings.xlsm]
2014-08-31 z80: Impl. jr ss, e
    [Timings.csv, Timings.xlsm]
2014-08-31 z80: Impl. jr e
    [Timings.csv, Timings.xlsm]
2014-08-31 z80: Impl. retn
    [Timings.csv, Timings.xlsm]
2014-08-31 z80: Adding a data switch with a mask[5:3]
2014-08-31 z80: Impl. rst n instruction
    [Timings.csv, Timings.xlsm]
2014-08-31 z80: Correcting the location of address=1 check
    [address_latch.v]
2014-09-01 z80: Impl. block LD and CP instructions
    [Timings.csv, Timings.xlsm]
2014-09-01 z80: Started impl. IN/OUT instructions
    [Timings.csv, Timings.xlsm]
2014-09-01 z80: Adding IO maps to simulation and fuse tests
    - Now the IN/OUT instructions can be checked correctly
    [genfuse.py, tb_io.sv, test_fuse.sv, test_top.sv]
2014-09-01 z80: Impl. simple OUT instructions
    [Timings.csv, Timings.xlsm]
2014-09-01 z80: Impl bit/set/res with (ix+d)
    [Timings.csv, Timings.xlsm]
2014-09-02 z80: Impl. shift (ix+d) instructions
    [Timings.csv, Timings.xlsm]
2014-09-02 z80: A separate wire from cf latch to shifter
    - Fixes few incorrect input shifter problems (rla etc.)
    [alu_flags.v]
2014-09-02 z80: Added testing for register banks to Fuse script
2014-09-02 z80: Fixing handling of XF,YF for bit instructions
    - The IX+d process writes XF,YF with WZ
    [Timings.csv, Timings.xlsm]
2014-09-02 z80: Impl. NEG instruction
    [Timings.csv, Timings.xlsm]
2014-09-03 z80: Fixed instr with (nn) where we needed a register gate
    [Timings.csv, Timings.xlsm]
2014-09-03 z80: Corrected inc/dec saving CF
    [Timings.csv, Timings.xlsm]
2014-09-03 z80: Impl. cpl, scf, ccf
    [Timings.csv, Timings.xlsm]
2014-09-03 z80: Fixed a typo in PLA69
    [Timings.csv, Timings.xlsm]
2014-09-03 z80: Fixed (ix+d) computation using CF2
    [Timings.csv, Timings.xlsm]
2014-09-03 z80: Impl. 1/2 of DAA instruction
    [Timings.csv, Timings.xlsm]
2014-09-03 z80: More work on DAA
    [Timings.csv, Timings.xlsm]
2014-09-03 z80: Removed a special case in execute
    - Not need commenting out the code for Fuse tests vs other runs
2014-09-03 z80: Corrected ldir/cpir
    [Timings.csv, Timings.xlsm]
2014-09-04 z80: Impl. inir/otir set of instructions
    - Not getting correct flags yet
    [Timings.csv, Timings.xlsm]
2014-09-04 z80: have RAM and IO models optionally print debug text
2014-09-04 tools: Adding the boot and execute code
    - Boot code starts the test system at 0
    - Provides BDOS services to print char and string message
    - Exec code starts at 100h and prints "Hello, World!"
    - Scripts that assemble and copy boot code and exec code
2014-09-04 z80: IO fix duplicate print characters due to 2T IO
    [tb_io.sv]
2014-09-04 tools: Adding Z80 assembly code to produce DAA variations
2014-09-05 z80: Re-arranged the matrix to set P/V separately
    [Timings.csv, Timings.xlsm]
2014-09-05 z80: Changed the DAA logic
    - Adding HF2 flag
    - This fixes DAA calculation
    [alu_flags.v]
2014-09-05 z80: Impl. DAA correctly
    [Timings.csv, Timings.xlsm]
2014-09-05 z80: Fixing IO module break (compare with == vs ===)
    [tb_io.sv]
2014-09-05 z80: Impl. HALT instruction (entry into)
    [Timings.csv, Timings.xlsm]
2014-09-05 z80: Impl. IM <mode> instruction
    - Read the actual mode directly from the db0[4:3] instead of
    a control wire
    [Timings.csv, Timings.xlsm]
2014-09-05 z80: Correctly reset NMI input latches
    [interrupts.v]
2014-09-05 z80: Renamed a wire to ctl_66_oe
2014-09-05 z80: Initial impl. of interrupt and NMI handling
    [Timings.csv, Timings.xlsm]
2014-09-06 z80: Corrected output of the 0xFF driver
    [bus_control.v]
2014-09-06 z80: More NMI handling work
    [Timings.csv, Timings.xlsm]
2014-09-06 z80: New ctl_no_ints to inhibit interrupts during DI,EI,CB,...
2014-09-06 z80: NMI: disable incrementer on PC, add more NMI control wires
    [Timings.csv, Timings.xlsm]
2014-09-06 z80: test top sample code to infuse NMI
2014-09-07 z80: Added glitch prevention to the output timing drivers
    Due to the timing differences between internal T-states (from the sequencer)
    and the actual clock tree, with this particular implementation, there was
    considerable glitching on the output signals.
    This set of flops helps convert timings from the internal T-states into
    external clk-based timings by bridging the desired active periods across
    clk pulses.
2014-09-07 z80: Impl all flags of LDI/CPI/...
    [Timings.csv, Timings.xlsm]
2014-09-07 z80: More work on undoc flags of INIR,...
    [Timings.csv, Timings.xlsm]
2014-09-07 z80: Using new NF path
    [Timings.csv, Timings.xlsm]
2014-09-07 z80: Fixing the tb_io - no need to count even chars
    - Guess the glitch removal fixed this
    [tb_io.sv]
2014-09-08 z80: Initial INT implementation
    - Made fFetch always M1
    - New NMI/INT logic circuit
    - NMI and INT clear appropriate IFFx in the logic
    - Adding a new test module, tb_iorq, to issue FF on the bus
    - Boot Z80 code, add RST38 handler (doubles as INTR handler)
    [Timings.csv, Timings.xlsm]
2014-09-08 z80: Impl. interrupt handing for IM2
    [Timings.csv, Timings.xlsm]
2014-09-08 z80: Updating readmes, waves and some old tests
    - Some tests are broken. Will not fix.
    [test_pins.sv]
2014-09-09 host: Adding host UART module
2014-09-09 z80: Renamed module "reset" to "resets" not to name collide with a signal name
    [resets.v, test_reset.sv, z80_top.sv]
2014-09-09 host: Remodelling the UART
2014-09-09 z80: Adding pin location to the top level, just because...
2014-09-09 host: Fixing uart code
2014-09-09 z80: Changed some control_pins names to avoid collision with top-level names
    [z80_top.sv]
2014-09-09 z80: Changed address pin name to avoid collision with a global name
    [z80_top.sv]
2014-09-10 host: uart and host: make them use positive signalling logic
2014-09-11 z80: Various fixes while trying to make FPGA live
    [host.sv, test_host.sv]
2014-09-12 z80: Return fpga_reset to execute to prevent PC/IR being clared during Fuse tests
2014-09-12 tools: Adding generated hex file for host test
    - Also UART print the character for debug
2014-09-12 z80: Updating and fixing the host test program and memory addressing
    [host.sv, test_host.sv]
2014-09-13 z80: Split reset into two phases
    [resets.v]
2014-09-15 z80: Fixing top host modelsim test
    [host.sv, test_host.sv]
2014-09-15 z80: Removing PLL; fixing the host ModelSim test
    [host.sv, test_host.sv]
2014-09-18 z80: Removed resetff; PC+IR+AL cleared all at once
    [resets.v]
2014-09-18 z80: Separate address latch control from inc/dec in the timing sheet
    [Timings.csv, Timings.xlsm]
2014-09-18 z80: Pulled out AF loading at M1/T3 from default into each PLA that needs it
    [Timings.csv, Timings.xlsm]
2014-09-18 z80: Made M/T timing more explicit in the spreadheet
    - Detect unknown opcodes using "valid" wire
    - Explicit nextM and setM1 by _all_ PLA entries
    [Timings.csv, Timings.xlsm]
2014-09-18 z80: Shifted PC (and the whole stack!) one cycle earlier
    - Dont need the address latch mux any longer!
    - Still work in progress
    [Timings.csv, Timings.xlsm]
2014-09-19 z80: Finished shifting PC by 1 cycle
    - Also fixed tests to load PC correctly after the reset
    [Timings.csv, Timings.xlsm]
2014-09-19 z80: UART small change in comments
2014-09-20 host: Created support for 2 boards that I have
    - Added readme explaining it
2014-09-21 z80: Adding logic analyzer to the board
    [logic_analyzer.stp]
2014-09-23 z80: New data pin (using a FF) and control code
2014-09-23 z80: Add clock up phase
    - Add clock replacement macros
    - Used for writing opcode register
    [genmatrix.py]
2014-09-23 z80: Re-arranged host boards into one Quartus project + revisions
    - Two physical boards (RedCore and RioRand)
    - One ModelSim board to test
2014-09-24 z80: ALU: Adding alu_latch module + other changes
    - Added alu_latch that enables on a nclk
    - Used alu_latch in alu_flags throughout
    - Added new latch to ALU; add nclk as enable wire
    - Added new latch to alu_control's half-parity latch
    Also: fixed some timings
    Currently failing: RST and LDIR (family)
    [Timings.csv, Timings.xlsm, sigtap_RioRand.stp]
2014-09-24 z80: Added help text to fuse test script
2014-09-25 z80: Updating corresponding SigTap files
    [sigtap_RedCore.stp]
2014-09-25 z80: Assign a pin to mute a buzzer on Red Core board
2014-09-25 z80: Removed sof from the sigtap file
    [sigtap_RedCore.stp]
2014-09-25 z80: Removed 'do not regenerate' from this schematic
2014-09-26 z80: Fixed up some tests
    [test_bus.sv, test_latch.sv, test_pin_control.sv, test_pins.sv, test_regfile.sv, test_registers.sv, test_reset.sv, test_top.sv]
2014-09-30 z80: Corrected reg file pin alignment
2014-09-30 z80: Removed '-' from timing macros for PF
    [Timings.csv, Timings.xlsm]
2014-09-30 z80: Using a latch instead of flop in mem_cell hold phase
    - This fixed LDIR that got broken during the FPGA port
    [mem_cell.v]
2014-10-01 z80: Improved UART code
2014-10-01 z80: Adding 16K RAM + ZEXDOC test code
    - Modified RedCore board to have only 16K RAM + PLL
    - Run ZEXDOC
2014-10-02 tools: Use copy instead of cp in batch files
    - cp did not work on one Windows 7 (?)
    + optimize commotate fuse script
2014-10-03 z80: Fixed input to NF which fixed DAA instruction
    [alu_flags.v]
2014-10-06 z80: Updated condition circuit in ALU as described by Ken
2014-10-08 z80: Fixing CCF sequence - this fixes a bug in CCF
    [Timings.csv, Timings.xlsm]
2014-10-08 z80: Adding a new Fuse test for CCF
    - This test would catch my CCF bug
2014-10-11 z80: Removed old Quartus projects and revisions
    - Updated .gitignore for the new Quartus /output_files temp folder
    - Updated readme
    [sigtap_RedCore.stp, sigtap_RioRand.stp]
2014-10-11 z80: Cleaning up fpga host board from extra fluff
2014-10-13 z80: Update new Quartus resources for schematic titles
2014-10-13 z80: Using all new title blocks in every schematic
    - Regenerated BSF and V files
    - Corrected dates
    [address_latch.v, alu_flags.v, bus_control.v, clk_delay.v, data_pins.v, decode_state.v, interrupts.v, ir.v]
2014-10-15 ula: Correcting all VGA timing constants
    [video.sv]
2014-10-15 ula: Adding video timings document in docs
    [Spectrum-VGA-timings.xlsx]
2014-10-15 ula: Fixed few compile warnings by extending bit 1 properly
    [video.sv]
2014-10-15 zxspectrum: Initial add of the project files
    [zxspectrum.stp]
2014-10-17 ula: Adding ZX keyboard driver
2014-10-18 z80: Fixed interrupt handling
    - Interrupts broke after IR write on a half-clock was introduced
    - The IR was not being written since, during interrupts, there are Tw1 and T2w cycles in front of T3, so T3 would not have up-half
    - This change fixes interrupt handling; tested with all 3 modes
2014-10-18 z80: Updated sample code for interrupt testing and 'hello world'
2014-10-18 ula: Adding vertical retrace interrupt
    - Also correcting the timings of VGA image (was off by 1 on the trailing edges)
    [test_ula.sv, video.sv]
2014-10-18 z80: Added easier interrupt testing on host
    - KEY1 generates INT
    - KEY2 generates NMI
2014-10-18 zxspectrum: Added keyboard drivers; removed sigtap
    - Initial keyboard support - not connected yet!
    [zxspectrum.stp]
2014-10-18 ula: Created ULA toplevel
    - Added to zxspectrum
    - also added signaltap since it (again) seems to hung without it
    [zxspectrum.stp]
2014-10-19 z80: Quartus/toplevel correcting device speed grade
2014-10-19 z80: Add a counter to Hello,World Z80 test program
    - Useful to test interrupts to see if the CPU rebooted
2014-10-19 z80: Fixed ZF on 16-bit ADC/SBC operations
    - 16-bit arithmetic operation uses ZF calculated over 2 bytes
    [Timings.csv, Timings.xlsm]
2014-10-20 z80: Adding a new fuse test that hits SBC r16,r16
    - This test would have uncovered a problem with 16-bit ZF
2014-10-20 z80: Corrected SF,ZF store timings for 16-bit ADC/SBC
    - This completely fixed these instructions, Fuse test passes
    - Also remove duplicate stores of some flags in several other
    instructions. Verified with Fuse that nothing changed.
    [Timings.csv, Timings.xlsm]
2014-10-21 z80: Timings: Override IR with 00/FF only on primary load
    - On secondary opcode loads (CB..) do not override
    - At those times we are not servicing interrupts
    [Timings.csv, Timings.xlsm]
2014-10-21 z80: Added direct control over the reg file gate
    - Added macros to control in/out with lo/hi granularity
    - New column in the timing matrix document
    - Tested with Fuse and zxspectrum
    [Timings.csv, Timings.xlsm]
2014-10-21 z80: Small correction to the alu test and one Modelsim wave
    [test_alu.sv]
2014-10-22 Z80: control mem_cell changed to DFF - Using a DFF instead of a plain latch for the hold stage to make timings more predictable. The flop is triggered on a clock down edge. - That also required movin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
    [Timings.csv, Timings.xlsm]
2014-10-22 tmon: Correcting the R counter limiter & fixing IM2
    - The Limit16 was set to one clock too late and R overflowed into I register
    - This is related to fixing interrupts in mode 2 (using a vector)
    - Updating all relevant tests (to test interrupts) and files
    [Timings.csv, Timings.xlsm]
2014-10-22 zxspectrum: Corrected PS/2 keyboard clk sampling edge
    [ps2_kbd.sv]
2014-10-22 z80: Correctly clearing HALT state
    - Using a simple SR FF for in_halt
    [decode_state.v]
2014-10-22 zxspectrum: make nINT request shorter
    - Again enable SignalTap to make it work
    - Got to find that timing violation!
    [video.sv]
2014-10-22 zxspectrum: Adding Quartus 11 project files
    - Spectrum 'working' at the moment using those
    [zxspectrum.stp]
2014-10-24 zxspectrum: Timing related changes
    - Added locked PLL and tie reset to it
    - Added initial SignalTap timing file
    - kbd driver on error reset keys
    - Made kdb code run on the cpu_clk
    - Remove 50MHz input clock, not needed
    [ps2_kbd.sv, ula.sv, zx_kbd.sv]
2014-10-28 z80: Minor visual update to the schematic
2014-10-29 zxspectrum: Use global clock driver + SDC
    - Reasonable timing definitions
    - Spectrum seems to work
    [zxspectrum.stp]
2014-10-29 z80: Fixing N flag bit for INI-family of instructions
    [Timings.csv, Timings.xlsm]
2014-10-30 z80: control: Mainly using nreset instead of reset signal
    - Not quite well retested but it seems not to cause any new issues
    [clk_delay.v, decode_state.v, interrupts.v, mem_cell.v, sequencer.v]
2014-10-31 z80: Checkin in what I have, does not work
    - Can't get Spectrum/Z80 to work reliably because of latches
    - It's a whack-a-mole game with Fitter, very flakey
    - Spectrum does not work with this change, use a previous one
    [clocks.sv, zx_kbd.sv]
2014-11-03 z80: New sequencer
    - And fixed up test fuse gen to read registers directly from the flops
    [genfuse.py, sequencer.v]
2014-11-03 z80: ALU control switched to flops
2014-11-03 z80: ALU flags switched to flops
2014-11-04 z80: Complete ALU switched to flops
    - Removed alu_latch
    - Timing changes: cond_flags need to be evaluated at M1/T4 instead of T3 since
    the flags are being loaded at T3 and are not ready until T4
    [Timings.csv, Timings.xlsm]
2014-11-09 z80: Fuse test: fixing HALT expected PC to 0001
    - That's how HALT works
2014-11-09 z80: Massive change: removed ALL latches and used flip flops!
    - Removed global nclk, only the clk is global, inverted locally if needed
    - Corrected genfuse test generator
    - Removed memcell, all registers are now plain flops
    - Totally redesigned sequencer
    - Added address bus mux to work around the absence of transparent latches
    - Fixed various builds
    [Timings.csv, Timings.xlsm]
2014-11-09 z80: Removed reset (use nreset); other fixes
    - Fixed interrupts schematics and timing for DI/EI
    [Timings.csv, Timings.xlsm]
2014-11-10 zxspectrum: Fixed various warnings and timing constrants file
    [zxspectrum.stp]
2014-11-10 zxspectrum: SW0 to enable/disable interrupts
    - LED0 to glow red when ints are disabled
2014-11-10 basic: Fully constrained basic board
2014-11-10 z80: Implemented "MEMPTR" reveal with BIT n,(HL)
    - Passes zexall test for BIT n,(HL)!
    [Timings.csv, Timings.xlsm]
2014-11-12 z80: FINALLY found that bug!! Fix -
    - There was a bug in the timing spreadsheet where the NO_INTS was on
    incorrect line outside the M/T rows for the DD/FD PLA entry. This
    made it not being compiled in and so instructions bit (IY+n) were
    sometimes interrupted after the first opcode byte,...
    [Timings.csv, Timings.xlsm]
2014-11-13 zxspectrum: Adding second ROM and a readme explaining it
    - SW0 selects which ROM to use
    - SW1 enables interrupts
    - KEY0 is reset
    - KEY1 is NMI
    ...
2014-11-13 z80: Correct Fuse test for WZ re BIT n,(HL) result
    - Ever since we fixed BIT n,(HL) to reveal WZ bits, the Fuse tests are
    not correct for this instruction -> Fuse itself is not correct!
    - Initialize WZ to 0x0 in Fuse test scripts
    - This fixed Fuse expected
    [genfuse.py]
2014-11-17 z80: Massive change: Pin timings using flops and not SV
    - Added memory_ifc block that implements the pin timings for MEMRQ, RFSH, RD, WR,...
    - Removed {T} and {M} macros from the timing gen, no need for half-clock signals any longer!
    - Uses the Zilog patented memory refresh/M1 circuit
    - Removed old pin_control.sv and made it into the BDF with whatever's left of it
    - Corrected a number of problems along the way
    - Added BUSRQ logic; float correct pins; added test for busrq/busack
    - Rewrote delay circuits for WAIT, BUSRQ, IO-timings
    - Consequently rewrote large chunks of the sequencer, mainly control made simpler
    - Added a new keys in the timing spreadsheet to arm for memory operations
    [Timings.csv, Timings.xlsm]
2014-11-18 z80: Adding the initial toplevel schematic
2014-11-30 zxspectrum: Removed unused UART module
2014-12-15 z80: Fixing some tests so that they at least compile
    - More test cleanup is needed
    [test_alu.sv, test_bus.sv, test_interrupts.sv, test_latch.sv, test_mux_3z.sv, test_pin_control.sv, test_pins.sv]
2014-12-16 z80: Fixing up ALU tests
    [test_alu.sv, test_core.sv, test_mux_3z.sv, test_prep_daa.sv, test_shifter_core.sv, test_slice.sv]
2014-12-16 z80: Completed fixing all ALU tests
    [test_alu.sv]
2014-12-16 z80: Fixed bus tests
    [test_bus.sv, test_pins.sv]
2014-12-17 z80: Fixed register tests
    [test_latch.sv, test_regfile.sv, test_registers.sv]
2014-12-17 z80: Fixed interrupts tests
    [test_interrupts.sv, test_sequencer.sv]
2014-12-17 z80: Fixed resets tests
    [test_reset.sv]
2014-12-17 z80: Fixed pin control tests
    [test_pin_control.sv]
2014-12-18 z80: Fixed up trailing spaces; copyright messages etc.
    [Z80_dongle.ino, bindump.py, genfuse.py, genglobals.py, genmatrix.py, genref.py]
2014-12-18 z80: Added PDF versions of docs
    Updated VGA timings to render better through Google docs
    [Spectrum-VGA-timings.xlsx]
2014-12-21 zxspectrum: Added signals to green LED
    - LEDG5 lits when a key is being pressed
    - LEDG6 blinks when a speaker/line-in is being toggled
2014-12-21 zxspectrum: Added turbo speed mode switch
    - Turbo speed (3.5 MHz x 2 = 7.0 MHz)
    - Fixed a false clock for ula:beep
    - Fixed unused Kempston input warning
    - Updated documentation to 1.1
    [clocks.sv, ula.sv]
2015-01-23 z80: Slight correction in the script comment
    [genmatrix.py]
2016-01-08 z80: Fixing repeating INIR/OTIR class of instructions
    [Timings.csv, Timings.xlsm]
2016-02-06 Changed 'logic' to 'wire' in all core files (Verilog)
2016-02-08 basic host use new core and several host code changes
    - Fix uart so it does not generate wr_data as a clock
    - Use one PLL with 2 clk_out: one for uart, one for CPU (10 MHz)
    - Remove timing constraints file
2016-02-09 Ported more of the ZX Spectrum board files to Verilog
2016-02-09 Some basic board files partially ported to Verilog
2016-02-09 Cleaning up UART and rewriting to Verilog
2016-02-10 Main exec + include changed wire to reg
    For Verilog, everything is a register.
2016-02-10 Renamed uart files extension from SystemVerilog to Verilog
2016-02-10 Renamed host board fpga file extension from SystemVerilog to Verilog
2016-02-10 Fixed references to ir_ in tests
    [genfuse.py]
2016-02-11 Changed selected reg into wire as required by Xilinx ISE tool
2016-02-12 Moved files around, adding board names to the project
    Created common folder for modules that could be shared
2016-02-12 Switch to using "assign" in the decode matrix
2016-02-13 Changed exec matrix operators from logical to bit-wise
    [Timings.csv, Timings.xlsm]
2016-02-13 Adding Xilinx Nexys3 basic board project
    This is the initial code, still not working.
    [basic_nexys3_fpga.v, clock.v, clock_exdes.v, clock_tb.v]
2016-02-13 uart use localparam, removes a warning message on ISE
2016-02-14 Fixing various warnings
    zxspectrum: Properly size a wire
    Ifdef'ed fpga reset code used only with ModelSim
    [execute.v, zxspectrum_de1.sv]
2016-02-14 z80: Removing iff1 from the module interface, used only within interrupts module
2016-02-14 zxspectrum: corrected video address signal width
    [zxspectrum_de1.sv]
2016-02-14 `ifdef MODEL_TECH on uart $strobe message
2016-02-15 Enable $strobe on UART for Xilinx ISim
2016-02-15 Corrected mif format for ISim (it is simple data list)
    [bin2mif.py]
2016-02-17 z80: Optimizing the execute code
    - Moved if (!nreset) control of several wires out of the execute and
    into their individual blocks to flatten the combinatorial logic one
    level
2016-02-17 z80: Made SetM1 imply NextM control signal
    - Simplifies control and execution matrix
    [Timings.csv, Timings.xlsm]
2016-02-17 de1: Adding timing constraints file + timing driver synthesis
2016-02-18 z80: Use Y instead of 1 in first 3 columns of timing table
    - Makes no actual changes to the timings, only the way spreadsheet looks
    [Timings.csv, Timings.xlsm]
2016-02-18 z80: Exec matrix: "For all undecoded instructions" condition moved to the spreadsheet
    - Moved *from* the hard-coded statements in execute.v
    [Timings.csv, Timings.xlsm]
2016-02-19 z80: Exec matrix: Moved the last setM1 cycle of the fetch/execute overlap to spreadsheet
    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
    [Timings.csv, Timings.xlsm]
2016-02-23 z80: Better processing of exec equations
    (Still not working correctly)
    [gencompile.py]
2016-02-23 z80: Added another potential formatter to make Xilinx work
    - This one uses blocking 'or' for each wire, preserves the order dependency
    - Still need to get a correct format for signals wider than 1 bit
    [execute.v, gencompile.py]
2016-02-23 z80: Corrected a bug in genglobals.py
    [genglobals.py]
2016-02-23 z80: Proper bitwise negation of validPLA
    [Timings.csv, Timings.xlsm]
2016-02-23 z80: Fixed genmatrix script not to generate a trailing space
    [genmatrix.py]
2016-02-24 z80: Adding a simple switch from legacy to compiled exec matrix format
2016-02-25 z80: Fixing a (nasty) bug with PC incrementing on interrupts with new code
    [basic_de1_ModelSim.sv, execute.v, gencompile.py, test_host.sv]
2016-02-27 z80: Changed reset: use clrpc as intended
    - clrpc asserted for 3 extra reset clocks to clear PC/IR
    following the true Z80 behavior
    - Changed address latch accordingly to correctly initialize IR
    [address_latch.v, resets.v, test_bus.sv, test_reset.sv]
2016-02-29 z80: Simplify data bus 0 override logic
    - Move ths functionality from schematic to code
    - Make only one bus writer active at any time
2016-03-01 z80: Starting to fix fuse test harness
    [genfuse.py]
2016-03-01 z80: Fixing the DAA instruction
    [Timings.csv, Timings.xlsm]
2016-03-01 z80: Generate better temp wire names; detect multiple wire assignments
2016-03-02 z80: Correcting the script for the previous change
    [gencompile.py]
2016-03-02 z80: Reverting the last change: Xilinx can't handle it (or it's not Verliog?)
    "Make gen compiled file more compact"
    [gencompile.py]
2016-03-02 z80: Declare and define wire values in the same statement
2016-03-02 z80: Fixed internal db1 bus contention
    [Timings.csv, Timings.xlsm]
2016-03-03 z80: Starting to fix bus db2 contention
    [Timings.csv, Timings.xlsm]
2016-03-03 z80: Resolving most of the bus db2 contention
    [Timings.csv, Timings.xlsm]
2016-03-03 z80: Fixed missing gen wire and ld a,i db2 bus contention
    [Timings.csv, Timings.xlsm]
2016-03-03 z80: Fixing the out instruction
    [Timings.csv, Timings.xlsm]
2016-03-05 z80: New UART model
2016-03-05 Nexys3: Basic host outputs to UART!
2016-03-05 Nexys3: Minor correction to the board.
    [basic_nexys3_fpga.v]
2016-03-06 z80: Cleaned up r8,r8' in the timing macros
    [Timings.csv, Timings.xlsm]
2016-03-09 z80: Fixed IM2 on Xilinx by containing the register bus sw4
    - On interrupt, I register is read but the low byte is passed through
    from the accumulator
    - This fix detects that case and disables sw4 high gate (in front of I)
    so there is only one driver of that bus (I register)
    - Quartus tools work nicely with 3-state buses so this was not needed
    [reg_control.v, reg_file.v, test_regfile.sv, test_registers.sv]
2016-03-09 Updated PNG schematics images
2016-03-09 Adding PDF printouts of all schematic files
2016-03-13 zxspectrum: Remaned reset to nreset
    [ps2_kbd.sv, ula.sv, zx_kbd.sv, zxspectrum_de1.sv]
2016-03-13 zxspectrum: Fixed keyboard bug (by Bogdan S.)
    [zx_kbd.sv]
2016-03-13 zxspectrum: Add custom NMI handler and a function to enter game pokes after pressing the NMI button
2016-03-22 zxspectrum: Corrected bits 7,5 when reading ULA port 254
    [ula.sv]
2016-12-04 Fixed M1 during reset
    Memory_ifc module set M1 to inactive (high) during nRESET
    Exported wait_m1 signal from that module as a testpoint
    [memory_ifc.v]
2016-12-04 zxspectrum: Fix the shift key repeat bug
    When using additional keys (<,>,?,...) and shift was released before
    a symbol, it would repeat. This change fixes that by correctly resetting
    keyboard mask state bitfields.
    [zx_kbd.sv]
2016-12-05 genfuse close output file
    Fixes truncated file when debugging
    [genfuse.py]
2016-12-05 genfuse align individual tests on an even clock
    Reset was being issued on an alternate edge since the total number of
    clocks for each test was odd. This corrects it by inserting a padding
    #1 cycle at the end of each test
    Also some formatting changes to the resulting test_fuse.vh file
    [genfuse.py]
2016-12-07 genfuse add code to test nWAIT insertion at M1
2016-12-07 Fixed nWAIT during M1 cycle
    - hold_clk_wait to gate IR write enable which delays loading new
    opcode into IR until the M1/T3 cycle when it should be loaded
    [ir.v]
2016-12-08 Add host wait state circuitry from Zilog manual
2016-12-08 Add wait state test to basic simulation host
    Select from 3 options to test wait states:
    - no wait state inserted (nWAIT=1)
    - insert a wait state to every M1 cycle
    - insert a wait state to each memory access cycle
    This is hard-coded in the host source.
2016-12-09 Add hold_clk_wait to clrpc signal
    This correctly delays clearing of IR if the nWAIT was asserted at
    the very first M1 cycle.
    [resets.v, test_reset.sv]
2016-12-09 Add hold_clk_wait to register control to delay T-flops
    Fixes bug with EX instructions when nWAIT is asserted
    [reg_control.v, test_registers.sv]
2016-12-10 UART: fixed two synthesis warnings
    [uart.v]
2016-12-10 Add hold_clk_wait to ALU CFL latch
    This correctly delays latching the C-Flag for CCF instruction when
    nWAIT was asserted at that instruction's M1/T2 cycle
    [alu_flags.v]
2016-12-10 zxspectrum: Fix few Quartus warnings
    [i2s_intf.vhd, zx_kbd.sv]
2016-12-10 Simplify by adding nhold_clk_wait
    Inverted version is used to feel AND gates to enable
    Keep hold_clk_wait used only in the sequencer
    [alu_flags.v, clk_delay.v, decode_state.v, ir.v, memory_ifc.v, reg_control.v, resets.v, test_registers.sv]
2017-01-12 Fixed Xilinx basic_nexys3 build
    Quartus can handle parameter sizing differently, but this is the
    correct way that works for both tools.
    [uart.v]
2017-12-04 Corrected unconnected enable line
    [memory_ifc.v]
2017-12-05 Correctly latch IO RW wait request
    Fixed bug: Issuing nWAIT during IO RW was ignored (IORQ, not M1)
    Taping into a correct point of IORQ generator sequence train gives
    an additional signal to be OR-ed when composing a generic latch_wait
    [memory_ifc.v]
2018-12-11 Revert "Corrected unconnected enable line" in memory_ifc module. Fixes erroneous extra delay of nIORQ signal on INT ACK.
    [memory_ifc.v]
2020-05-05 Update zmac assembler to version 5jan2019
